PotatoPeaSea/Rocky/README.md

# Rocky — pentapod walker

Five-legged walking robot inspired by Rocky (Project Hail Mary).

- `fusion/` — Fusion 360 build scripts and BOM
- `pcb/` — integrated control PCB (KiCad): schematic, layout, STEP, fab outputs
- `sim/` — MuJoCo model and RL training environment
- `docs/` — design notes
