PotatoPeaSea/Rocky/pcb/rocky_ctrl/DESIGN.md

# Rocky control board v1 (`rocky_ctrl`)

This is the integrated controller for the Rocky pentapod (v6). It replaces the v5 module stack: ESP32-DevKitC, BusLinker V3, WAGO hub, LM2596, Pololu D36V50F5, the inline fuse and the battery divider. It is a single ring-shaped board that sits on the logic deck around the Raspberry Pi 5.

| | |
|---|---|
| Outline | Ø156 mm ring (r 78) with a Pi 5 cut-out (x −53..40, y −31..30), a Pi USB-C plug notch (x −47..−31, y −50..−31) and a battery-lead notch over deck hole B (x −8..8, y < −60) |
| Stack-up | 4 layers, 1.6 mm, 1 oz outer / 1 oz inner (JLC "1 oz inner" option). L1 signals + pours, L2 GND plane, L3 VSERVO plane, L4 signals + GND pour |
| MCU | ESP32-WROOM-32E-N8 (classic ESP32: BT Classic for Bluepad32, v5 firmware ports directly) |
| Servo I/O | 2 half-duplex UART buses (bus A = UART1: legs 1-3; bus B = UART2: legs 4-5), 5 × Molex SPOX 5267-03A leg connectors |
| Power | XT60 in → 20 A ATM blade fuse → P-FET reverse-polarity protection → (a) ESP32-switched, soft-started servo rail with 1 mΩ / INA180 current sense and 2 × 1000 µF, (b) 5 V / 5 A buck for the Pi 5 (TPS54560B), (c) 3.3 V / 2 A buck (AP63203, diode-OR battery / USB) |
| Software | KiCad 9.0 (files are KiCad 9 format; KiCad 8 cannot open them) |

Everything in the project (schematic, board, custom symbols, 3D models) is generated by the scripts in `tools/`, and the generators are the source of truth. Edit `tools/design.py` (parts and nets) or `tools/placement.py` (positions), then rebuild (see the end of this file). You can also edit the board by hand in KiCad from here on: nothing depends on the scripts once the files exist.

---

## 1. Block diagram

```
 3S LiPo ──XT60 loop key──► J1 XT60PW-M ──► F1 20 A ATM ──► D1 SMBJ15A TVS
                                                   │
                                     Q1 P-FET (reverse polarity, 3 mΩ, bidirectional so servo regen returns to the pack)
                                                   │ VBAT_P (9-12.6 V)
         ┌─────────────────────────────┬───────────┴──────────────┬──────────────────────────────┐
         ▼                             ▼                          ▼                              ▼
 Q2 P-FET high-side switch     U2 TPS54560B buck          D3 ┐ diode-OR                 R11/R12 → IO34 (VBAT)
 (Miller soft-start,           500 kHz, 5.09 V / 5 A      D4 ┘◄─ USB VBUS
  default OFF, IO23)                   │                    │ V_LOGIC
         │ VSERVO_SW                   ▼ +5V                ▼
 R6 1 mΩ shunt ─ U1 INA180A3 → IO35    J2 VH-3 → USB-C       U3 AP63203 → +3V3 (ESP32, CH340C, logic)
         │ VSERVO (In2 plane)          pigtail → Pi 5
   2 × 1000 µF + 22 µF / leg           JP1 → VIO (bus level 3.3 V default / 5 V)
         │
 J5..J9 leg connectors (GND, VSERVO, SIG)
         ▲ SIG_Ln (33 Ω + ESD)
 bus A ── U8 SN74LV1T126 (TX, OE=RTS) / U9 SN74LV1T125 (RX, OE#=RTS) ── UART1 (IO17/IO16/IO4)   legs 1,2,3
 bus B ── U10 / U11                                                  ── UART2 (IO25/IO26/IO27)  legs 4,5

 USB-C J3 ─ USBLC6 ─ CH340C ─┬─ auto-reset (2 × MMBT3904) → EN / IO0
                             └─ TXD ─► U6 74LVC1G3157 mux ─► ESP RXD0     (USB present → USB, else Pi)
 Pi 5 GPIO pins 5-14 ◄─ 2×5 ribbon ─ J4: GPIO14/15 UART ↔ UART0, GPIO17 → EN, GPIO27 → IO0, GPIO4 ← IO32
 IMU: Adafruit BNO085 breakout on the v5 IMU bosses, STEMMA QT J10 (I2C IO21/22) + J11 INT/RST (IO19/IO18)
```

---

## 2. Research findings: HX-30HM servo and Hiwonder bus

These were open items in v5. Confidence: **H** = published spec, **M** = consistent across Hiwonder sources but not stated for the HX-30HM specifically, **L** = inferred; measure before relying on it.

| Item | Finding | Conf. | Source |
|---|---|---|---|
| Supply voltage | 9-12.6 V (rated torque 30 kg·cm at 11.1 V), so a 3S pack connects directly | H | [OpenELAB HX-30HM page](https://openelab.io/products/hx-30hm-bus-servo) |
| Stall / no-load current | 3 A stall, 100 mA no-load | H | same |
| Connector | 5264-3P (Molex Mini-SPOX 2.50 mm family), 20 cm cable. **The board uses Molex 5267-03A vertical headers, which mate 5264 housings.** | H | same |
| Pin order | GND, VIN, SIG (as on the LX-224HV, the same Hiwonder bus-servo family). The board uses **pin 1 = GND, 2 = VSERVO, 3 = SIG**. Servo-to-servo cables are 1:1, so the header must match the servo's own port: **check the polarity with a meter on one servo before powering a leg**. | M | [LX-224HV manual (RobotShop)](https://cdn.robotshop.com/rbm/a5e9ab51-86bc-497b-adac-003de3088fb7/e/e63d140f-02bf-40ae-b653-378edf7a3fa0/10d5cb4c_lx-224hv-serial-bus-servo.pdf) |
| Bus | Single-wire half-duplex asynchronous UART, 8N1. Hiwonder frame `0x55 0x55 ID LEN CMD params… CHK`, with checksum = ~(ID+LEN+CMD+params). Up to 253 IDs. | H (family) | [LewanSoul/Hiwonder bus servo protocol](https://images-na.ssl-images-amazon.com/images/I/71WyZDfQwkL.pdf), [Bus Servo Controller docs](https://docs.hiwonder.com/projects/Bus-Servo-Controller/en/latest/docs/2.Bus_Servo_Controller_Secondary_Development.html) |
| Baud | **1,000,000 bps default** for the HX-30HM (older LX servos use 115200). The BusLinker V3 supports 8 baud settings up to 1 Mbps, and Hiwonder's own ESP32 example runs `SerialServo(Serial1, 1000000, …)` on GPIO16/17. | H | [OpenELAB HX-30HM page](https://openelab.io/products/hx-30hm-bus-servo), [BusLinker V3 manual](https://docs.hiwonder.com/projects/BusLinker/en/latest/docs/1_BusLinker_V3.0_Servo_Debugging_Board_User_Manual.html), [BusLinker ESP32 development](https://docs.hiwonder.com/projects/BusLinker/en/latest/docs/2_ESP32_Development.html) |
| Logic level | Not published. Hiwonder wires an ESP32 (3.3 V) straight to the BusLinker TTL port, and their single-servo debug guide shorts a USB-TTL adapter's TXD and RXD onto SIG. The servo therefore accepts 3.3 V signalling, and its input is very likely 5 V tolerant. **The board defaults to a 3.3 V bus, with a solder jumper (JP1) for 5 V.** | L/M | [Hiwonder forum: single bus servo with USB-TTL](https://forum.hiwonder.com/t/debugging-procedure-for-single-serial-bus-servos-with-a-usb-to-ttl-module/190) |
| BusLinker half-duplex circuit | Not documented by Hiwonder. Community reverse engineering and the classic LewanSoul reference use a tri-state buffer pair (74HC126 drives TX onto the line when enabled, 74HC125 returns the line to RX) on a single direction line, which echoes TX. This board uses the same topology with the TI SN74LV1T126/125 level-shifting single gates (TTL-threshold inputs, 5.5 V tolerant), so it works at either VIO. | M | [HiWonder BusLinker servo-bus notes](https://github.com/EtcetFelix/HiWonder-BusLinker-servo-bus), [74HC125/126 datasheet](https://static.chipdip.ru/lib/199/DOC030199307.pdf) |
| BusLinker V3 supply | 5-14 V, and it passes the external supply through to the servo ports | H | BusLinker V3 manual (above) |

**Recommended bring-up test (5 min):** connect a single servo to leg 1, keep VIO at 3.3 V and run `SERVO_ID_READ` at 1 Mbps. If replies are flaky over the 20 cm + leg cable, bridge JP1 to 5 V.

### Why two UART buses
At 1 Mbps a Hiwonder move command is 10 bytes (100 µs) and a position read is 6 bytes out plus 8 back, plus about 50-100 µs turnaround (≈ 250-300 µs). A full cycle on one bus (15 writes + 15 reads) takes about 6 ms, so roughly 150 Hz. Splitting legs 1-3 (IDs 1-9) on UART1 and legs 4-5 (IDs 10-15) on UART2 roughly halves that, giving a 250-300 Hz control loop. It also isolates a shorted or unplugged leg cable to one bus. The ESP32 has only three UARTs and UART0 is the console/Pi link, so two buses is the maximum. Use ESP-IDF `UART_MODE_RS485_HALF_DUPLEX` with RTS on IO4 and IO27: the driver raises RTS during TX, which enables the '126 driver and tri-states the '125 receiver. That suppresses the echo, and the 10 k pull-up on the RX pin keeps it idle.

---

## 3. Power and current budget

| Load | Typical | Peak | Worst case / design limit |
|---|---|---|---|
| 15 × HX-30HM | 0.1 A each idle (1.5 A); about 5-10 A total walking (estimate) | 15-20 A for brief bursts (many joints accelerating) | 45 A if all stall. This is not sustainable: the 20 A fuse and firmware current limiting (INA180) bound it. |
| Raspberry Pi 5 + cooler (5 V) | 1.5-3 A | 5 A | 5 V × 5 A / 0.88 / 9.6 V ≈ **3.0 A from the pack** |
| ESP32 + CH340 + logic (3.3 V) | 0.1-0.25 A | 0.5 A (BT TX) | about 0.2 A from the pack |
| **Total through F1** | 7-13 A | ≈ 20 A | **20 A fuse** (ATM mini blade; 200 % is held for 0.15-5 s, so stall bursts pass and sustained overload opens) |

- **Fuse:** 20 A is the v5 value and matches 14 AWG pack wiring and the XT60 (30 A continuous). A 25 A blade fits the same holder if 20 A proves nuisance-prone. The fuse protects the wiring; firmware should limit servo current: trip `SERVO_EN` low at a sustained ISERVO > 15 A.
- **Copper (IPC-2221, external, 1 oz, ΔT ≈ 20 °C):** about 3.7 A per mm of width.
  - **XT60 → fuse → Q1:** 4 mm tracks duplicated on F.Cu and B.Cu inside pours roughly 8 mm wide on both layers, so ≥ 25 A continuous. Path length is under 25 mm.
  - **Q1 → Q2 (VBAT_P):** F.Cu pour (3 mm) plus 2.4 mm F/B tracks plus a 5 mm B.Cu pour joined by 4 vias. About 20 A, and only 10 mm long.
  - **Q2 → shunt (VSERVO_SW):** about 4 mm F.Cu pour over 5 mm. About 15 A continuous, 20 A transient. This is the weakest section; see the risks.
  - **Shunt → servo plane:** 9 × 0.8/0.4 mm vias (≈ 1.5-2 A each) into the L3 VSERVO plane. The plane is a 17-40 mm wide 1 oz ring, about 2 mΩ to the farthest leg along the two parallel paths, so under 30 mV drop at 10 A.
  - **Leg connectors:** THT pins tie directly into the VSERVO plane, with GND to the L2 plane and both outer pours.
- **Per leg:** up to 9 A stall (3 servos), but each SPOX/5264 contact is rated about 3 A. That is the same limit as the servo's own chain connector, so the board is not the bottleneck. Normal walking is 1-3 A per leg.
- **Bulk capacitance (servo rail):** 2 × 1000 µF / 35 V low-ESR (Panasonic FR 12.5×20; about 20 mΩ and 2.2 A ripple each) plus 22 µF ceramic at every leg connector and 10 µF at the switch.
  - **Sizing:** the battery lead plus loop key is about 250 mm of 14 AWG pair, roughly 0.3-0.5 µH and 20-30 mΩ. For a 10 A load step and ≤ 0.5 V droop the rail needs Z ≤ 50 mΩ, and C ≥ L/Z² ≈ 0.5 µH / (0.05 Ω)² ≈ 200 µF to damp the cable LC. 2000 µF gives a 10× margin and absorbs regenerated energy.
  - **Regenerated energy:** when the rail is switched off, back-driven servos push current through Q2's body diode into VBAT_P and on into the battery, because Q1 is a plain P-FET (not an ideal diode) and conducts both ways. With the battery unplugged, 2000 µF from 12.6 V to 16 V absorbs 0.1 J, and D1 clamps above that.
- **Soft start:** Q2's gate ramps through 33 kΩ into 220 nF of Miller capacitance, about 1.2 V/ms. Charging 2 mF therefore draws ≈ 2.5 A of inrush for about 10 ms instead of a spark. Turn-off takes about 20-30 ms (100 k gate pull-up), which is fine for an e-stop.
- **5 V buck (TPS54560B):** 4.5-60 V in, 5 A, external Schottky. Settings: 500 kHz (RT 191 k), Vout = 0.8 × (1 + 53.6/10) = 5.09 V, L = 4.7 µH SRP1245A (Isat 21 A), Cout 4 × 22 µF, type-II compensation 16 k / 3.9 nF / 39 pF (crossover ≈ 40 kHz), EN UVLO ≈ 7.9 V on and 7.6 V off.
  - About 88 % efficient at 5 A, with ≈ 1.2 W in D2.
  - **Verify the compensation in TI WEBENCH or with a load step.**
- **Pi 5 power path:** the board drives the Pi's own USB-C input (through its protection and PMIC) with a short USB-C plug pigtail from J2 (JST VH-3: 5 V / GND / CC). J2 pin 3 presents Rp = 10 k (3 A Type-C advertisement) if the pigtail has a CC wire. There is no USB-PD, so the Pi sees a non-5 A supply.
  - Put `usb_max_current_enable=1` in `/boot/firmware/config.txt`, or `PSU_MAX_CURRENT=5000` in the EEPROM (`rpi-eeprom-config`). Otherwise the Pi limits its USB ports to 600 mA and warns at boot.
  - Feeding the GPIO 5 V pins was rejected: it bypasses the Pi's input protection, and a 2.54 mm ribbon cannot carry 5 A.
  - The 2×5 ribbon carries no 5 V.
  - The ESP32 can cut the Pi supply (IO33 → Q4 pulls EN low; the default is Pi on).
- **3.3 V (AP63203, 2 A):** fed from VBAT_P or USB VBUS through two SS34 diodes. The ESP32 can therefore be flashed or debugged from USB alone (servo rail and Pi off), and the logic stays up if the Pi buck is disabled.

---

## 4. ESP32 pin map

| ESP32 | Net | Function |
|---|---|---|
| EN | EN | Reset: 10 k/1 µF RC, EN button, CH340 auto-reset, and Pi GPIO17 via 2N7002 |
| IO0 | BOOT | Strap. BOOT button, CH340 auto-reset, and Pi GPIO27 via 2N7002 |
| IO1 / TXD0 | ESP_TX0 | UART0 TX to CH340C RXD and (through 1 k) Pi GPIO15/RXD |
| IO3 / RXD0 | ESP_RX0 | UART0 RX from the 74LVC1G3157 mux: CH340C when USB VBUS is present, otherwise Pi GPIO14/TXD |
| IO2 | LED_STAT | Strap (must be low or floating at boot; an LED to GND is fine). Blue status LED |
| IO4 | BUSA_DIR | UART1 RTS (RS485 half-duplex mode): high = transmit on bus A |
| IO16 | BUSA_RX | UART1 RX (bus A: legs 1-3, servo IDs 1-9) |
| IO17 | BUSA_TX | UART1 TX |
| IO25 | BUSB_TX | UART2 TX (bus B: legs 4-5, servo IDs 10-15) |
| IO26 | BUSB_RX | UART2 RX |
| IO27 | BUSB_DIR | UART2 RTS: high = transmit on bus B |
| IO23 | SERVO_EN | Servo rail enable, active high, 100 k pull-down (off at reset and in boot mode) |
| IO33 | PI_PWR_OFF | High = 5 V Pi buck disabled (100 k pull-down: Pi on by default) |
| IO32 | PI_ATTN | ESP32 → Pi GPIO4 attention/IRQ line (1 k series) |
| IO21 | SDA | I2C SDA (STEMMA QT IMU, spare header), 4.7 k pull-up |
| IO22 | SCL | I2C SCL, 4.7 k pull-up |
| IO19 | IMU_INT | BNO085 INT (10 k pull-up) |
| IO18 | IMU_RST | BNO085 RST |
| IO34 | VBAT_SENSE | ADC1_CH6: battery through 100 k/22 k (12.6 V → 2.27 V) |
| IO35 | ISERVO | ADC1_CH7: servo current, INA180A3 × 1 mΩ = 100 mV/A (0-24 A) |
| IO36 / SENSOR_VP | V5_SENSE | ADC1_CH0: 5 V rail through 22 k/10 k (5.1 V → 1.59 V) |
| IO39 / SENSOR_VN | VSRV_SENSE | ADC1_CH3: switched servo rail through 100 k/22 k (confirms SERVO_EN) |
| IO13 | LED_USER | Yellow user LED |
| IO5 | GPIO5 | Spare header (strap: keep high or floating at boot) |
| IO14 | GPIO14 | Spare header |
| IO15 | GPIO15 | Spare header (strap: boot-log enable) |
| IO12 | – | Not connected (strap MTDI must be low at boot for 3.3 V flash) |

All analog inputs are on ADC1, so they keep working while Bluetooth (Bluepad32) is active. ADC2 is unavailable then.

---

## 5. Connectors

| Ref | Part | Pinout | Notes |
|---|---|---|---|
| J1 | AMASS XT60PW-M (right angle, PCB male) | 1 = GND (−), 2 = VBAT_IN (+) | The mouth faces west (−x). Mate it with the female XT60 on the loop-key lead coming up through deck hole B. |
| F1 | Keystone 3568 mini-blade holder | – | 20 A ATM mini blade fuse |
| J2 | JST B3P-VH-B (3.96 mm) | 1 = +5V, 2 = GND, 3 = PI_CC (Rp 10 k to 5 V) | To a USB-C *plug* pigtail into the Pi 5 power port, 20 AWG, about 8 cm. Leave CC open if the pigtail has no CC wire. |
| J3 | HRO TYPE-C-31-M-12 | USB 2.0 with 5.1 k Rd on CC1/CC2 | ESP32 programming and console. Reach it with the dome off. |
| J4 | 2×5 2.54 mm box header (IDC) | 1 NC (Pi SCL), 2 GND, 3 PI_GPIO4, 4 Pi TXD (GPIO14), 5 GND, 6 Pi RXD (GPIO15), 7 GPIO17 → ESP EN, 8 NC, 9 GPIO27 → ESP IO0, 10 GND | Straight 10-way ribbon. **The Pi-end IDC socket goes on Pi header pins 5-14**, so board pin n = Pi pin n+4 and pin 1 of the socket sits on Pi pin 5. |
| J5-J9 | Molex 5267-03A (SPOX 2.50 mm, mates the 5264 servo plug) | 1 = GND, 2 = VSERVO, 3 = SIG | J5 = leg 1, J6 = leg 2, J7 = leg 3 (bus A); J8 = leg 4, J9 = leg 5 (bus B). Leg numbers are silkscreened. |
| J10 | JST SM04B-SRSS-TB (STEMMA QT) | 1 GND, 2 3V3, 3 SDA, 4 SCL | To the Adafruit BNO085 breakout |
| J11 | 1×2 2.54 mm header | 1 IMU_INT, 2 IMU_RST | Jumper wires to the breakout's INT and RST pins |
| J12 | 1×8 2.54 mm header | 1 3V3, 2 GND, 3 SDA, 4 SCL, 5 IO5, 6 IO14, 7 IO15, 8 +5V | Spare I/O |
| JP1 | 3-pad solder jumper | 1-2 bridged by default = VIO 3.3 V; cut it and bridge 2-3 for a 5 V bus | Bus logic level (TX drivers and bus pull-ups) |
| TP1-TP13 | 1.5 mm test pads | VBAT_F, VBAT_P, VSERVO, 5V, 3V3, GND×2, BUSA, BUSB, V_LOGIC, ESP_TX0, ESP_RX0, ISERVO | |

LEDs: green 3V3 (LED1), green 5V (LED2), red SERVO POWER (LED3, lit whenever VSERVO is live), blue status IO2 (LED4), yellow user IO13 (LED5).

---

## 6. Mechanical placement (robot model frame)

The frame is the v6 model frame: the origin is the body centre on the hip-servo plane, +z is up, leg 1 is on +y, and angles are CCW from +x.

- **Board origin:** the board centre is at robot (0, 0). The KiCad file uses (150, 150) mm for that point; the board X axis is robot +x and KiCad +Y is robot −y.
- **STEP origin:** `rocky_ctrl.step` (and `C:\Users\smart\Documents\Pentapod\hardware\rocky_control_pcb.step`) is exported with `--user-origin 150x150mm`. **STEP x, y = robot x, y**, and the **board underside (laminate bottom) is at STEP z = 0**; the top is at z ≈ 1.6.
- **Placement in Fusion:**

  ```
  PCB_ORIGIN = (0, 0, 60.5)   # mm: board underside on the existing v5 boss tops (deck top 55.5 + 5)
  PCB_ROT    = 0              # deg about z
  ```

  The board is coplanar with the Pi 5 (Pi underside also at z 60.5). The top copper is at z 62.1.
- **Mounting holes** (all on existing v6 deck bosses, so no deck changes are needed):

| Holes | Robot (x, y) | Size | Boss |
|---|---|---|---|
| H3, H4 | (−18, −35.5), (18, −35.5) | M2.5 (Ø2.7) | BL bosses (Ø6, top z 60.5) |
| H5-H8 | (−30.8, 38.2), (−30.8, 63.8), (34.8, 38.2), (34.8, 63.8) | M2 (Ø2.2) | PB bosses (Ø5.2) |
| H9-H12 | (−58.46, 32.56), (−58.46, 50.34), (−38.14, 32.56), (−38.14, 50.34) | M2.5 (Ø2.7) | IMU bosses. Long M2.5 screws go through the Adafruit BNO085 breakout, a 6 mm spacer and the PCB into the boss, so the IMU sits exactly where it was in v5. |

  The BL bosses at (±18, −63.5) are not used as screw points (the XT60 and the 5 V output caps sit over them), but the board rests on them and no THT pin is placed over them. The Pololu bosses are unused and lie inside the Pi cut-out or the free area.
- **Standoff height:** 0. The board sits directly on the 5 mm deck bosses (5 mm air gap to the deck). There are no bottom-side parts; THT leads protrude ≤ 2 mm.
- **Tallest parts (above the board top, z 62.1):**
  - C6 and C7 1000 µF at 20.3 mm (top ≈ z 82.4; C6 at r 70, C7 at r 68; dome inner surface ≥ 93 there)
  - J2 VH at 11.5 mm
  - F1 with fuse at about 17 mm
  - C1 at 11.8 mm
  - XT60 at 8.3 mm
  - the IMU breakout on 6 mm spacers at about 9 mm

  Everything is within the envelope report's ≤ 25 mm rim and ≤ 35 mm (r < 60) limits.
- **Leg connectors** (centre of the 3 pins, rotated tangentially, so the cable leaves outward over the deck edge):

| Leg | angle | (x, y) |
|---|---|---|
| 1 | 90° | (0.00, 72.50) |
| 2 | 162° | (−68.95, 22.40) |
| 3 | 234° | (−42.61, −58.65) |
| 4 | 306° | (42.61, −58.65) |
| 5 | 24° (moved +6° to clear the ESP32 antenna keep-out) | (66.23, 29.49) |

- **Battery input:** the loop-key lead (14 AWG) comes up through deck hole B (0, −71) and the board notch, bends about 90°, and the XT60 plug (body about x −2..10, y −62) mates J1, whose mouth is at x ≈ 10 facing −x.
- **Pi power:** the USB-C pigtail plug sits in the notch x −47..−31, y −50..−31. Use a **straight** plug, or a right-angle plug whose cable exits downward/−y. The v5 right-angle pigtail (cable toward −x) does not fit. The pigtail cable then goes to J2 at (−25, −59.5).
- **Pi link ribbon:** J4 at (−15, 38) to Pi header pins 5-14 (x −37..−27, y 23-26, pin tops z 70.4), about 40 mm of ribbon.
- **ESP32 antenna:** points +x at the east edge (x 70-78, y −2..22). There is a no-copper keep-out on all layers, and the dome is plastic.

---

## 7. Fabrication (JLCPCB)

- `fab/rocky_ctrl_gerbers.zip`: Gerbers + Excellon drill, 4 layers. Order with 1.6 mm, 1 oz outer, **1 oz inner** (or 0.5 oz inner: the VSERVO plane then has double the resistance, about 4 mΩ worst case, still fine), any colour, "specify layer sequence" = F.Cu, In1.GND, In2.PWR, B.Cu.
- `fab/rocky_ctrl_bom_jlc.csv` (Comment, Designator, Footprint, LCSC) and `fab/rocky_ctrl_cpl_jlc.csv` (Designator, Mid X, Mid Y, Layer, Rotation). All parts are top side.
- LCSC numbers are filled in only where they could be confirmed offline; the LCSC website was not reachable from the build machine. The remaining parts have a manufacturer part number in the `MPN` column. Assign LCSC codes for them in JLC's BOM tool, or hand-solder them.
- THT parts are better hand-soldered, or ordered with JLC THT assembly: J1, F1, J2, J4, J5-J9, J11, J12, C1, C6, C7.
- **CPL rotations:** check the preview in JLC's viewer. KiCad-to-JLC rotation offsets typically need fixing for SOT-23, SOIC and the ESP32.
- `fab/rocky_ctrl_schematic.pdf`, `fab/rocky_ctrl_top.png` / `_bottom.png` renders, `fab/*.svg` layer plots, `fab/erc.rpt`, `fab/drc.rpt`.

---

## 8. Firmware notes

- UART1: `uart_set_pin(UART_NUM_1, 17, 16, 4, -1)`, then `uart_set_mode(UART_NUM_1, UART_MODE_RS485_HALF_DUPLEX)`, at 1,000,000 baud. UART2 is the same with pins 25/26/27.
- Turn the servo rail on with `SERVO_EN` (IO23) high **after** checking VBAT_SENSE. Then wait about 30 ms for the soft start and confirm VSRV_SENSE ≈ VBAT.
- Current guard: ISERVO (IO35) gives 100 mV/A. Trip at > 15 A for 200 ms or > 22 A for 20 ms, then drop SERVO_EN.
- Battery: 3S cut-off at 9.6 V (3.2 V/cell). Warn at 10.5 V. The Pi buck's UVLO (≈ 7.9 V) is only a last resort.
- Pi-side flashing: from the Pi, `esptool.py --port /dev/ttyAMA0 --before no_reset --after no_reset` after driving GPIO27 low and pulsing GPIO17 high (the 2N7002s invert, so a Pi GPIO high pulls the ESP pin low). Unplug the board's USB-C first, because USB wins the RX mux.
- The Pi's `config.txt` needs `enable_uart=1`, `dtparam=uart0=on` (GPIO14/15) and `usb_max_current_enable=1`.

---

## 9. Open risks and assumptions

1. **Servo pin order, logic level and baud are not measured.** Pin order comes from the Hiwonder LX family docs, and logic level from Hiwonder's 3.3 V wiring examples. Verify with one servo before plugging in a leg (see §2). If the HX-30HM port turns out to be SIG, VIN, GND, the board needs adapter leads, because the header footprint is symmetric and the pins would have to be swapped in `design.py`.
2. **Per-leg current through 2.5 mm SPOX contacts** (about 3 A each) is below a full-leg stall (9 A). This is inherent to the servo's chain connector. Firmware current limiting is the mitigation.
3. **VSERVO_SW section (Q2 → shunt)** is about 4 mm of single-layer copper. It is fine for 20 A transients and about 15 A continuous. If long stalls are expected, solder-tin the exposed area, or move to 2 oz outer copper (JLC option) without changing the layout.
4. **TPS54560B compensation** was hand-calculated for 4 × 22 µF (with derating). Verify with a 1-4 A load step on the bench, or in WEBENCH, before connecting the Pi.
5. **Simplified 3D models:** the XT60PW, VH, SPOX, HRO USB-C, SRP1245A, the tact switch and the 12.5/8 mm capacitors use simplified envelope models generated by `tools/make_3d.py`, because the Debian KiCad 3D package lacks them. Outer dimensions match the datasheets to about 0.5 mm.
6. **LCSC part numbers** are incomplete (see §7). Some parts (BSC030P03NS3, TPS54560B, SN74LV1T126, Keystone 3568, B540C, SRP1245A) may be JLC "extended" or need global sourcing. Equivalents that drop in with the same footprint:
   - any −30 V ≤ 4 mΩ P-FET in PG-TDSON-8 / PowerPAK SO-8 (e.g. Vishay SiRA99DP, AOS AONS21321)
   - any 4.7 µH ≥ 8 A 12×12 inductor
   - SS54 / B560C for D2
7. **Pi USB-C pigtail:** this is a bought cable. Confirm it fits the notch envelope (x −47..−31, y −50..−31, z 59..68).
8. **The ESP32 antenna** is close to the M3 tie-rod/magnet at post P5 (51.7, 71.2), about 50 mm away. BT range inside the plastic dome should be fine. If it is not, the ESP32-WROOM-32UE (U.FL) footprint variant is pin-compatible.
9. **Schematic:** the schematic is generated and label-based (functional blocks on one A1 sheet, nets joined by labels rather than drawn wires). It is electrically complete and ERC-clean, but less pretty than a hand-drawn one.

---

## 10. Verification status (2026-10-19)

- **ERC** (`fab/erc.rpt`, all severities): 0 errors, 0 warnings.
- **DRC** (`fab/drc.rpt`, with schematic parity): 0 errors, 0 unconnected pads, 0 footprint/parity issues. 29 silkscreen warnings remain (reference text clipped by the board edge or overlapping other silk), which are cosmetic. 27 crowded references are hidden on silk but still on F.Fab.
- **Signals:** routed by Freerouting 1.9 on F.Cu/B.Cu only. In1 (GND) and In2 (VSERVO) were declared power planes to the router, so they stay unbroken. A 0.45 mm track keep-out band runs along every edge.
- **Hand fixes after autorouting:** R20 +5V via + B.Cu link to J2, one rejoined +5V B.Cu segment, and 4 GND island vias (`tools/island_vias.py`). These were applied directly to the board, so a full regeneration from the scripts needs a fresh autoroute plus a DRC pass.

## 11. Regenerating

KiCad 9 Python (pcbnew) and a JDK for Freerouting are needed. From `pcb/rocky_ctrl/`:

```
python3 tools/gen_sch.py                                   # schematic + custom symbols
kicad-cli sch export netlist --format kicadsexpr -o /tmp/rocky.net rocky_ctrl.kicad_sch
python3 tools/gen_pcb.py /tmp/rocky.net                    # placed board, outline, holes, keep-outs
python3 tools/power_route.py                               # hand power copper + GND/VSERVO fan-out
tools/route.sh                                             # Freerouting 1.9 (signals only)
python3 tools/finish_pcb.py /tmp/rocky.ses                 # import routes, pours, stitching, fill
python3 tools/island_vias.py                               # stitch any GND pour island without a via
tools/export.sh                                            # ERC/DRC, STEP, Gerbers, BOM, CPL, PDF, renders
```

`tools/make_3d.py` (CadQuery) regenerates `3d/*.step`.
