PotatoPeaSea/Rocky/pcb/rocky_ctrl/RESUME.md

# PCB work: complete (2026-10-19 23:00)

Routing finished, ERC 0 / DRC 0 errors, exports in fab/ and rocky_ctrl.step. See DESIGN.md section 10.
