PotatoPeaSea/Rocky/docs/img/v5_before_iso.png

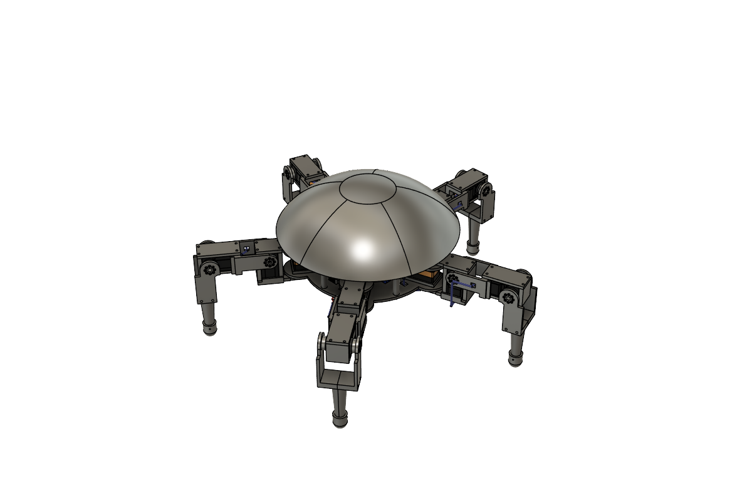
docs/img/v5_before_iso.png
