PotatoPeaSea/Rocky/docs/img/v5_before_top_nodome.png

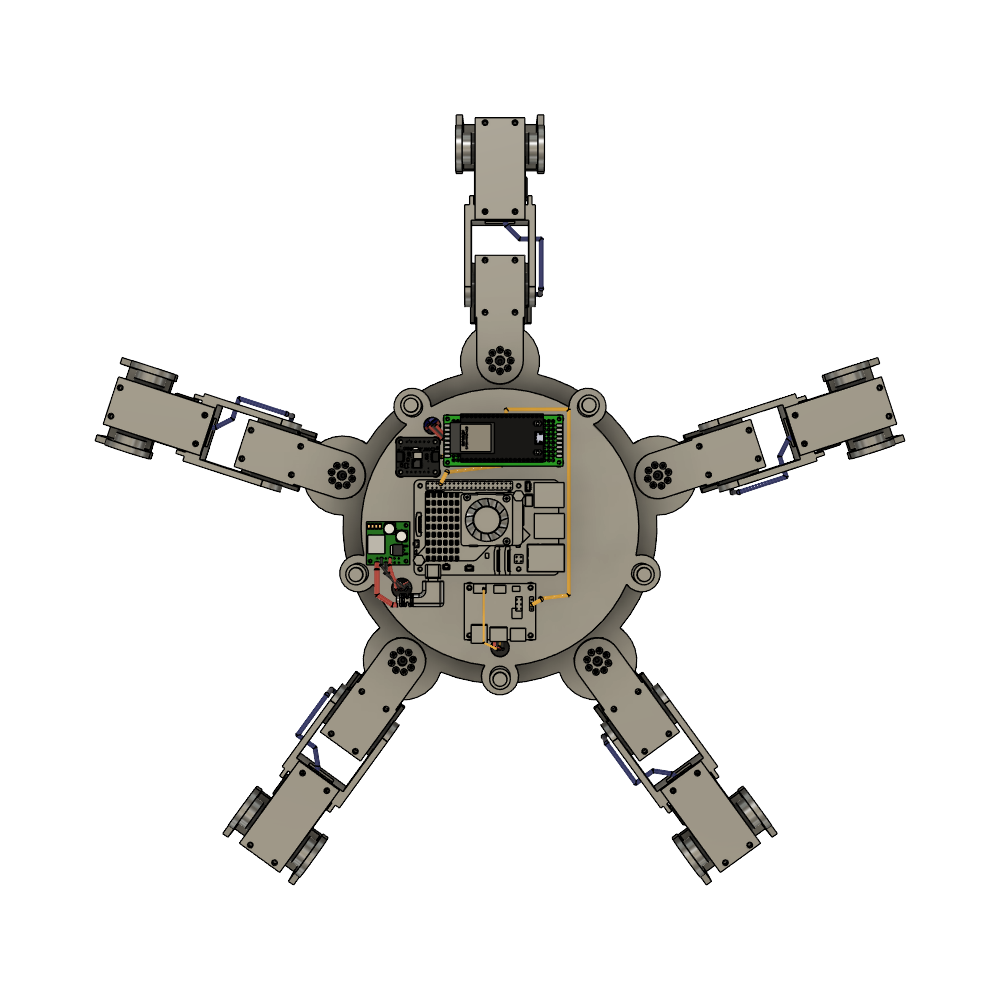
docs/img/v5_before_top_nodome.png
