PotatoPeaSea/Rocky/docs/img/v6_after_iso.png

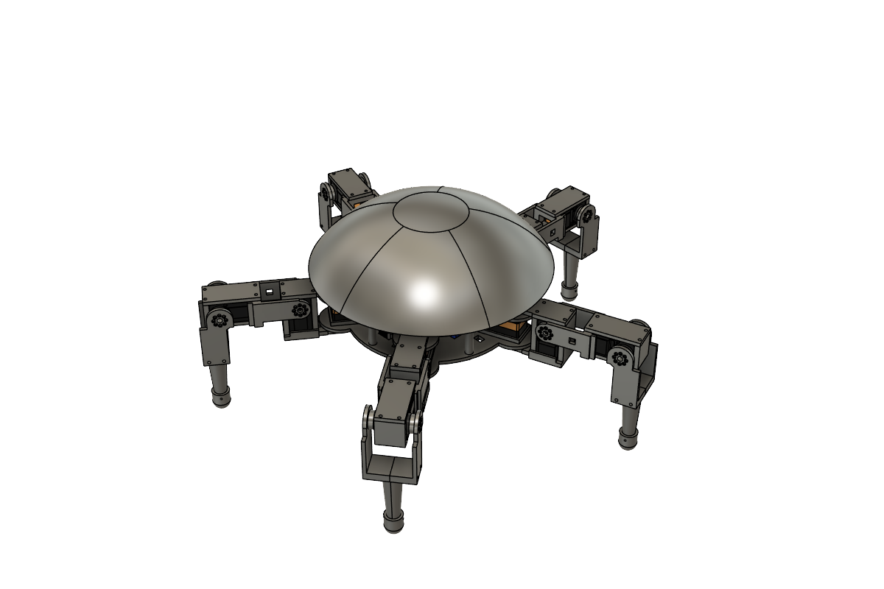
docs/img/v6_after_iso.png
