PotatoPeaSea/Rocky/docs/img/v7_camera_iso.png

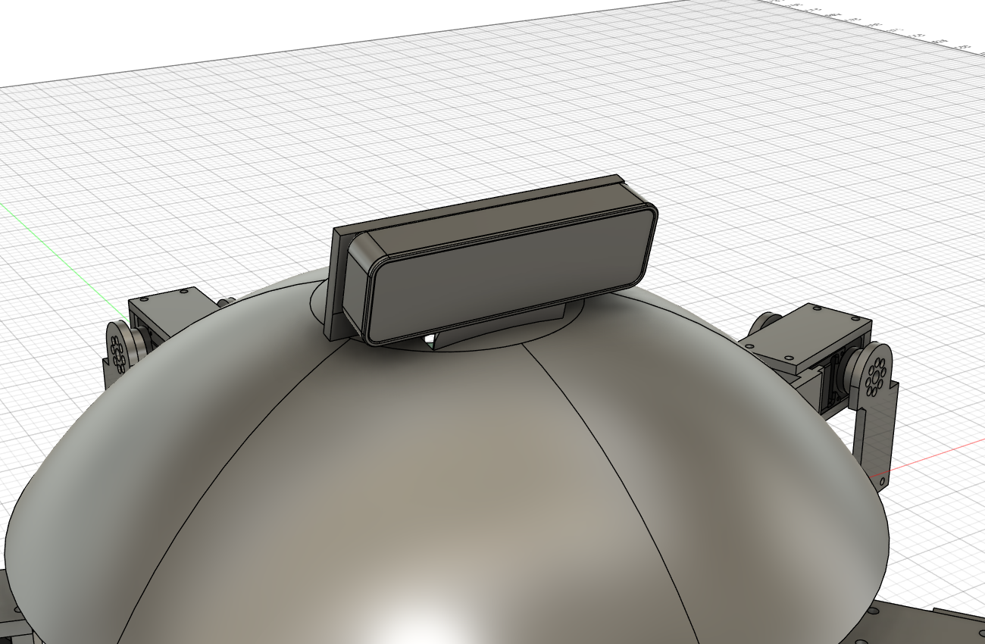
docs/img/v7_camera_iso.png
