PotatoPeaSea/Rocky/pcb/rocky_ctrl/fab/rocky_ctrl_bottom.png

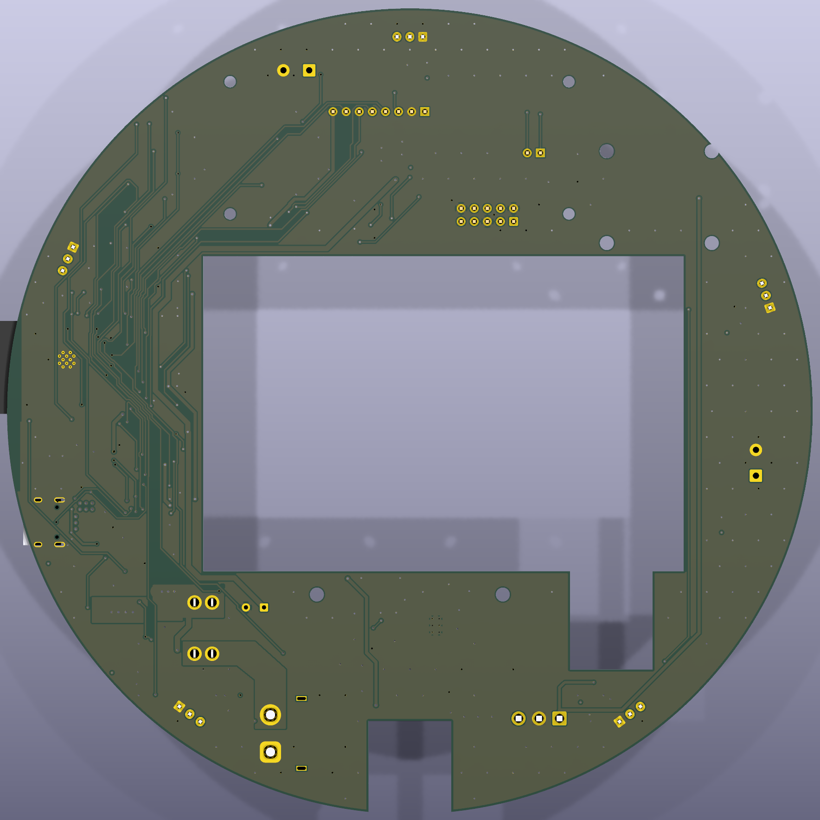
pcb/rocky_ctrl/fab/rocky_ctrl_bottom.png
