PotatoPeaSea/Rocky/pcb/rocky_ctrl/fab/rocky_ctrl_iso.png

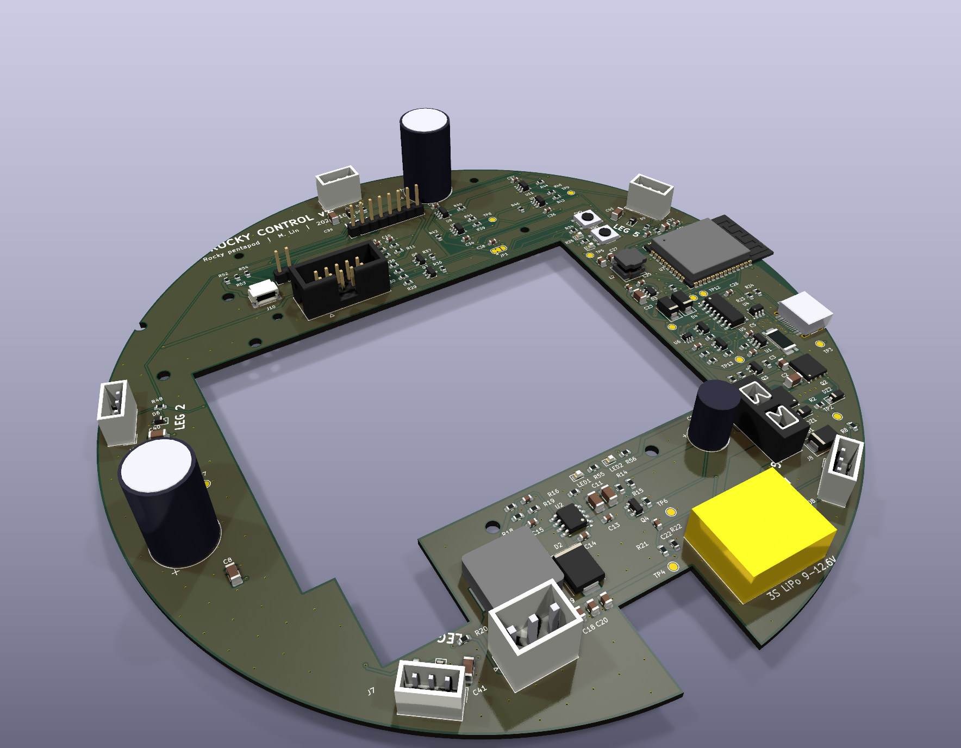
pcb/rocky_ctrl/fab/rocky_ctrl_iso.png
