PotatoPeaSea/Rocky/pcb/rocky_ctrl/fab/rocky_ctrl_top.png

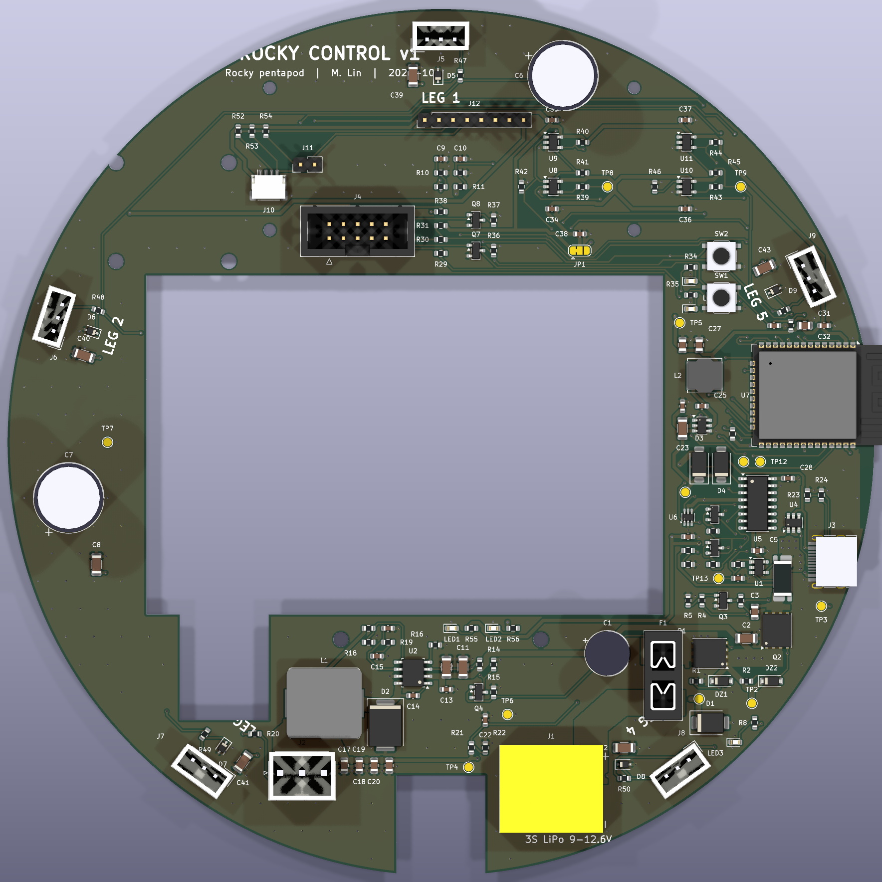
pcb/rocky_ctrl/fab/rocky_ctrl_top.png
