PotatoPeaSea/Rocky/sim/rocky_mujoco/media/collision_geoms.png

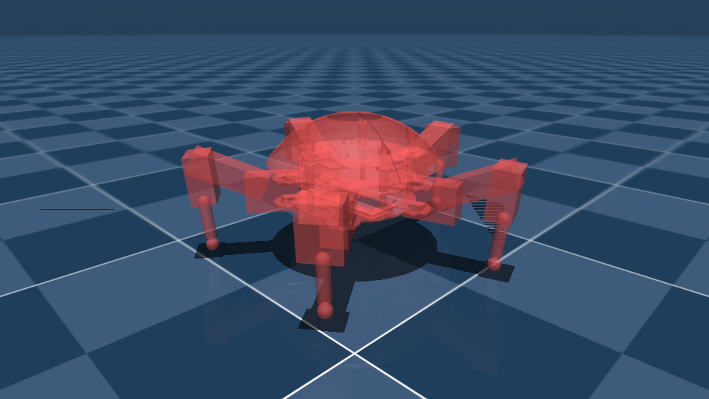
sim/rocky_mujoco/media/collision_geoms.png
