PotatoPeaSea/Rocky/sim/rocky_mujoco/media/elevation_map.png

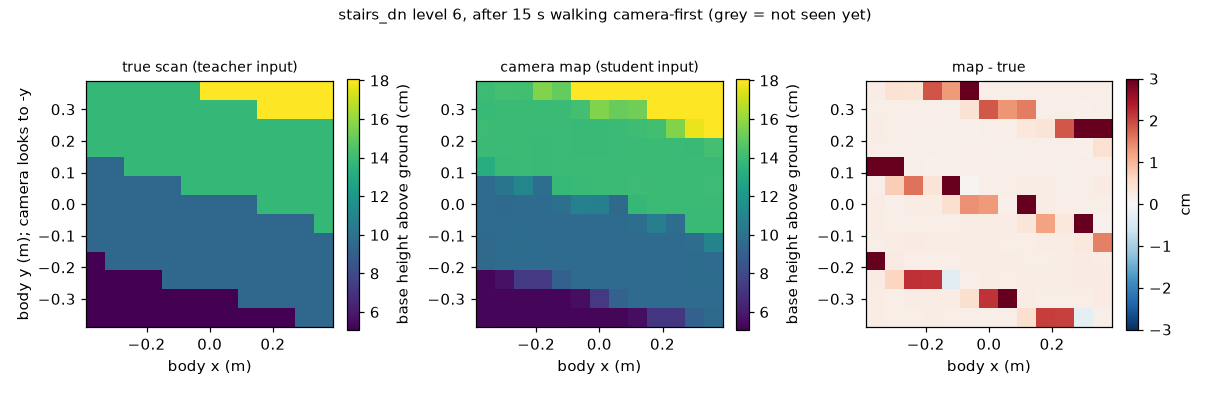
sim/rocky_mujoco/media/elevation_map.png
