PotatoPeaSea/Rocky/sim/rocky_mujoco/media/estimator_rough.png

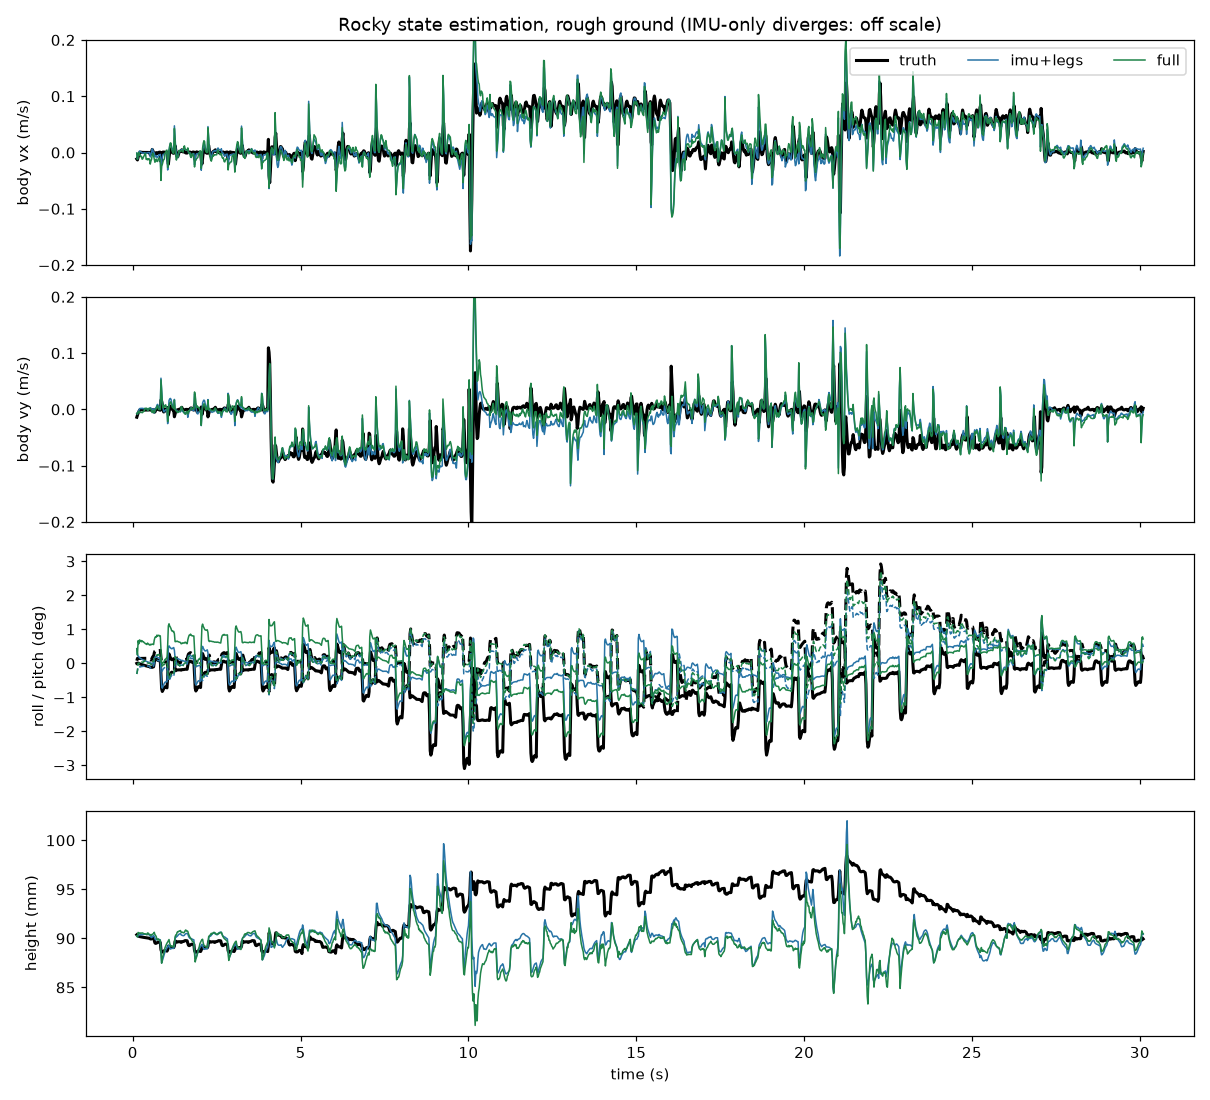
sim/rocky_mujoco/media/estimator_rough.png
