PotatoPeaSea/Rocky/sim/rocky_mujoco/media/no_dome_top.png

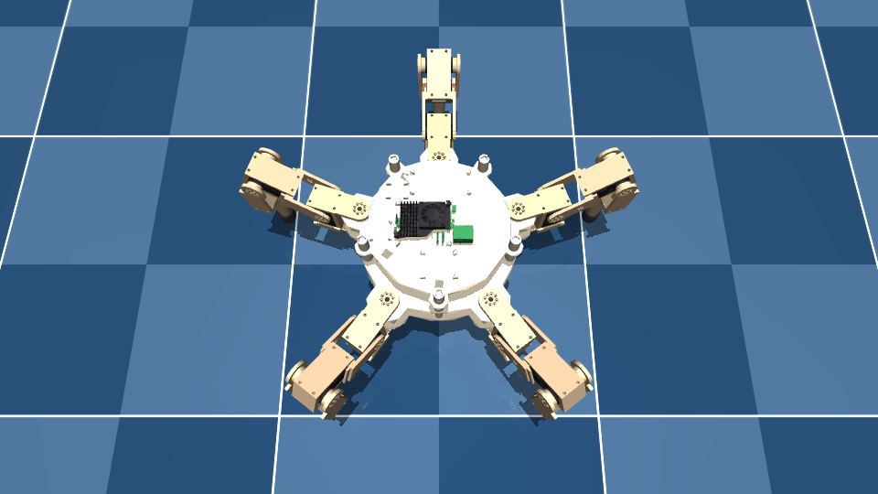
sim/rocky_mujoco/media/no_dome_top.png
