PotatoPeaSea/Rocky/sim/rocky_mujoco/media/stand_side.png

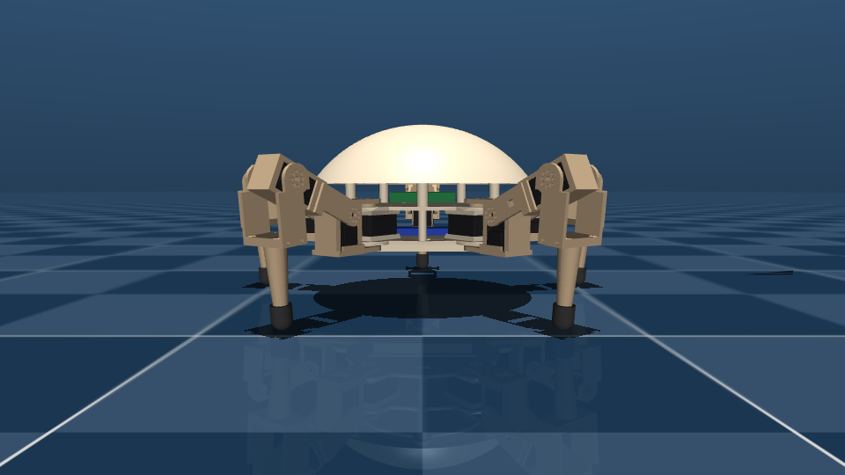
sim/rocky_mujoco/media/stand_side.png
