PotatoPeaSea/Rocky/sim/rocky_mujoco/media/terrain_overview.png

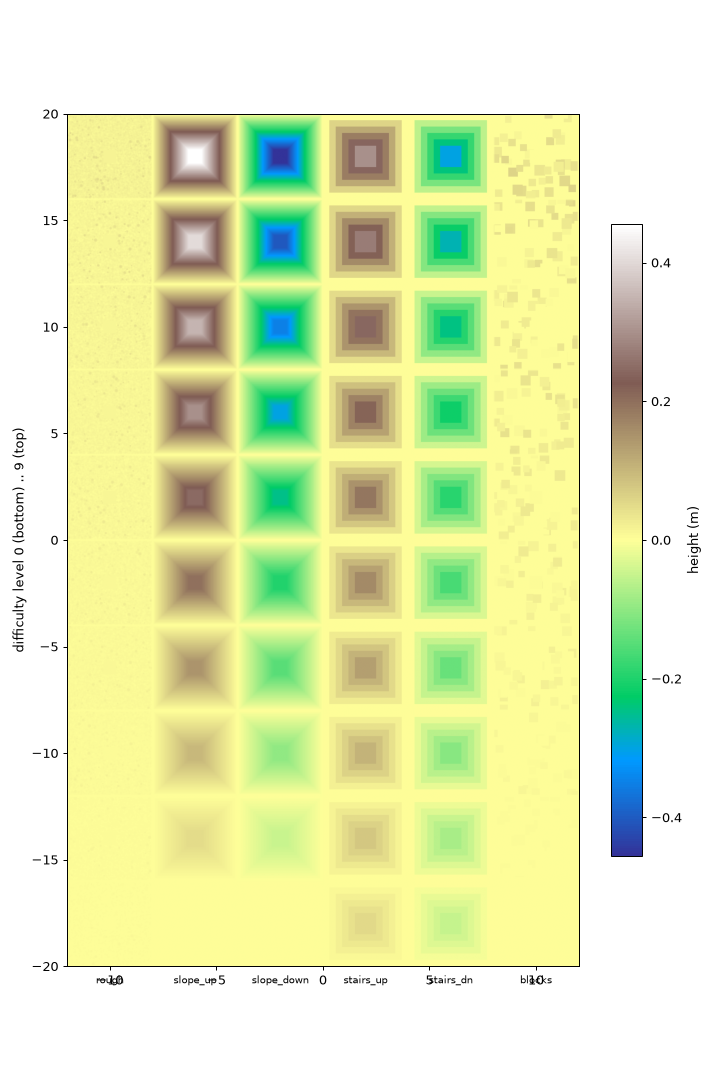
sim/rocky_mujoco/media/terrain_overview.png
