PotatoPeaSea/Rocky/sim/rocky_mujoco/media/training/gait1_contacts.png

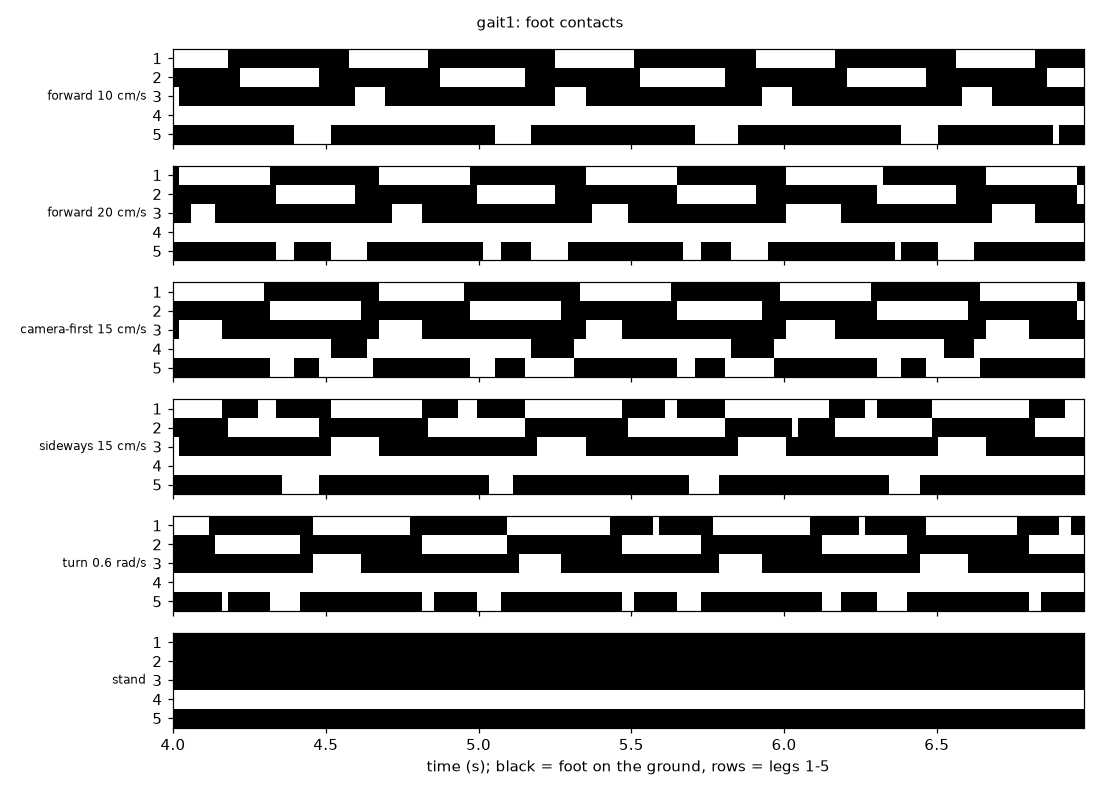
sim/rocky_mujoco/media/training/gait1_contacts.png
