PotatoPeaSea/Rocky/sim/rocky_mujoco/media/training/gait4_contacts.png

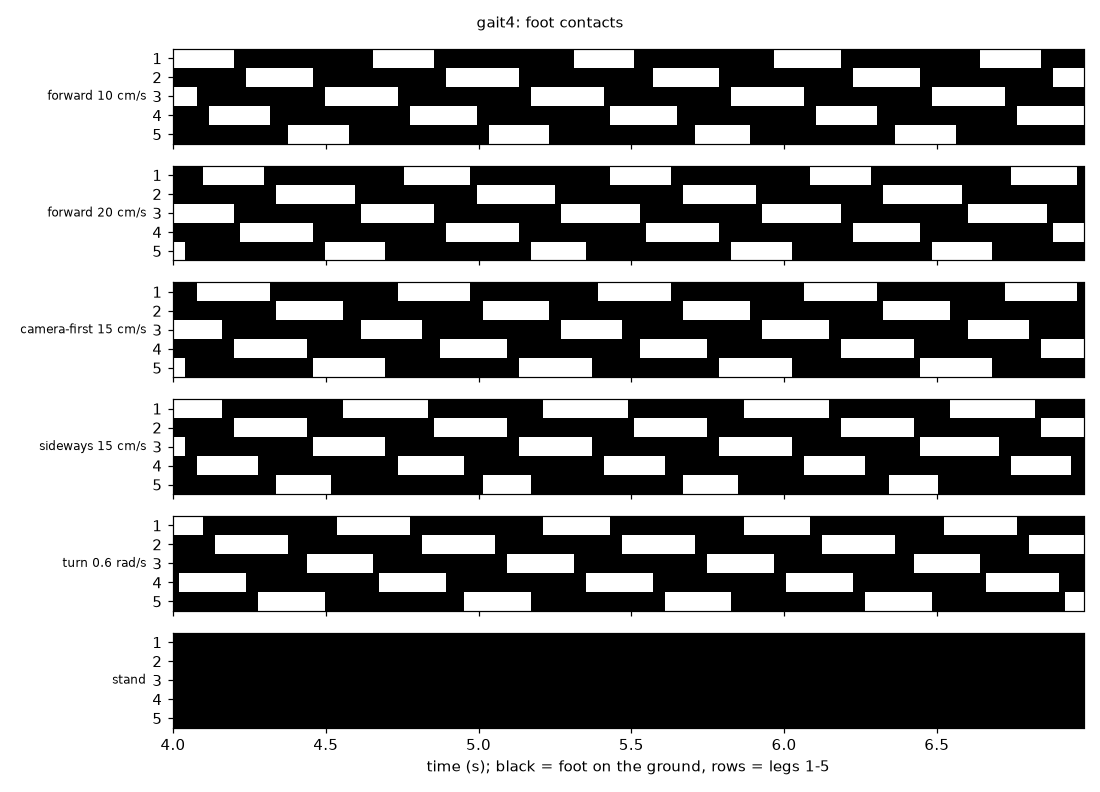
sim/rocky_mujoco/media/training/gait4_contacts.png
