PotatoPeaSea/Rocky/sim/rocky_mujoco/media/training/teacher2_stairs43_contacts.png

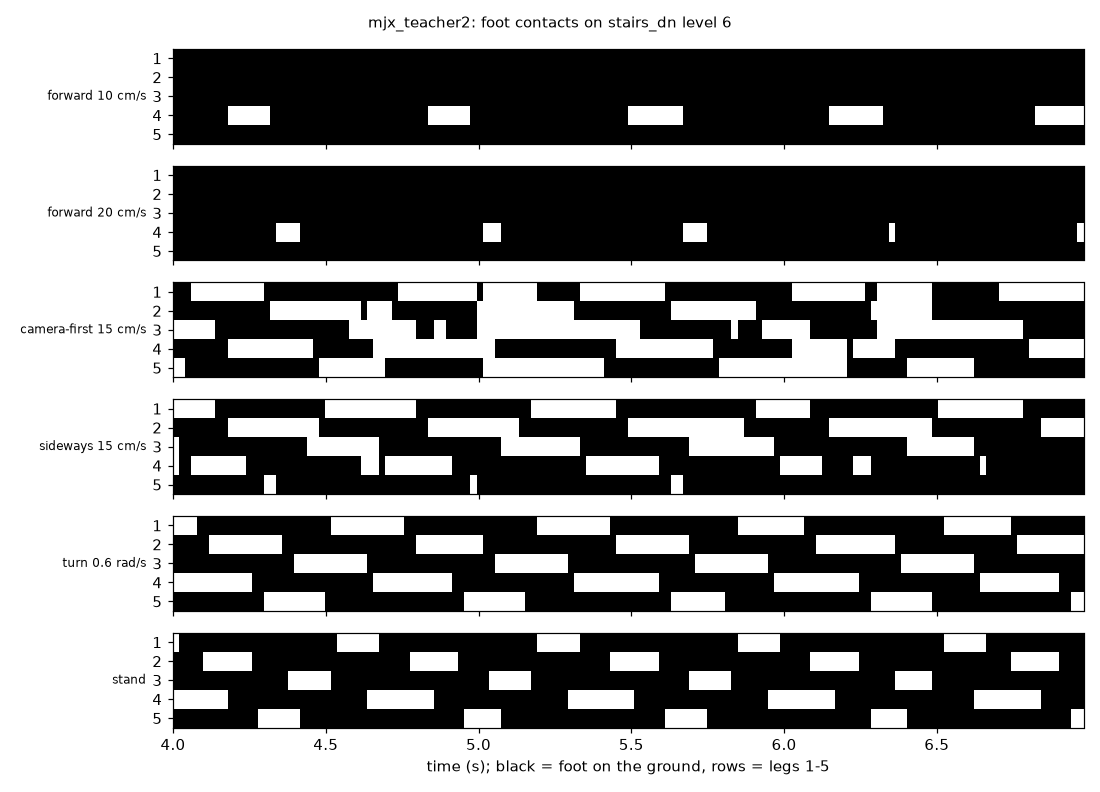
sim/rocky_mujoco/media/training/teacher2_stairs43_contacts.png
