PotatoPeaSea/Rocky/fusion/Pentapod_BOM_v5.xlsx

Sheet: BOM
Pentapod Walker - Bill of Materials (v5)
Blue = input you can edit (qty, price). Prices in USD; "est." prices are typical retail and should be checked. Printed parts: see the Printed Parts sheet.
# | Category | Item | Specification / part number | Qty | Unit | Unit price (USD) | Ext. price (USD) | Optional? | Price basis | Where to buy | CAD model in assembly | Notes / where used
 | Actuation
1 | Actuation | Serial bus servo | Hiwonder HX-30HM (30 kg.cm @ 11.1 V, 9-12.6 V, magnetic encoder, dual shaft) | 15 | pc | $19.99 | $299.85 | No | Listed price | hiwonder.com/products/hx-30hm | Your "Hiwonder HX-35HM v3.step", placed 15x | IDs 1-15. The 15 stock 20 cm cables cover everything: 10 daisy-chain hip->femur->knee (modelled 138 mm each) and 5 are cut for the hub branches (longest conductor 144 mm)
 | Controls & electronics
2 | Electronics | Microcontroller | Espressif ESP32-DevKitC-32E (38-pin) | 1 | pc | $11.00 | $11.00 | No | est. | DigiKey / Mouser | GrabCAD "ESP32-DevKitC V4" (Andrei Golyakov) | On female headers on the carrier perfboard, logic deck
3 | Electronics | Servo bus interface | Hiwonder BusLinker V3.0 (USB-C + TTL, 5-14 V) | 1 | pc | $9.69 | $9.69 | No | Listed price | openelab.com (Hiwonder) | Modelled from Hiwonder dimension drawing (no vendor CAD exists) | Replaces the 74HCT126/74LVC1G125 buffer. Hub SIG -> its 5264 port; powered from the hub through its terminal block
4 | Electronics | IMU | Adafruit BNO085 9-DOF fusion breakout, STEMMA QT (#4754) | 1 | pc | $29.50 | $29.50 | No | Listed price | adafruit.com/product/4754 | GrabCAD "Adafruit BNO085 9-DOF IMU STEMMA QT" | Logic deck; I2C to the ESP32; on-chip sensor fusion gives orientation directly
5 | Electronics | IMU cable | STEMMA QT / Qwiic JST-SH 4-pin to female sockets, 150 mm (Adafruit #4397) | 1 | pc | $0.95 | $0.95 | No | est. | adafruit.com | Modelled cable (45 mm route) | BNO085 -> ESP32 3V3/GND/SDA/SCL
6 | Electronics | Gamepad | Bluetooth gamepad supported by Bluepad32 (e.g. 8BitDo / Xbox / DualShock) | 1 | pc | $25.00 | $25.00 | No | est. | Any | - | Skip if you already own one
7 | Electronics | Buck converter (ESP32) | LM2596 3 A module (HW-411), set to 5.0 V | 1 | pc | $3.00 | $3.00 | No | est. | Amazon / AliExpress | GrabCAD "DC-DC LM2596 3A Step Down Converter Module" (Aleksey Zablotskiy) | Top plate; input tapped off the Pololu input pins, 5 V up to the ESP32
8 | Electronics | Bulk capacitor | 1000 uF 25 V low-ESR electrolytic, 10 x 20 mm | 1 | pc | $1.00 | $1.00 | No | est. | DigiKey / Mouser | GrabCAD "10 mm diameter Electrolytic capacitors radial" (D10 H20) | Centre of the WAGO holder, leads soldered to the V+ and GND bridge wires (the rails have no free port)
9 | Electronics | Battery-sense divider | 100 k + 22 k resistors | 2 | pc | $0.10 | $0.20 | No | est. | Any | - | On the ESP32 carrier, to GPIO34 (ADC1)
10 | Electronics | Perfboard | 3 x 7 cm double-sided FR-4 with M2 corner holes | 1 | pc | $1.00 | $1.00 | No | est. | Amazon / AliExpress | GrabCAD "Double Sided FR-4 Perfboards w M2 Corners" (pcb_3x7) | ESP32 carrier
11 | Electronics | Female headers | 1 x 19, 2.54 mm | 2 | pc | $0.50 | $1.00 | No | est. | Any | GrabCAD "Straight Round Female Pin Header 2.54 mm" (x38) | ESP32 socket on the carrier
12 | Electronics | Single-board computer | Raspberry Pi 5, 4 GB | 1 | pc | $85.00 | $85.00 | No | est. | Raspberry Pi approved resellers | Official Pi 5 STEP (simplified: parts < 3 mm removed, USB stacks as envelopes) | Logic deck centre; UART to the ESP32. Pi prices rose twice in 2026, check current price
13 | Electronics | Pi cooler | Raspberry Pi Active Cooler | 1 | pc | $5.00 | $5.00 | No | est. | Raspberry Pi resellers | GrabCAD "Raspberry Pi 5 + Stock Active cooler" (cooler extracted, matches the Pi 5 pin holes)
14 | Electronics | microSD card | 32 GB A2 class | 1 | pc | $10.00 | $10.00 | No | est. | Any | - | Raspberry Pi OS
15 | Electronics | Pi 5 V regulator | Pololu D36V50F5, 5 V 5.5 A step-down | 1 | pc | $39.95 | $39.95 | No | Listed price | pololu.com/product/4091 | Pololu official STEP (d36v50fx-step-down-voltage-regulator.step) | Logic deck, mounted caps-up; battery -> 5 V for the Pi only
16 | Electronics | USB-C power pigtail | Right-angle USB-C male to 4-pin bare wire | 1 | pc | $4.00 | $4.00 | No | est. | Amazon / AliExpress | GrabCAD "Right Angle USB C to 4 Pin Bare Wire" (plug end) | Pololu VOUT -> Pi USB-C; set usb_max_current_enable=1 in config.txt
17 | Electronics | Dupont jumpers | F-F 20 cm | 6 | pc | $0.10 | $0.60 | No | est. | Any | Modelled routes (65 mm Pi UART, 195 mm BusLinker TTL) | ESP32 <-> Pi GPIO14/15/GND and ESP32 UART2 <-> BusLinker TTL
 | Power
18 | Power | Battery | Gens Ace G-Tech 3S 2200 mAh 25C LiPo, XT60 | 1 | pc | $26.79 | $26.79 | No | Listed price | buddyrc.com | GrabCAD "3s Turnigy Li-Po battery" (Khalil Kosbi), same footprint | ~15-20 min walking; never use an HV pack (servos max 12.6 V)
19 | Power | Power hub | WAGO 221-415 lever connector, 5-way, 24-12 AWG | 6 | pc | $1.20 | $7.20 | No | est. | Amazon / DigiKey | GrabCAD "Wago 221-415" (x6) | 2 per rail (V+, GND, SIG) on opposite sides of the hub, joined by a bridge wire; star topology, 1 cut stock cable per leg
20 | Power | XT60 connector pairs | Amass XT60 male + female | 2 | pair | $1.50 | $3.00 | No | est. | Amazon / RC shops | GrabCAD "Amass XT-60H-M" + "XT60 Female connector" + "XT60 Male connector" (Baco) | Battery lead + loop key (socket in the bottom plate, shorting plug)
21 | Power | Fuse + holder | Inline mini-blade (ATM) holder, 12-14 AWG, + 20 A fuse | 1 | set | $3.00 | $3.00 | No | est. | Amazon / auto parts / McMaster 8110K6 | GrabCAD "Inline Fuse Holder w/ Indicator" | Between the plates, above the battery
22 | Power | Power wire | Silicone 14 AWG, red + black | 1 | m | $2.50 | $2.50 | No | est. | Amazon / RC shops | Modelled 14 AWG runs (~0.8 m incl. rail bridges) | XT60 -> fuse -> loop key -> hub, negative -> hub, V+ and GND bridges
23 | Power | Pi feed wire | Silicone 18 AWG, red + black | 1 | m | $1.50 | $1.50 | No | est. | Amazon / RC shops | Modelled 18 AWG pair (120-170 mm) | Hub -> Pololu regulator
24 | Power | Signal / 5 V wire | Silicone 22 AWG | 2 | m | $1.00 | $2.00 | No | est. | Amazon | - | LM2596 feed + 5 V, BusLinker power, SIG bridge, battery sense
25 | Power | Heat-shrink assortment | 2-6 mm | 1 | set | $4.00 | $4.00 | No | est. | Any | - | Cut stock-cable ends, cap leads, bridge splices
26 | Power | LiPo balance charger | 3S balance charger | 1 | pc | $35.00 | $35.00 | Yes | est. | RC shops | - | Skip if you already own one
27 | Power | LiPo-safe bag | Fire-resistant charging bag | 1 | pc | $8.00 | $8.00 | Yes | est. | RC shops | -
 | Fasteners & hardware
28 | Fasteners | Screw M2 x 6 | M2 socket/pan head, steel | 40 | pc | $0.05 | $2.00 | No | est. | McMaster / Amazon kit | - | Femur arms -> femur-servo horns (4 per horn)
29 | Fasteners | Screw M2 x 8 | M2 pan head | 30 | pc | $0.05 | $1.50 | No | est. | McMaster / Amazon kit | - | Chassis plates -> hip-servo case (6 per hip); check tapped-hole depth
30 | Fasteners | Screw M2 x 10 | M2 socket head | 40 | pc | $0.05 | $2.00 | No | est. | McMaster / Amazon kit | - | Tibia bosses -> knee-servo horns
31 | Fasteners | Screw M2 x 12 | M2 socket head | 40 | pc | $0.06 | $2.40 | No | est. | McMaster / Amazon kit | - | Coxa + top arm -> hip-servo horns
32 | Fasteners | Screw M2 x 8 (plastic) | Thread-forming for plastics | 7 | pc | $0.08 | $0.56 | No | est. | McMaster | - | ESP32 perfboard (4) + Pololu (3) -> deck bosses
33 | Fasteners | Screw M2.5 x 6 (plastic) | Thread-forming for plastics | 12 | pc | $0.08 | $0.96 | No | est. | McMaster | - | Pi 5, BusLinker, BNO085 -> deck bosses (4 each)
34 | Fasteners | Screw M3 x 12 (plastic) | Thread-forming for plastics (e.g. EJOT PT / Delta PT) | 25 | pc | $0.08 | $2.00 | No | est. | McMaster | - | Coxa top arm -> coxa (20), WAGO holder -> top plate (3), LM2596 -> top-plate bosses (2)
35 | Fasteners | Screw M3 x 10 (plastic) | Thread-forming for plastics | 20 | pc | $0.08 | $1.60 | No | est. | McMaster | - | Femur lid -> femur (4 per leg)
36 | Fasteners | Screw M3 x 60 | M3 socket head | 10 | pc | $0.15 | $1.50 | No | est. | McMaster / Amazon | - | Tibia halves (2 per leg)
37 | Fasteners | Nyloc nut M3 |  | 10 | pc | $0.03 | $0.30 | No | est. | Any | - | Tibia bolts
38 | Fasteners | Threaded rod M3 x 100 | Steel, cut from 1 m rod | 5 | pc | $0.40 | $2.00 | No | est. | Hardware store | Simple bodies (M3 tie rod 1-5) | Clamps bottom plate + standoff + top plate + lower post + logic deck + upper post
39 | Fasteners | Hex nut M3 |  | 10 | pc | $0.03 | $0.30 | No | est. | Any | - | Tie rods (underside + post nut trap)
40 | Fasteners | Washer M3 |  | 5 | pc | $0.02 | $0.10 | No | est. | Any | - | Tie rods, underside
41 | Fasteners | Screw M3 x 8 button head |  | 4 | pc | $0.08 | $0.32 | No | est. | Any | - | Battery tray -> bottom plate
42 | Fasteners | Heat-set insert M3 | M3 x 5.7, for 4.0 mm hole (e.g. Ruthex RX-M3x5.7) | 4 | pc | $0.15 | $0.60 | No | est. | Amazon / Ruthex | GrabCAD "M3 Heat Set Screw Inserts" (Alex Xela) | Battery-tray holes in the bottom plate
43 | Fasteners | Dowel pin 2 x 20 | Steel dowel (or M2 x 20 + nut) | 5 | pc | $0.10 | $0.50 | No | est. | McMaster / Amazon | - | Foot cross-pin
44 | Fasteners | Magnet 8 x 3 | N52 neodymium disc, 8 mm x 3 mm | 10 | pc | $0.20 | $2.00 | No | est. | Amazon / K&J Magnetics | Simple bodies (Magnet 8x3) | 5 in posts + 5 in dome; check polarity
45 | Fasteners | Battery strap | Hook-and-loop strap 20 x 200 mm | 1 | pc | $1.00 | $1.00 | No | est. | RC shops | - | Through the tray strap slots
46 | Fasteners | Zip ties | 2.5 mm, 100 mm | 40 | pc | $0.02 | $0.80 | No | est. | Any | - | Hub conductor ring + leg leads
47 | Fasteners | EVA foam pad | 2 mm, adhesive | 1 | sheet | $2.00 | $2.00 | Yes | est. | Craft store | - | Battery shim
 | Filament
48 | Filament | PETG | 1.75 mm PETG | 0.85 | kg | $20.00 | $17.00 | No | est. | Bambu / Polymaker / Sunlu | All printed parts except feet | Qty from the Printed Parts sheet; buy 1 spool
49 | Filament | TPU 95A | 1.75 mm TPU 95A | 0.017 | kg | $25.00 | $0.42 | No | est. | Bambu / Polymaker | Foot (TPU) | Qty from the Printed Parts sheet; small amount
 |  | Total - required |  |  |  |  | $616.60
 |  | Total - optional items |  |  |  |  | $45.00
 |  | Total - everything |  |  |  |  | $661.60
 |  | Servos as share of required |  |  |  |  | 48.6%
 |  | Prices exclude shipping and tax. Hiwonder offers free shipping over US$499.

Sheet: Printed Parts
Printed parts (from v5 body volumes)
Volumes are solid-body volumes measured from the v5 build geometry. Edit the blue assumptions in rows 4-7 to match your slicer.
PETG density (g/cm3) | 1.27 | Typical PETG datasheet value
TPU 95A density (g/cm3) | 1.21 | Typical TPU 95A datasheet value
Effective fill factor | 0.55 | Fraction of solid volume actually printed (walls + ~25% infill); thin parts print near-solid
Spool size (kg) | 1 | Standard 1 kg spool
Part | Group | Qty | Material | Volume each (cm3) | Total volume (cm3) | Est. mass (g) | Bounding box (mm) | Print orientation / notes
Coxa | Leg | 5 | PETG | 28.8 | 144.0 | 100.584 | 77 x 38 x 51 | Bottom arm on the bed; no supports
Coxa Top Arm | Leg | 5 | PETG | 11.5 | 57.5 | 40.16375 | 77 x 30 x 11 | Flat plate on the bed, horn boss up
Femur | Leg | 5 | PETG | 29.9 | 149.5 | 104.42575 | 113 x 43 x 30 | Upside down (cradle top on the bed); small support under the arm discs; 7 x 7 cable slot in the -y arm
Femur Lid | Leg | 5 | PETG | 7.6 | 38.0 | 26.543 | 61 x 30 x 4 | Flat
Tibia half A (+y) | Leg | 5 | PETG | 21.1 | 105.5 | 73.69175 | 36 x 27 x 138 | Lying on the y=0 cut face
Tibia half B (-y) | Leg | 5 | PETG | 21.1 | 105.5 | 73.69175 | 36 x 27 x 138 | Lying on the y=0 cut face
Foot | Leg | 5 | TPU | 5.0 | 25.0 | 16.6375 | 20 x 20 x 24 | Tip up; TPU 95A
Bottom Plate | Chassis | 1 | PETG | 116.6 | 116.6 | 81.4451 | 238 x 229 x 9 | Flat, pocket rings up; battery hatch + loop-key cutout + 4 insert holes
Top Plate | Chassis | 1 | PETG | 136.5 | 136.5 | 95.34525 | 238 x 229 x 12 | Flat, pocket rings up; branch slot over each hip connector, power slot, LM2596 bosses
Plate Standoff | Chassis | 5 | PETG | 1.8 | 9.0 | 6.2865 | 9 x 9 x 32 | Vertical
WAGO Hub Holder | Chassis | 1 | PETG | 28.0 | 28.0 | 19.558 | 94 x 94 x 8 | Flat; hexagonal stop holds 6 x 221-415, centre pocket for the 1000 uF can
Battery Tray | Chassis | 1 | PETG | 32.1 | 32.1 | 22.42185 | 128 x 60 x 15 | Open side up; strap slots print as bridges
Dome Post lower | Chassis | 5 | PETG | 3.4 | 17.0 | 11.8745 | 12 x 12 x 32 | Vertical
Dome Post upper | Chassis | 5 | PETG | 2.1 | 10.5 | 7.33425 | 12 x 12 x 23 | Vertical; drop M3 nut into trap at pause, magnet pocket up
Logic Deck | Chassis | 1 | PETG | 80.3 | 80.3 | 56.08955 | 189 x 181 x 8.5 | Flat, bosses up; fits 256 bed. Pi 5, ESP32 carrier, BusLinker, Pololu, BNO085
Dome Apex Cap | Dome | 1 | PETG | 12.3 | 12.3 | 8.59155 | 80 x 80 x 8 | Rim down
Dome Sector | Dome | 5 | PETG | 32.3 | 161.5 | 112.80775 | 155 x 100 x 65 (max) | Lying on a radial cut face, brim
PETG total |  |  |  |  | 1203.8 | 840.8543
TPU total |  |  |  |  | 25.0 | 16.6375
Part count |  | 61

Sheet: Notes
Pentapod Walker (Rocky) - BOM notes, v5
Sources
HX-30HM price and specs: Hiwonder product page, https://www.hiwonder.com/products/hx-30hm (accessed Oct 2026).
BusLinker V3.0: price https://openelab.com/products/buslinker-v3-servo-board; dimensions and connector layout from Hiwonder's manual, https://docs.hiwonder.com/projects/BusLinker/en/latest/ (42 x 33 x 15 mm, holes 36 x 28 mm).
Adafruit BNO085: https://www.adafruit.com/product/4754. Pololu D36V50F5: https://www.pololu.com/product/4091 (STEP from the Resources tab).
Battery price and size (107 x 33.5 x 22 mm, 173.5 g): BuddyRC Gens Ace 2200 3S 25C listing.
Raspberry Pi 5: official STEP (pip-assets.raspberrypi.com), simplified for import speed. Pi price: TechSpot, Feb 2026; a further increase was reported in April 2026, so check.
GrabCAD Community models (downloaded Oct 2026): ESP32-DevKitC V4; 3s Turnigy Li-Po battery; DC-DC LM2596 module; Amass XT-60H-M; XT60 Female / Male connector (Baco); M3 Heat Set Screw Inserts; Wago 221-415; Adafruit BNO085 9-DOF IMU STEMMA QT; Inline Fuse Holder w/ Indicator; Right Angle USB C to 4 Pin Bare Wire; Raspberry Pi 5 + Stock Active cooler; Double Sided FR-4 Perfboards w M2 Corners; 10 mm diameter Electrolytic capacitors radial; Straight Round Female Pin Header 2.54 mm.
Cable lengths: measured along the modelled v5 harness centre-lines. Every leg conductor fits a cut 20 cm stock cable (longest 144 mm incl. the 35 mm cable run into the chassis).
Assumptions
Prices marked "est." are typical single-unit retail; fasteners are usually cheaper in assortment kits.
The HX-35HM model is used as the HX-30HM reference: both are listed by Hiwonder at 45.2 x 24.7 x 35 mm.
Filament mass = solid volume x density x effective fill factor (Printed Parts sheet, editable).
WAGO port budget: V+ and GND use all 10 ports each (battery, 5 legs, BusLinker, Pololu feed, bridge x2); the BusLinker servo-cable GND is left off because its terminal-block GND is the same net.
Verify before buying / printing
Horn screw thread (model holes are 1.5 mm, consistent with tapped M2) and depth of the M2 holes in the case.
Which servo face carries the 5264 connectors; the branch slots assume the far end of the hip-servo case.
BusLinker TTL logic level (add a pre-built level shifter if it is 5 V) and HX-30HM bus voltage / baud.
Pololu D36V50F5 pin order (VIN/GND/VOUT columns) before soldering; the model labels are assumptions.
