PotatoPeaSea/Rocky/pcb/rocky_ctrl/fab/rocky_ctrl_bom_full.csv

Reference | Value | Footprint | LCSC | MPN | QUANTITY
C1 | 220u 35V | Capacitor_THT:CP_Radial_D8.0mm_P3.50mm |  | Panasonic EEU-FR1V221 (220 uF 35 V, 8x11.5) | 1
C2,C8,C11,C12,C23 | 10u 50V | Capacitor_SMD:C_1206_3216Metric |  | GRM31CR61H106KA12 (10 uF 50 V X5R 1206) | 5
C3 | 220n 50V | Capacitor_SMD:C_0805_2012Metric |  | 220 nF 50 V X7R 0805 (Miller soft-start) | 1
C4 | 10n | Capacitor_SMD:C_0603_1608Metric | C57112 | 10n | 1
C5,C9,C10,C13,C14,C22,C24,C25,C28,C29,C32,C34,C35,C36,C37 | 100n | Capacitor_SMD:C_0603_1608Metric | C14663 | 100n | 15
C6,C7 | 1000u 35V | Capacitor_THT:CP_Radial_D12.5mm_P5.00mm |  | Panasonic EEU-FR1V102 (1000 uF 35 V, 12.5x20, 2.2 A ripple) | 2
C15 | 3.9n | Capacitor_SMD:C_0603_1608Metric |  | 3.9n | 1
C16 | 39p | Capacitor_SMD:C_0603_1608Metric |  | 39p | 1
C17,C18,C19,C20,C26,C27,C31 | 22u | Capacitor_SMD:C_0805_2012Metric | C45783 | 22 uF 25 V X5R 0805 | 7
C30,C38 | 1u | Capacitor_SMD:C_0603_1608Metric | C15849 | 1u | 2
C39,C40,C41,C42,C43 | 22u | Capacitor_SMD:C_1206_3216Metric |  | 22 uF 25 V X5R 1206 | 5
D1 | SMBJ15A | Diode_SMD:D_SMB |  | SMBJ15A (15 V stand-off unidirectional TVS) | 1
D2 | B540C | Diode_SMD:D_SMC |  | B540C-13-F (40 V 5 A Schottky, SMC) | 1
D3,D4 | SS34 | Diode_SMD:D_SMA | C8678 | SS34 | 2
D5,D6,D7,D8,D9 | PESD5V0S1BB | Diode_SMD:D_SOD-323 |  | PESD5V0S1BB (bidirectional ESD, SOD-323) | 5
DZ1,DZ2 | BZT52C10 | Diode_SMD:D_SOD-123 |  | BZT52C10 (10 V Vgs clamp) | 2
F1 | 20A ATM | Fuse:Fuseholder_Blade_Mini_Keystone_3568 |  | Keystone 3568 + 20 A mini blade fuse | 1
J1 | XT60PW-M | Connector_AMASS:AMASS_XT60PW-M_1x02_P7.20mm_Horizontal |  | AMASS XT60PW-M | 1
J2 | Pi 5V | Connector_JST:JST_VH_B3P-VH-B_1x03_P3.96mm_Vertical |  | JST B3P-VH-B (to USB-C pigtail into the Pi 5) | 1
J3 | USB-C | Connector_USB:USB_C_Receptacle_HRO_TYPE-C-31-M-12 | C165948 | HRO TYPE-C-31-M-12 | 1
J4 | Pi GPIO 5-14 | Connector_IDC:IDC-Header_2x05_P2.54mm_Vertical |  | 2x5 2.54 mm box header (ribbon to Pi pins 5-14) | 1
J5 | LEG1 | Connector_Molex:Molex_SPOX_5267-03A_1x03_P2.50mm_Vertical |  | Molex 5267-03A (or 2.50 mm "5264" 3P vertical header) | 1
J6 | LEG2 | Connector_Molex:Molex_SPOX_5267-03A_1x03_P2.50mm_Vertical |  | Molex 5267-03A (or 2.50 mm "5264" 3P vertical header) | 1
J7 | LEG3 | Connector_Molex:Molex_SPOX_5267-03A_1x03_P2.50mm_Vertical |  | Molex 5267-03A (or 2.50 mm "5264" 3P vertical header) | 1
J8 | LEG4 | Connector_Molex:Molex_SPOX_5267-03A_1x03_P2.50mm_Vertical |  | Molex 5267-03A (or 2.50 mm "5264" 3P vertical header) | 1
J9 | LEG5 | Connector_Molex:Molex_SPOX_5267-03A_1x03_P2.50mm_Vertical |  | Molex 5267-03A (or 2.50 mm "5264" 3P vertical header) | 1
J10 | STEMMA QT | Connector_JST:JST_SH_SM04B-SRSS-TB_1x04-1MP_P1.00mm_Horizontal | C160390 | JST SM04B-SRSS-TB (STEMMA QT to Adafruit BNO085) | 1
J11 | IMU INT/RST | Connector_PinHeader_2.54mm:PinHeader_1x02_P2.54mm_Vertical |  | 1x2 2.54 mm header | 1
J12 | SPARE | Connector_PinHeader_2.54mm:PinHeader_1x08_P2.54mm_Vertical |  | 1x8 2.54 mm header | 1
L1 | 4.7u | Inductor_SMD:L_Bourns_SRP1245A |  | Bourns SRP1245A-4R7M (4.7 uH, Isat 21 A) | 1
L2 | 4.7u | Inductor_SMD:L_Bourns_SRN6045TA |  | Bourns SRN6045TA-4R7M (4.7 uH 3.4 A) | 1
LED1 | GREEN 3V3 | LED_SMD:LED_0603_1608Metric | C72043 | GREEN 3V3 | 1
LED2 | GREEN 5V | LED_SMD:LED_0603_1608Metric | C72043 | GREEN 5V | 1
LED3 | RED SERVO | LED_SMD:LED_0603_1608Metric | C2286 | RED SERVO | 1
LED4 | BLUE | LED_SMD:LED_0603_1608Metric | C72041 | BLUE | 1
LED5 | YELLOW | LED_SMD:LED_0603_1608Metric | C72038 | YELLOW | 1
Q1,Q2 | BSC030P03NS3 | Package_TO_SOT_SMD:TDSON-8-1 |  | Infineon BSC030P03NS3G (-30 V, 3.0 mOhm) | 2
Q3,Q5,Q6 | MMBT3904 | Package_TO_SOT_SMD:SOT-23 | C20526 | MMBT3904 | 3
Q4,Q7,Q8 | 2N7002 | Package_TO_SOT_SMD:SOT-23 | C8545 | 2N7002 | 3
R1,R4,R18,R20,R22,R25,R26,R27,R32,R33,R40,R41,R42,R44,R45,R46,R54 | 10k | Resistor_SMD:R_0603_1608Metric | C25804 | 10k 1% 0603 | 17
R2,R5,R9,R11,R13,R15,R31,R36,R37 | 100k | Resistor_SMD:R_0603_1608Metric | C25803 | 100k 1% 0603 | 9
R3 | 33k | Resistor_SMD:R_0603_1608Metric | C4216 | 33k 1% 0603 | 1
R6 | 1m | Resistor_SMD:R_Shunt_Vishay_WSK2512_6332Metric_T1.19mm |  | Vishay WSK25121L000FEA (1 mOhm 1 % 2512 4-terminal) | 1
R7,R29,R30,R34,R35,R38,R55 | 1k | Resistor_SMD:R_0603_1608Metric | C21190 | 1k 1% 0603 | 7
R8,R52,R53 | 4.7k | Resistor_SMD:R_0603_1608Metric | C23162 | 4.7k 1% 0603 | 3
R10,R12,R21,R28 | 22k | Resistor_SMD:R_0603_1608Metric | C31850 | 22k 1% 0603 | 4
R14 | 18k | Resistor_SMD:R_0603_1608Metric |  | 18k 1% 0603 | 1
R16 | 191k | Resistor_SMD:R_0603_1608Metric |  | 191k 1% 0603 | 1
R17 | 53.6k | Resistor_SMD:R_0603_1608Metric |  | 53.6k 1% 0603 | 1
R19 | 16k | Resistor_SMD:R_0603_1608Metric |  | 16k 1% 0603 | 1
R23,R24 | 5.1k | Resistor_SMD:R_0603_1608Metric | C23186 | 5.1k 1% 0603 | 2
R39,R43 | 22 | Resistor_SMD:R_0603_1608Metric | C23345 | 22 1% 0603 | 2
R47,R48,R49,R50,R51 | 33 | Resistor_SMD:R_0603_1608Metric | C23140 | 33 1% 0603 | 5
R56 | 2.2k | Resistor_SMD:R_0603_1608Metric | C4190 | 2.2k 1% 0603 | 1
SW1 | EN | Button_Switch_SMD:SW_Push_1P1T_XKB_TS-1187A | C318884 | XKB TS-1187A-B-A-B | 1
SW2 | BOOT | Button_Switch_SMD:SW_Push_1P1T_XKB_TS-1187A | C318884 | XKB TS-1187A-B-A-B | 1
U1 | INA180A3 | Package_TO_SOT_SMD:SOT-23-5 |  | INA180A3IDBVR (100 V/V) | 1
U2 | TPS54560B | Package_SO:Texas_R-PDSO-G8_EP2.95x4.9mm_Mask2.4x3.1mm_ThermalVias |  | TPS54560BDDAR | 1
U3 | AP63203WU | Package_TO_SOT_SMD:TSOT-23-6 |  | AP63203WU-7 | 1
U4 | USBLC6-2SC6 | Package_TO_SOT_SMD:SOT-23-6 | C7519 | USBLC6-2SC6 | 1
U5 | CH340C | Package_SO:SOIC-16_3.9x9.9mm_P1.27mm | C84681 | CH340C | 1
U6 | 74LVC1G3157 | Package_TO_SOT_SMD:SOT-363_SC-70-6 |  | SN74LVC1G3157DCKR (S=L: B1=Pi, S=H: B2=USB) | 1
U7 | ESP32-WROOM-32E-N8 | RF_Module:ESP32-WROOM-32E | C701342 | ESP32-WROOM-32E-N8 (8 MB) | 1
U8,U10 | SN74LV1T126 | Package_TO_SOT_SMD:SOT-23-5 |  | SN74LV1T126DBVR (TX driver, OE high) | 2
U9,U11 | SN74LV1T125 | Package_TO_SOT_SMD:SOT-23-5 |  | SN74LV1T125DBVR (RX buffer, OE low) | 2
