PotatoPeaSea/Rocky/pcb/rocky_ctrl/3d/L_Bourns_SRP1245A.step

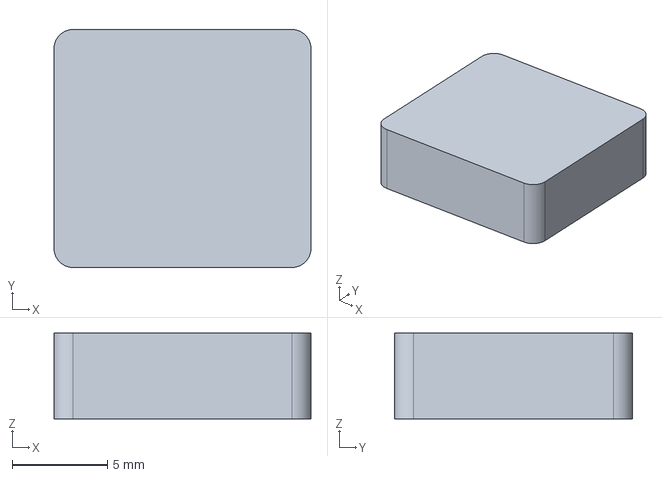
[picture p20: CAD file, 2026-10-19]
pcb/rocky_ctrl/3d/L_Bourns_SRP1245A.step
13.5 x 12.5 x 4.50 mm
