PotatoPeaSea/Rocky/pcb/rocky_ctrl/rocky_ctrl.step

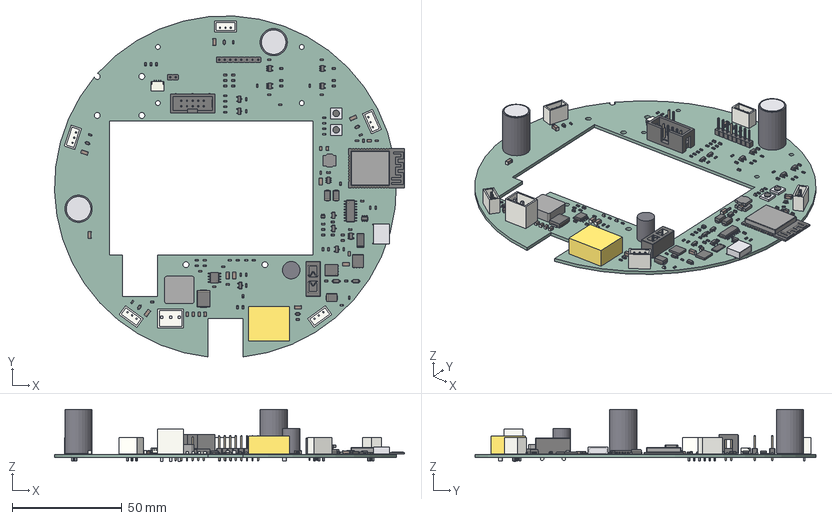
[picture p21: CAD file, 2026-10-20]
pcb/rocky_ctrl/rocky_ctrl.step
159.6 x 155.5 x 23.9 mm
C_0603_1608Metric x 20
C_1206_3216Metric x 10
R_0603_1608Metric x 55
C_0805_2012Metric x 8
CP_Radial_D12.5mm_H20_0 x 2
CP_Radial_D12.5mm_H20_1 x 2
LED_0603_1608Metric x 5
Molex_SPOX_5267-03A_0 x 5
Molex_SPOX_5267-03A_1 x 5
Molex_SPOX_5267-03A_2 x 5
Molex_SPOX_5267-03A_3 x 5
D_SMA x 2
IDC-Header_2x05_P2.54mm_Vertical
SOIC-8-1EP_3.9x4.9mm_P1.27mm_EP2.41x3.81mm
SW_XKB_TS-1187A_0 x 2
SW_XKB_TS-1187A_1 x 2
D_SOD-123 x 2
SOT-23 x 6
L_Bourns_SRN6045TA
USB_C_HRO_TYPE-C-31-M-12_0
TSOT-23-6
D_SOD-323 x 5
SOT-23-5 x 5
TDSON-8-1 x 2
PinHeader_1x08_P2.54mm_Vertical
AMASS_XT60PW-M_0
AMASS_XT60PW-M_1
AMASS_XT60PW-M_2
SOT-23-6
SOT-363_SC-70-6
JST_SH_SM04B-SRSS-TB_1x04-1MP_P1.00mm_Horizontal
Fuseholder_Blade_Mini_Keystone_3568
D_SMB
SOIC-16_3.9x9.9mm_P1.27mm
PinHeader_1x02_P2.54mm_Vertical
D_SMC
ESP32-WROOM-32E
R_2512_6332Metric
CP_Radial_D8.0mm_H11.5_0
JST_VH_B3P-VH-B_0
JST_VH_B3P-VH-B_1
JST_VH_B3P-VH-B_2
JST_VH_B3P-VH-B_3
L_Bourns_SRP1245A_0
rocky_ctrl_PCB
