PotatoPeaSea/Rocky/sim/rocky_mujoco/meshes/camera_mount_cap.stl

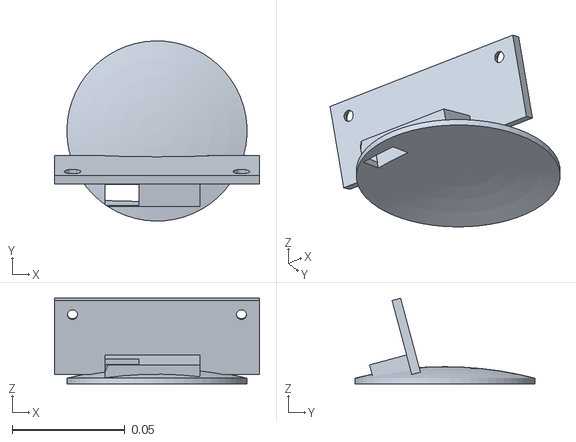
[picture p22: CAD file, 2026-10-20]
sim/rocky_mujoco/meshes/camera_mount_cap.stl
0.091 x 0.08 x 0.038
