PotatoPeaSea/Rocky/pcb/rocky_ctrl/3d/AMASS_XT60PW-M.step

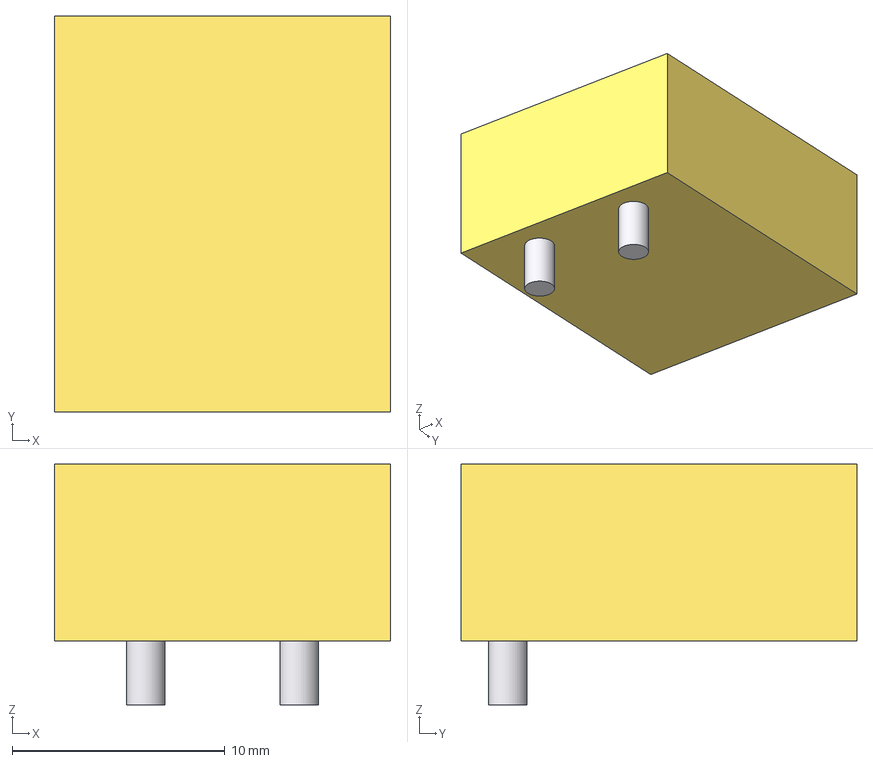
[picture p23: CAD file, 2026-10-19]
pcb/rocky_ctrl/3d/AMASS_XT60PW-M.step
15.8 x 18.6 x 11.3 mm
AMASS_XT60PW-M_0
AMASS_XT60PW-M_1
AMASS_XT60PW-M_2
