PotatoPeaSea/Rocky/sim/rocky_mujoco/meshes/camera_oakd_lite.stl

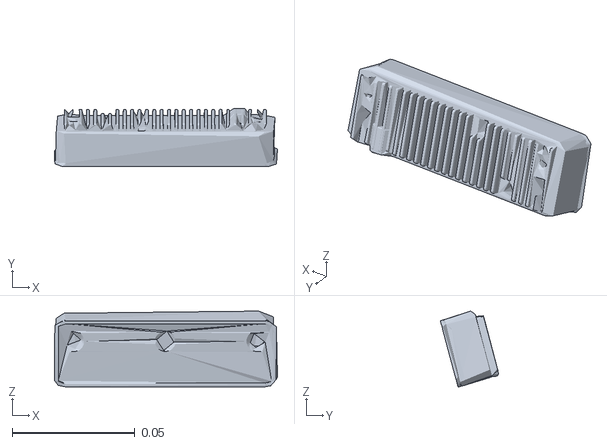
[picture p24: CAD file, 2026-10-20]
sim/rocky_mujoco/meshes/camera_oakd_lite.stl
0.0907 x 0.0237 x 0.0308
