PotatoPeaSea/Rocky/pcb/rocky_ctrl/3d/JST_VH_B3P-VH-B.step

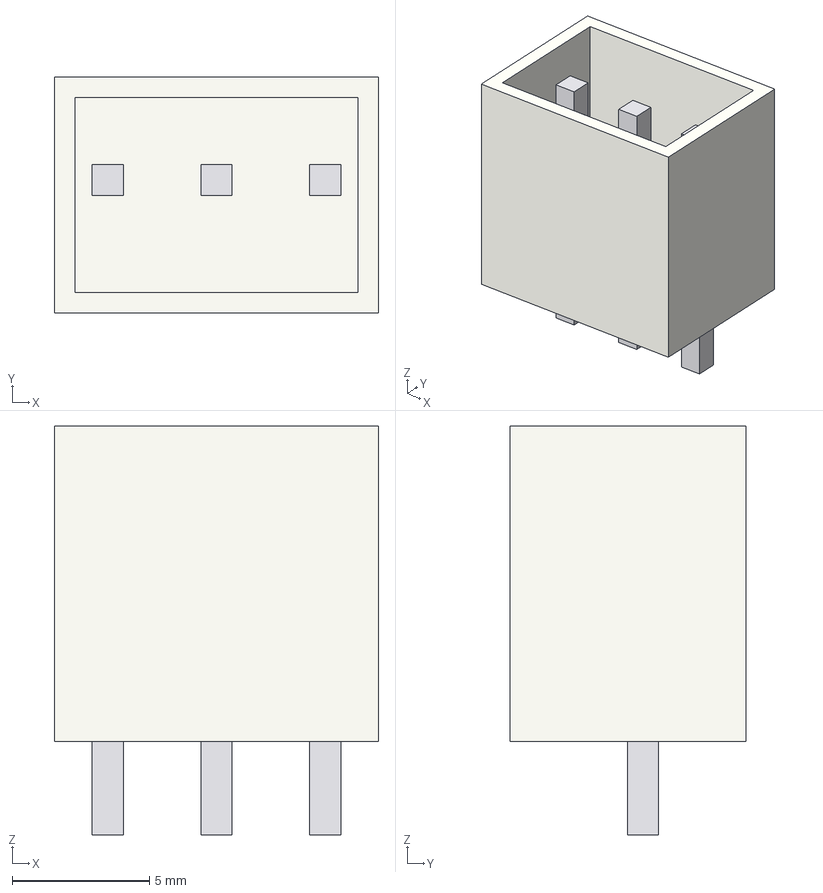
[picture p25: CAD file, 2026-10-19]
pcb/rocky_ctrl/3d/JST_VH_B3P-VH-B.step
11.8 x 8.60 x 14.9 mm
JST_VH_B3P-VH-B_0
JST_VH_B3P-VH-B_1
JST_VH_B3P-VH-B_2
JST_VH_B3P-VH-B_3
