PotatoPeaSea/Rocky/sim/rocky_mujoco/meshes/leg_coxa.stl

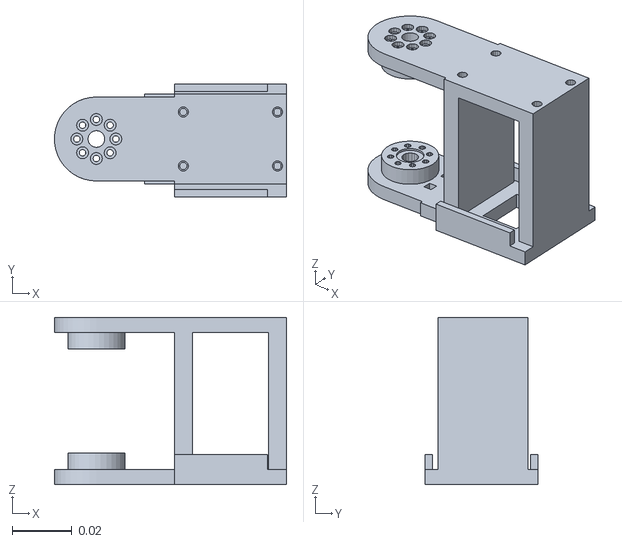
[picture p26: CAD file, 2026-10-19]
sim/rocky_mujoco/meshes/leg_coxa.stl
0.0774 x 0.0377 x 0.0558
