PotatoPeaSea/Rocky/pcb/rocky_ctrl/3d/CP_Radial_D12.5mm_H20.step

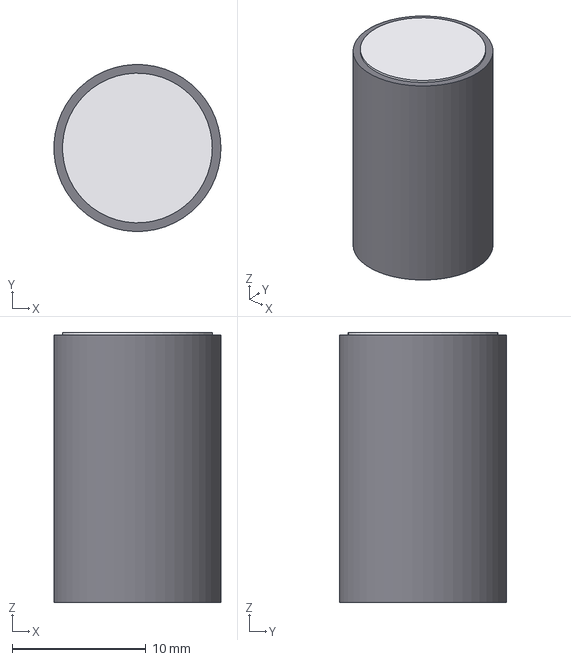
[picture p27: CAD file, 2026-10-19]
pcb/rocky_ctrl/3d/CP_Radial_D12.5mm_H20.step
12.5 x 12.5 x 20.2 mm
CP_Radial_D12.5mm_H20_0
CP_Radial_D12.5mm_H20_1
