PotatoPeaSea/Rocky/sim/rocky_mujoco/meshes/battery.stl

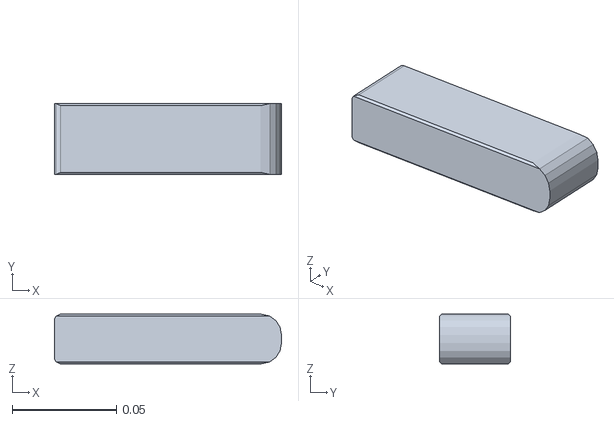
[picture p28: CAD file, 2026-10-19]
sim/rocky_mujoco/meshes/battery.stl
0.109 x 0.034 x 0.024
