PotatoPeaSea/Rocky/pcb/rocky_ctrl/3d/CP_Radial_D8.0mm_H11.5.step

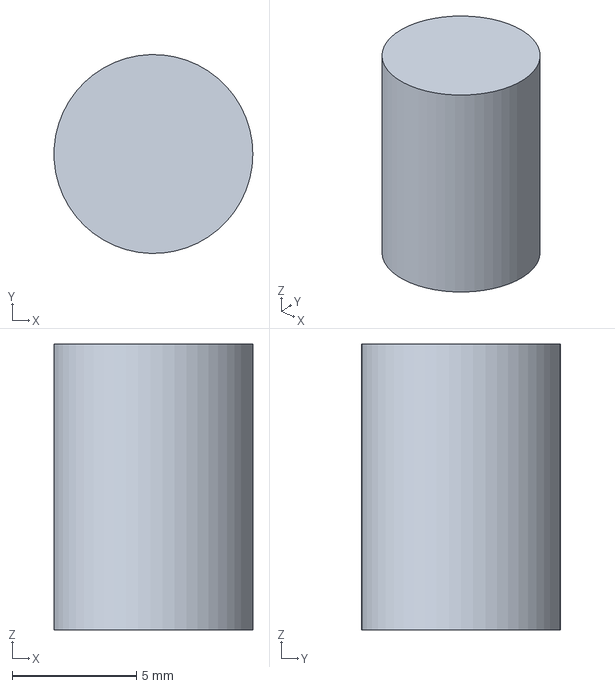
[picture p29: CAD file, 2026-10-19]
pcb/rocky_ctrl/3d/CP_Radial_D8.0mm_H11.5.step
7.99 x 8.00 x 11.5 mm
