PotatoPeaSea/Rocky/sim/rocky_mujoco/meshes/pi5.stl

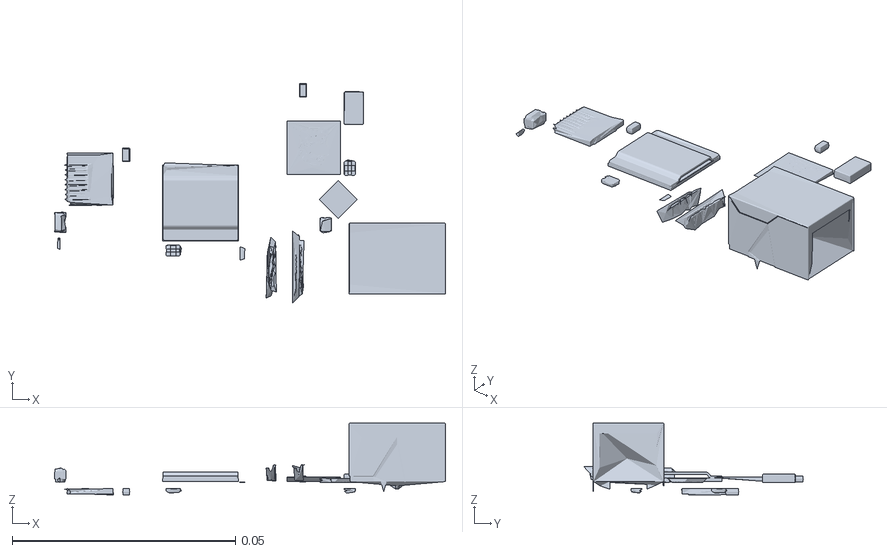
[picture p30: CAD file, 2026-10-19]
sim/rocky_mujoco/meshes/pi5.stl
0.0876 x 0.0492 x 0.0161
