PotatoPeaSea/Rocky/pcb/rocky_ctrl/3d/Molex_SPOX_5267-03A.step

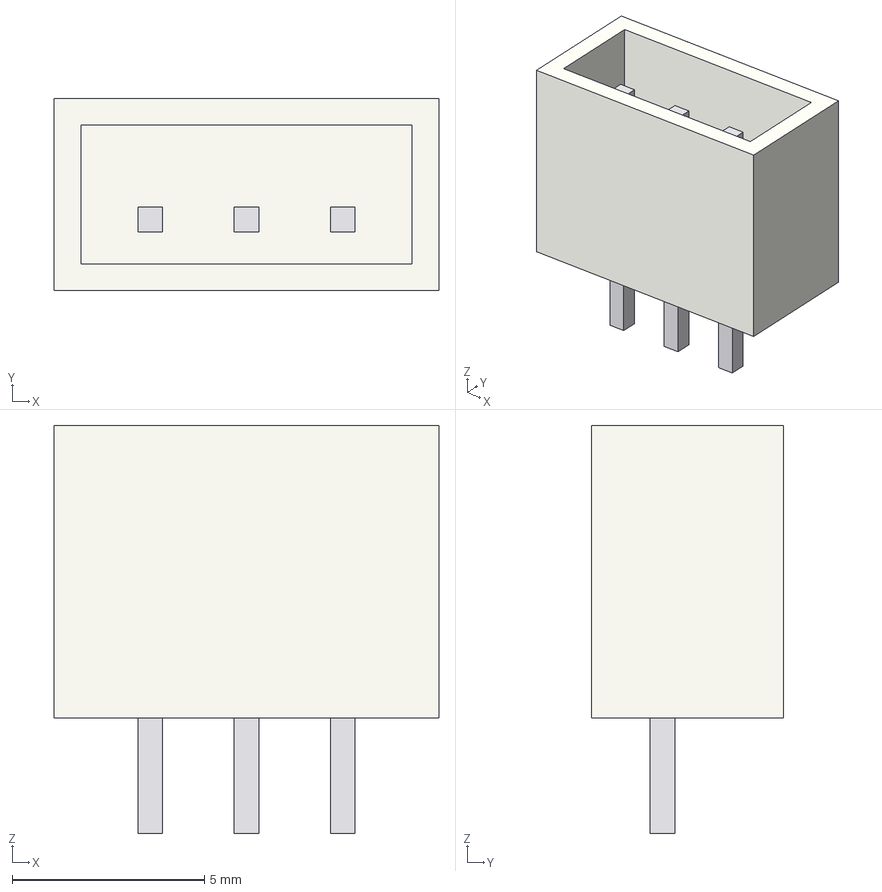
[picture p31: CAD file, 2026-10-19]
pcb/rocky_ctrl/3d/Molex_SPOX_5267-03A.step
10.0 x 5.00 x 10.6 mm
Molex_SPOX_5267-03A_0
Molex_SPOX_5267-03A_1
Molex_SPOX_5267-03A_2
Molex_SPOX_5267-03A_3
