PotatoPeaSea/Rocky/sim/rocky_mujoco/meshes/leg_tibia.stl

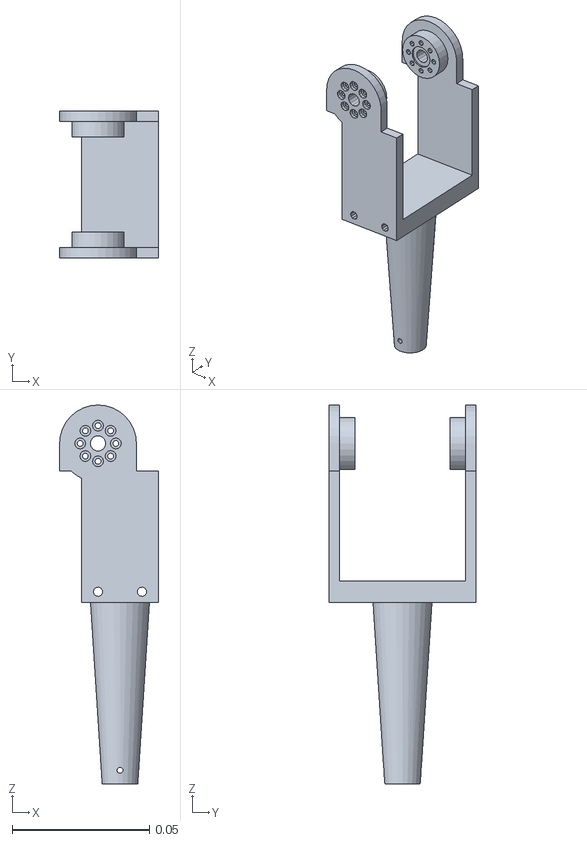
[picture p32: CAD file, 2026-10-19]
sim/rocky_mujoco/meshes/leg_tibia.stl
0.036 x 0.0537 x 0.138
