PotatoPeaSea/Rocky/pcb/rocky_ctrl/3d/USB_C_HRO_TYPE-C-31-M-12.step

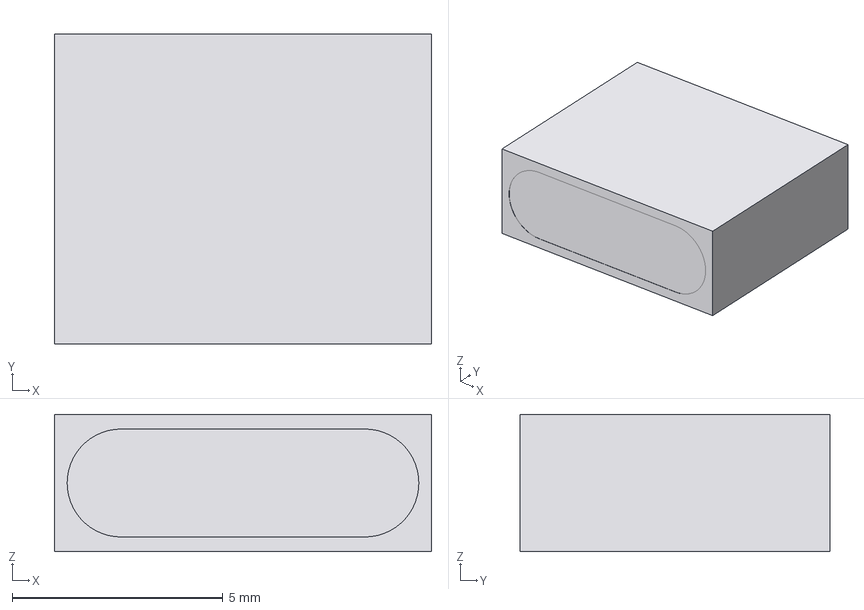
[picture p33: CAD file, 2026-10-19]
pcb/rocky_ctrl/3d/USB_C_HRO_TYPE-C-31-M-12.step
8.94 x 7.35 x 3.26 mm
