PotatoPeaSea/Rocky/sim/rocky_mujoco/meshes/servo_knee.stl

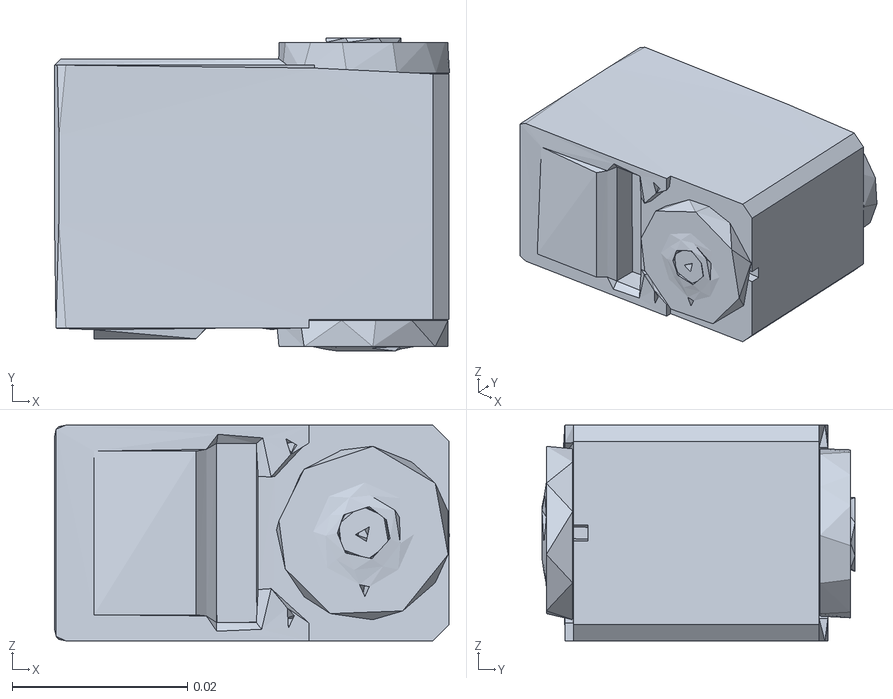
[picture p34: CAD file, 2026-10-19]
sim/rocky_mujoco/meshes/servo_knee.stl
0.045 x 0.0357 x 0.0246
