PotatoPeaSea/Rocky/pcb/rocky_ctrl/3d/SW_XKB_TS-1187A.step

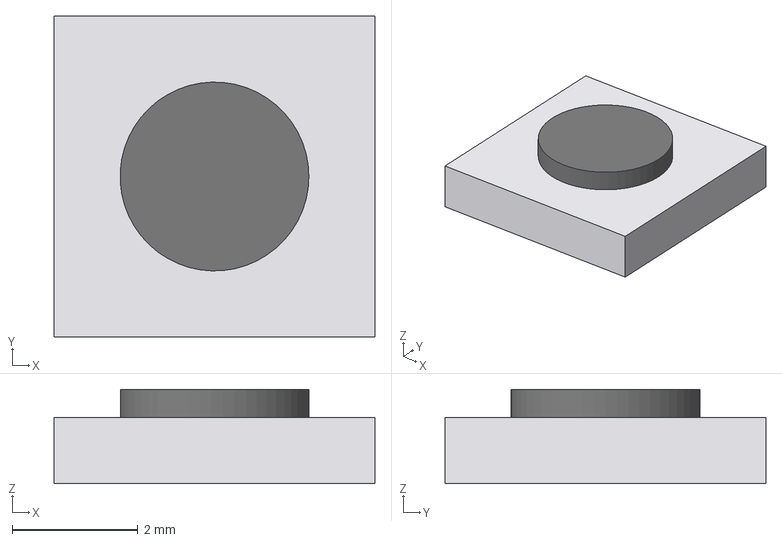
[picture p35: CAD file, 2026-10-19]
pcb/rocky_ctrl/3d/SW_XKB_TS-1187A.step
5.10 x 5.10 x 1.50 mm
SW_XKB_TS-1187A_0
SW_XKB_TS-1187A_1
