PotatoPeaSea/Rocky/sim/rocky_mujoco/meshes/pi5_cooler.stl

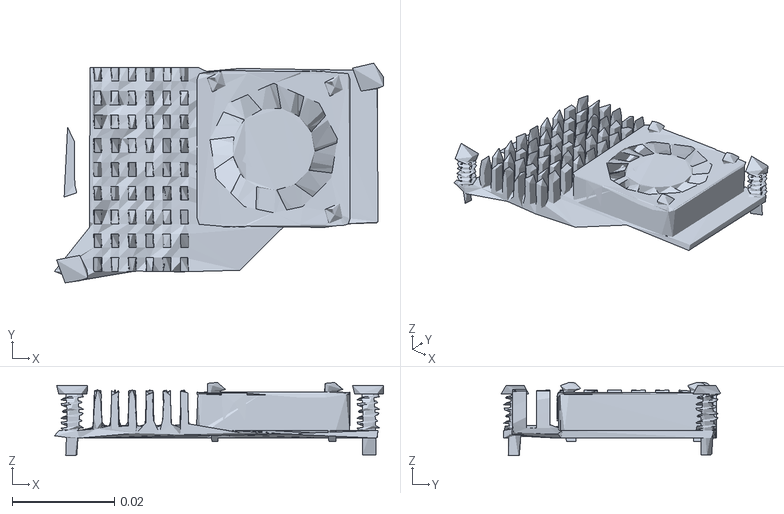
[picture p36: CAD file, 2026-10-19]
sim/rocky_mujoco/meshes/pi5_cooler.stl
0.0645 x 0.0431 x 0.0143
