PotatoPeaSea/Rocky/sim/rocky_mujoco/meshes/base_chassis.stl

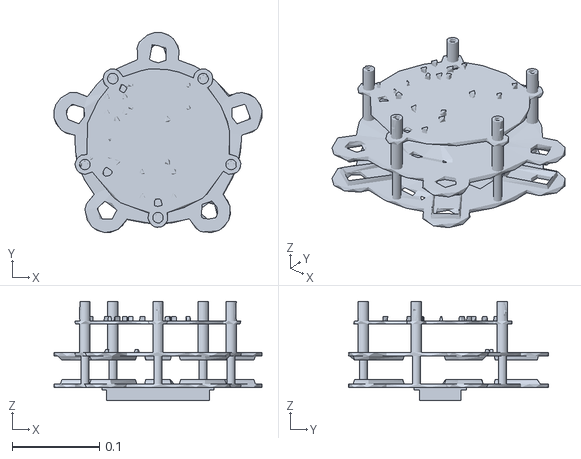
[picture p37: CAD file, 2026-10-19]
sim/rocky_mujoco/meshes/base_chassis.stl
0.238 x 0.229 x 0.114
