PotatoPeaSea/Rocky/sim/rocky_mujoco/meshes/base_dome.stl

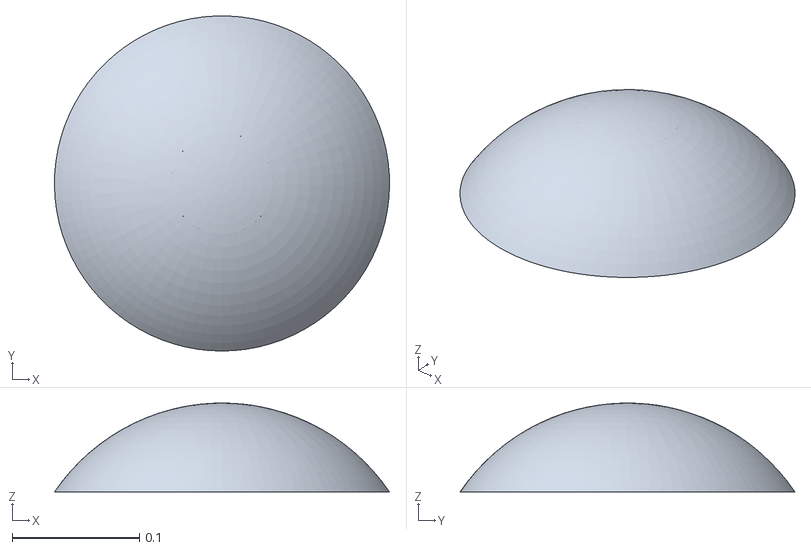
[picture p38: CAD file, 2026-10-19]
sim/rocky_mujoco/meshes/base_dome.stl
0.264 x 0.264 x 0.07
