PotatoPeaSea/Rocky/sim/rocky_mujoco/meshes/base_hip_servos.stl

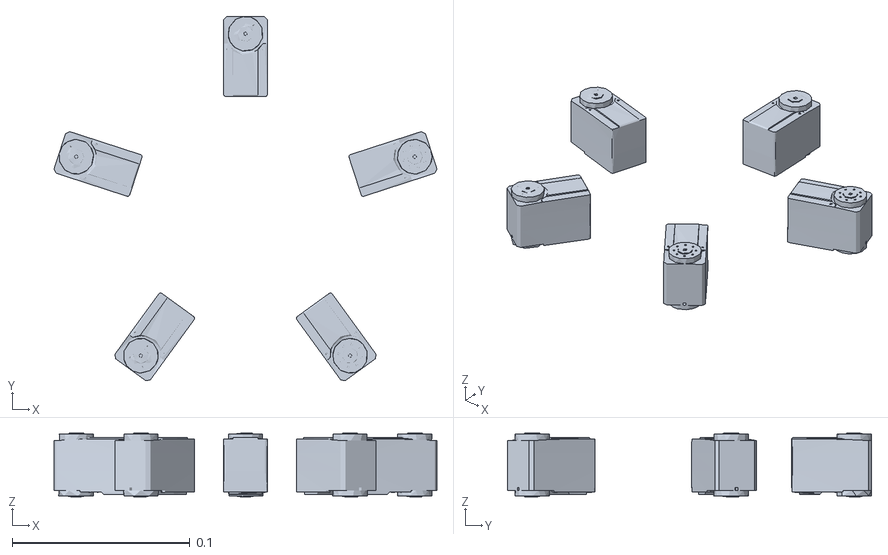
[picture p39: CAD file, 2026-10-19]
sim/rocky_mujoco/meshes/base_hip_servos.stl
0.215 x 0.205 x 0.0357
