PotatoPeaSea/Rocky/sim/rocky_mujoco/meshes/leg_foot.stl

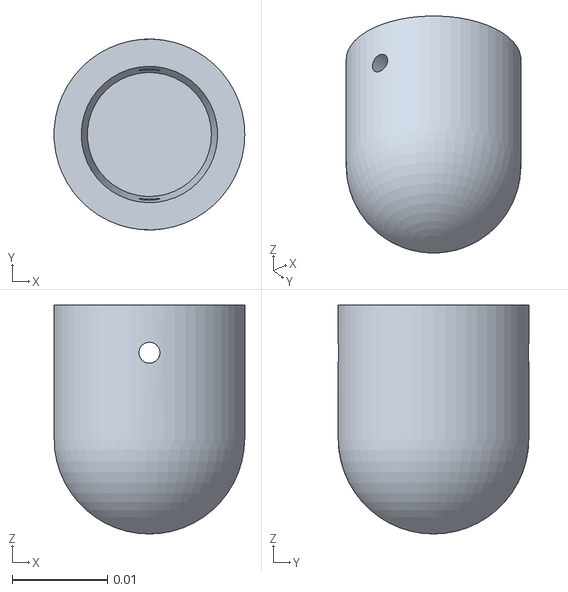
[picture p40: CAD file, 2026-10-19]
sim/rocky_mujoco/meshes/leg_foot.stl
0.02 x 0.02 x 0.024
