PotatoPeaSea/Rocky/sim/rocky_mujoco/meshes/leg_femur.stl

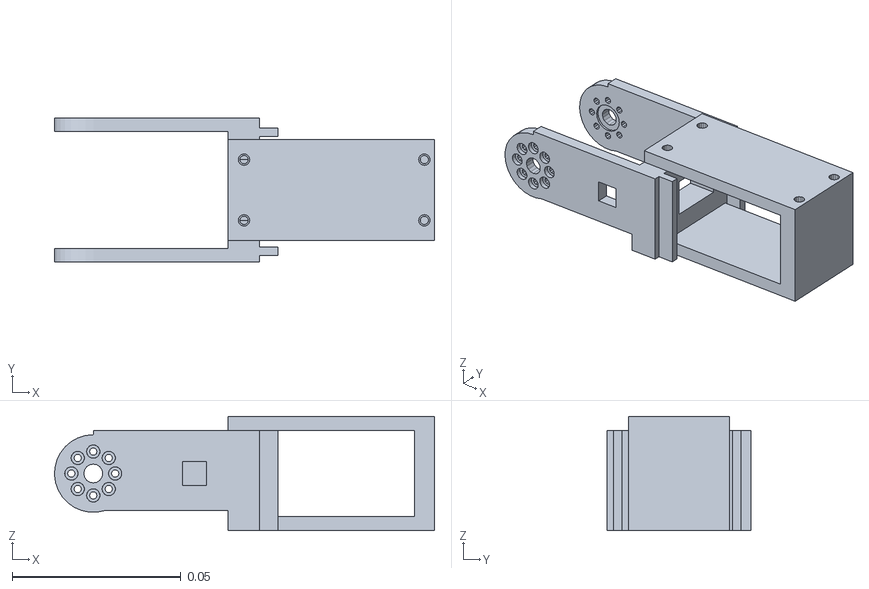
[picture p41: CAD file, 2026-10-19]
sim/rocky_mujoco/meshes/leg_femur.stl
0.113 x 0.0427 x 0.0338
