PotatoPeaSea/Rocky/(list of files, cad)

Other CAD files:
sim/rocky_mujoco/meshes/servo_femur.stl
