PotatoPeaSea/Rocky/sim/rocky_mujoco/rocky.xml

<mujoco model="rocky_pentapod">
  <!-- GENERATED by build_model.py - edit that script, not this file. Units: m, kg, s, rad. -->
  <compiler angle="radian" meshdir="meshes" autolimits="true"/>
  <option timestep="0.002" integrator="implicitfast" cone="pyramidal" impratio="1">
    <flag eulerdamp="disable"/>
  </option>
  <size memory="20M"/>
  <default>
    <default class="rocky">
      <joint type="hinge" armature="0.004" damping="0.5338" frictionloss="0.03" limited="true"/>
      <!-- HX-30HM: voltage-mode P servo. force = kp*(target - q) clipped to the stall torque;
           the back-EMF term (-kv * qdot) is the joint damping above, so the torque-speed line
           tau_max(w) = tau_stall (1 - w / w_noload) comes out of the physics. -->
      <general dyntype="none" gaintype="fixed" biastype="affine" gainprm="30.0" biasprm="0 -30.0 0" forcerange="-2.9420 2.9420" ctrllimited="true"/>
      <geom contype="0" conaffinity="0" group="2" density="0" type="mesh"/>
      <site group="4"/>
      <default class="visual_body"><geom rgba="0.86 0.80 0.70 1"/></default>
      <default class="visual_leg"><geom rgba="0.72 0.62 0.50 1"/></default>
      <default class="visual_servo"><geom rgba="0.12 0.12 0.13 1"/></default>
      <default class="visual_foot"><geom rgba="0.20 0.20 0.20 1"/></default>
      <default class="visual_elec"><geom rgba="0.15 0.45 0.25 1"/></default>
      <default class="visual_batt"><geom rgba="0.15 0.25 0.65 1"/></default>
      <default class="collision">
        <geom group="3" contype="1" conaffinity="1" condim="3" friction="0.6 0.005 0.0001" rgba="0.8 0.3 0.3 0.4" density="0" solref="0.005 1"/>
        <default class="foot">
          <geom type="sphere" size="0.010" friction="1.0 0.01 0.001" priority="1" solref="0.006 1" solimp="0.9 0.95 0.001"/>
        </default>
      </default>
    </default>
  </default>
  <asset>
    <mesh name="base_chassis" file="base_chassis.stl"/>
    <mesh name="base_dome" file="base_dome.stl"/>
    <mesh name="base_hip_servos" file="base_hip_servos.stl"/>
    <mesh name="battery" file="battery.stl"/>
    <mesh name="camera_mount_cap" file="camera_mount_cap.stl"/>
    <mesh name="camera_oakd_lite" file="camera_oakd_lite.stl"/>
    <mesh name="leg_coxa" file="leg_coxa.stl"/>
    <mesh name="leg_femur" file="leg_femur.stl"/>
    <mesh name="leg_foot" file="leg_foot.stl"/>
    <mesh name="leg_tibia" file="leg_tibia.stl"/>
    <mesh name="pi5" file="pi5.stl"/>
    <mesh name="pi5_cooler" file="pi5_cooler.stl"/>
    <mesh name="servo_femur" file="servo_femur.stl"/>
    <mesh name="servo_knee" file="servo_knee.stl"/>
  </asset>
  <worldbody>
    <body name="base" pos="0 0 0.0930" childclass="rocky">
      <freejoint name="root"/>
      <inertial pos="-0.000473324 4.75896e-05 0.0193728" mass="1.30498" fullinertia="0.0053368 0.0055498 0.0071586 7.4944e-07 1.6021e-05 2.0103e-06"/>
      <geom name="v_chassis" mesh="base_chassis" class="visual_body"/>
      <geom name="v_dome" mesh="base_dome" class="visual_body" group="1"/>
      <geom name="v_hip_servos" mesh="base_hip_servos" class="visual_servo"/>
      <geom name="v_battery" mesh="battery" class="visual_batt"/>
      <geom name="v_pi5" mesh="pi5" class="visual_elec"/>
      <geom name="v_pi5_cooler" mesh="pi5_cooler" class="visual_servo"/>
      <geom name="v_control_pcb" type="box" pos="0 0 0.0285" size="0.0375 0.0375 0.006" class="visual_elec"/>
      <!-- collision: convex hulls of the chassis (plates, tray, deck) and of the dome cap -->
      <geom name="c_chassis" mesh="base_chassis" type="mesh" class="collision"/>
      <geom name="c_dome" mesh="base_dome" type="mesh" class="collision"/>
      <site name="imu" pos="-0.0483 0.04145 0.0605" size="0.006" rgba="1 0.5 0 1" group="4"/>
      <site name="base_center" pos="0 0 0" size="0.005"/>
      <!-- v7: Luxonis OAK-D Lite on the camera-mount apex cap (fusion/pentapod_camera_v7.py) -->
      <geom name="v_camera_mount" mesh="camera_mount_cap" class="visual_body" group="1"/>
      <body name="camera" pos="0 -0.03887 0.13303">
        <inertial pos="0.000316019 0.0136075 -0.00478317" mass="0.07535" fullinertia="1.7645e-05 5.8453e-05 6.0948e-05 -2.5737e-08 5.4274e-08 4.3655e-06"/>
        <geom name="v_camera" mesh="camera_oakd_lite" class="visual_servo"/>
        <geom name="c_camera" type="box" pos="0 0.00974595 -0.00256496" xyaxes="1 0 0 0 0.96593 0.25882" size="0.0455 0.00875 0.014" class="collision"/>
        <!-- MuJoCo cameras look along -z (y up): z = (0, cos p, sin p), image right = body -x.
             2 mm in front of the cover glass so the housing never enters the view. -->
        <camera name="oakd" pos="0 -0.00193 -0.00052" xyaxes="-1 0 0 0 -0.25882 0.96593" fovy="58.0"/>
        <site name="camera" size="0.004" rgba="0 0.6 1 1"/>
      </body>
      <!-- ===== leg 1  (servo IDs 1, 2, 3) at 90 deg ===== -->
      <body name="leg1_coxa" pos="0 0.1 0" quat="0.70710678 0 0 0.70710678">
        <inertial pos="0.0394231 -2.99581e-05 -0.000257308" mass="0.09595" fullinertia="3.3807e-05 5.107e-05 3.2366e-05 9.4609e-09 1.1158e-07 -1.6025e-07"/>
        <joint name="leg1_hip" axis="0 0 1" range="-1.30900 1.30900"/>
        <geom name="leg1_v_coxa" mesh="leg_coxa" class="visual_leg"/>
        <geom name="leg1_v_femur_servo" mesh="servo_femur" class="visual_servo"/>
        <geom name="leg1_c_coxa" type="box" pos="0.0250 0 0" size="0.0390 0.0180 0.0275" class="collision"/>
        <body name="leg1_femur" pos="0.0447 0 0.01275">
          <inertial pos="0.0648913 5.50112e-05 -7.41357e-05" mass="0.09314" fullinertia="1.7862e-05 5.4055e-05 5.7539e-05 5.5249e-08 1.308e-07 -1.1524e-09"/>
          <joint name="leg1_femur" axis="0 -1 0" range="-0.78540 1.48353"/>
          <geom name="leg1_v_femur" mesh="leg_femur" class="visual_leg"/>
          <geom name="leg1_v_knee_servo" mesh="servo_knee" class="visual_servo"/>
          <geom name="leg1_c_femur" type="box" pos="0.0450 0 0" size="0.0560 0.0214 0.0169" class="collision"/>
          <body name="leg1_tibia" pos="0.085 0 0">
            <inertial pos="0.00687846 2.12948e-09 -0.0599025" mass="0.05128" fullinertia="8.531e-05 7.5637e-05 1.4558e-05 0 3.2027e-06 -2.8442e-12"/>
            <joint name="leg1_knee" axis="0 1 0" range="-1.04720 1.30900"/>
            <geom name="leg1_v_tibia" mesh="leg_tibia" class="visual_leg"/>
            <geom name="leg1_v_foot" mesh="leg_foot" class="visual_foot"/>
            <geom name="leg1_c_tibia" type="box" pos="0.004 0 -0.020" size="0.018 0.0268 0.036" class="collision"/>
            <geom name="leg1_c_shank" type="capsule" fromto="0.008 0 -0.058 0.008 0 -0.112" size="0.009" class="collision"/>
            <geom name="leg1_foot" pos="0.008 0 -0.128" class="foot"/>
            <site name="leg1_foot" pos="0.008 0 -0.128" size="0.0115" type="sphere" rgba="0 1 0 0.3"/>
          </body>
        </body>
      </body>
      <!-- ===== leg 2  (servo IDs 4, 5, 6) at 162 deg ===== -->
      <body name="leg2_coxa" pos="-0.0951057 0.0309017 0" quat="0.15643447 0 0 0.98768834">
        <inertial pos="0.0394231 -2.99581e-05 -0.000257308" mass="0.09595" fullinertia="3.3807e-05 5.107e-05 3.2366e-05 9.4609e-09 1.1158e-07 -1.6025e-07"/>
        <joint name="leg2_hip" axis="0 0 1" range="-1.30900 1.30900"/>
        <geom name="leg2_v_coxa" mesh="leg_coxa" class="visual_leg"/>
        <geom name="leg2_v_femur_servo" mesh="servo_femur" class="visual_servo"/>
        <geom name="leg2_c_coxa" type="box" pos="0.0250 0 0" size="0.0390 0.0180 0.0275" class="collision"/>
        <body name="leg2_femur" pos="0.0447 0 0.01275">
          <inertial pos="0.0648913 5.50112e-05 -7.41357e-05" mass="0.09314" fullinertia="1.7862e-05 5.4055e-05 5.7539e-05 5.5249e-08 1.308e-07 -1.1524e-09"/>
          <joint name="leg2_femur" axis="0 -1 0" range="-0.78540 1.48353"/>
          <geom name="leg2_v_femur" mesh="leg_femur" class="visual_leg"/>
          <geom name="leg2_v_knee_servo" mesh="servo_knee" class="visual_servo"/>
          <geom name="leg2_c_femur" type="box" pos="0.0450 0 0" size="0.0560 0.0214 0.0169" class="collision"/>
          <body name="leg2_tibia" pos="0.085 0 0">
            <inertial pos="0.00687846 2.12948e-09 -0.0599025" mass="0.05128" fullinertia="8.531e-05 7.5637e-05 1.4558e-05 0 3.2027e-06 -2.8442e-12"/>
            <joint name="leg2_knee" axis="0 1 0" range="-1.04720 1.30900"/>
            <geom name="leg2_v_tibia" mesh="leg_tibia" class="visual_leg"/>
            <geom name="leg2_v_foot" mesh="leg_foot" class="visual_foot"/>
            <geom name="leg2_c_tibia" type="box" pos="0.004 0 -0.020" size="0.018 0.0268 0.036" class="collision"/>
            <geom name="leg2_c_shank" type="capsule" fromto="0.008 0 -0.058 0.008 0 -0.112" size="0.009" class="collision"/>
            <geom name="leg2_foot" pos="0.008 0 -0.128" class="foot"/>
            <site name="leg2_foot" pos="0.008 0 -0.128" size="0.0115" type="sphere" rgba="0 1 0 0.3"/>
          </body>
        </body>
      </body>
      <!-- ===== leg 3  (servo IDs 7, 8, 9) at 234 deg ===== -->
      <body name="leg3_coxa" pos="-0.0587785 -0.0809017 0" quat="-0.45399050 0 0 0.89100652">
        <inertial pos="0.0394231 -2.99581e-05 -0.000257308" mass="0.09595" fullinertia="3.3807e-05 5.107e-05 3.2366e-05 9.4609e-09 1.1158e-07 -1.6025e-07"/>
        <joint name="leg3_hip" axis="0 0 1" range="-1.30900 1.30900"/>
        <geom name="leg3_v_coxa" mesh="leg_coxa" class="visual_leg"/>
        <geom name="leg3_v_femur_servo" mesh="servo_femur" class="visual_servo"/>
        <geom name="leg3_c_coxa" type="box" pos="0.0250 0 0" size="0.0390 0.0180 0.0275" class="collision"/>
        <body name="leg3_femur" pos="0.0447 0 0.01275">
          <inertial pos="0.0648913 5.50112e-05 -7.41357e-05" mass="0.09314" fullinertia="1.7862e-05 5.4055e-05 5.7539e-05 5.5249e-08 1.308e-07 -1.1524e-09"/>
          <joint name="leg3_femur" axis="0 -1 0" range="-0.78540 1.48353"/>
          <geom name="leg3_v_femur" mesh="leg_femur" class="visual_leg"/>
          <geom name="leg3_v_knee_servo" mesh="servo_knee" class="visual_servo"/>
          <geom name="leg3_c_femur" type="box" pos="0.0450 0 0" size="0.0560 0.0214 0.0169" class="collision"/>
          <body name="leg3_tibia" pos="0.085 0 0">
            <inertial pos="0.00687846 2.12948e-09 -0.0599025" mass="0.05128" fullinertia="8.531e-05 7.5637e-05 1.4558e-05 0 3.2027e-06 -2.8442e-12"/>
            <joint name="leg3_knee" axis="0 1 0" range="-1.04720 1.30900"/>
            <geom name="leg3_v_tibia" mesh="leg_tibia" class="visual_leg"/>
            <geom name="leg3_v_foot" mesh="leg_foot" class="visual_foot"/>
            <geom name="leg3_c_tibia" type="box" pos="0.004 0 -0.020" size="0.018 0.0268 0.036" class="collision"/>
            <geom name="leg3_c_shank" type="capsule" fromto="0.008 0 -0.058 0.008 0 -0.112" size="0.009" class="collision"/>
            <geom name="leg3_foot" pos="0.008 0 -0.128" class="foot"/>
            <site name="leg3_foot" pos="0.008 0 -0.128" size="0.0115" type="sphere" rgba="0 1 0 0.3"/>
          </body>
        </body>
      </body>
      <!-- ===== leg 4  (servo IDs 10, 11, 12) at 306 deg ===== -->
      <body name="leg4_coxa" pos="0.0587785 -0.0809017 0" quat="-0.89100652 0 0 0.45399050">
        <inertial pos="0.0394231 -2.99581e-05 -0.000257308" mass="0.09595" fullinertia="3.3807e-05 5.107e-05 3.2366e-05 9.4609e-09 1.1158e-07 -1.6025e-07"/>
        <joint name="leg4_hip" axis="0 0 1" range="-1.30900 1.30900"/>
        <geom name="leg4_v_coxa" mesh="leg_coxa" class="visual_leg"/>
        <geom name="leg4_v_femur_servo" mesh="servo_femur" class="visual_servo"/>
        <geom name="leg4_c_coxa" type="box" pos="0.0250 0 0" size="0.0390 0.0180 0.0275" class="collision"/>
        <body name="leg4_femur" pos="0.0447 0 0.01275">
          <inertial pos="0.0648913 5.50112e-05 -7.41357e-05" mass="0.09314" fullinertia="1.7862e-05 5.4055e-05 5.7539e-05 5.5249e-08 1.308e-07 -1.1524e-09"/>
          <joint name="leg4_femur" axis="0 -1 0" range="-0.78540 1.48353"/>
          <geom name="leg4_v_femur" mesh="leg_femur" class="visual_leg"/>
          <geom name="leg4_v_knee_servo" mesh="servo_knee" class="visual_servo"/>
          <geom name="leg4_c_femur" type="box" pos="0.0450 0 0" size="0.0560 0.0214 0.0169" class="collision"/>
          <body name="leg4_tibia" pos="0.085 0 0">
            <inertial pos="0.00687846 2.12948e-09 -0.0599025" mass="0.05128" fullinertia="8.531e-05 7.5637e-05 1.4558e-05 0 3.2027e-06 -2.8442e-12"/>
            <joint name="leg4_knee" axis="0 1 0" range="-1.04720 1.30900"/>
            <geom name="leg4_v_tibia" mesh="leg_tibia" class="visual_leg"/>
            <geom name="leg4_v_foot" mesh="leg_foot" class="visual_foot"/>
            <geom name="leg4_c_tibia" type="box" pos="0.004 0 -0.020" size="0.018 0.0268 0.036" class="collision"/>
            <geom name="leg4_c_shank" type="capsule" fromto="0.008 0 -0.058 0.008 0 -0.112" size="0.009" class="collision"/>
            <geom name="leg4_foot" pos="0.008 0 -0.128" class="foot"/>
            <site name="leg4_foot" pos="0.008 0 -0.128" size="0.0115" type="sphere" rgba="0 1 0 0.3"/>
          </body>
        </body>
      </body>
      <!-- ===== leg 5  (servo IDs 13, 14, 15) at 378 deg ===== -->
      <body name="leg5_coxa" pos="0.0951057 0.0309017 0" quat="-0.98768834 0 0 -0.15643447">
        <inertial pos="0.0394231 -2.99581e-05 -0.000257308" mass="0.09595" fullinertia="3.3807e-05 5.107e-05 3.2366e-05 9.4609e-09 1.1158e-07 -1.6025e-07"/>
        <joint name="leg5_hip" axis="0 0 1" range="-1.30900 1.30900"/>
        <geom name="leg5_v_coxa" mesh="leg_coxa" class="visual_leg"/>
        <geom name="leg5_v_femur_servo" mesh="servo_femur" class="visual_servo"/>
        <geom name="leg5_c_coxa" type="box" pos="0.0250 0 0" size="0.0390 0.0180 0.0275" class="collision"/>
        <body name="leg5_femur" pos="0.0447 0 0.01275">
          <inertial pos="0.0648913 5.50112e-05 -7.41357e-05" mass="0.09314" fullinertia="1.7862e-05 5.4055e-05 5.7539e-05 5.5249e-08 1.308e-07 -1.1524e-09"/>
          <joint name="leg5_femur" axis="0 -1 0" range="-0.78540 1.48353"/>
          <geom name="leg5_v_femur" mesh="leg_femur" class="visual_leg"/>
          <geom name="leg5_v_knee_servo" mesh="servo_knee" class="visual_servo"/>
          <geom name="leg5_c_femur" type="box" pos="0.0450 0 0" size="0.0560 0.0214 0.0169" class="collision"/>
          <body name="leg5_tibia" pos="0.085 0 0">
            <inertial pos="0.00687846 2.12948e-09 -0.0599025" mass="0.05128" fullinertia="8.531e-05 7.5637e-05 1.4558e-05 0 3.2027e-06 -2.8442e-12"/>
            <joint name="leg5_knee" axis="0 1 0" range="-1.04720 1.30900"/>
            <geom name="leg5_v_tibia" mesh="leg_tibia" class="visual_leg"/>
            <geom name="leg5_v_foot" mesh="leg_foot" class="visual_foot"/>
            <geom name="leg5_c_tibia" type="box" pos="0.004 0 -0.020" size="0.018 0.0268 0.036" class="collision"/>
            <geom name="leg5_c_shank" type="capsule" fromto="0.008 0 -0.058 0.008 0 -0.112" size="0.009" class="collision"/>
            <geom name="leg5_foot" pos="0.008 0 -0.128" class="foot"/>
            <site name="leg5_foot" pos="0.008 0 -0.128" size="0.0115" type="sphere" rgba="0 1 0 0.3"/>
          </body>
        </body>
      </body>
    </body>
  </worldbody>
  <contact>
    <!-- adjacent links inside one leg touch at the servo horns: no contact pairs needed -->
    <exclude body1="base" body2="leg1_femur"/>
    <exclude body1="base" body2="leg2_femur"/>
    <exclude body1="base" body2="leg3_femur"/>
    <exclude body1="base" body2="leg4_femur"/>
    <exclude body1="base" body2="leg5_femur"/>
  </contact>
  <actuator>
    <general name="s01_leg1_hip" joint="leg1_hip" class="rocky" ctrlrange="-1.30900 1.30900"/>
    <general name="s02_leg1_femur" joint="leg1_femur" class="rocky" ctrlrange="-0.78540 1.48353"/>
    <general name="s03_leg1_knee" joint="leg1_knee" class="rocky" ctrlrange="-1.04720 1.30900"/>
    <general name="s04_leg2_hip" joint="leg2_hip" class="rocky" ctrlrange="-1.30900 1.30900"/>
    <general name="s05_leg2_femur" joint="leg2_femur" class="rocky" ctrlrange="-0.78540 1.48353"/>
    <general name="s06_leg2_knee" joint="leg2_knee" class="rocky" ctrlrange="-1.04720 1.30900"/>
    <general name="s07_leg3_hip" joint="leg3_hip" class="rocky" ctrlrange="-1.30900 1.30900"/>
    <general name="s08_leg3_femur" joint="leg3_femur" class="rocky" ctrlrange="-0.78540 1.48353"/>
    <general name="s09_leg3_knee" joint="leg3_knee" class="rocky" ctrlrange="-1.04720 1.30900"/>
    <general name="s10_leg4_hip" joint="leg4_hip" class="rocky" ctrlrange="-1.30900 1.30900"/>
    <general name="s11_leg4_femur" joint="leg4_femur" class="rocky" ctrlrange="-0.78540 1.48353"/>
    <general name="s12_leg4_knee" joint="leg4_knee" class="rocky" ctrlrange="-1.04720 1.30900"/>
    <general name="s13_leg5_hip" joint="leg5_hip" class="rocky" ctrlrange="-1.30900 1.30900"/>
    <general name="s14_leg5_femur" joint="leg5_femur" class="rocky" ctrlrange="-0.78540 1.48353"/>
    <general name="s15_leg5_knee" joint="leg5_knee" class="rocky" ctrlrange="-1.04720 1.30900"/>
  </actuator>
  <sensor>
    <!-- BNO085-like IMU on the logic deck (v5 location) -->
    <framequat name="imu_quat" objtype="site" objname="imu"/>
    <gyro name="imu_gyro" site="imu"/>
    <accelerometer name="imu_acc" site="imu"/>
    <framelinvel name="base_linvel" objtype="site" objname="base_center"/>
    <framepos name="base_pos" objtype="site" objname="base_center"/>
    <jointpos name="q_leg1_hip" joint="leg1_hip"/>
    <jointpos name="q_leg1_femur" joint="leg1_femur"/>
    <jointpos name="q_leg1_knee" joint="leg1_knee"/>
    <jointpos name="q_leg2_hip" joint="leg2_hip"/>
    <jointpos name="q_leg2_femur" joint="leg2_femur"/>
    <jointpos name="q_leg2_knee" joint="leg2_knee"/>
    <jointpos name="q_leg3_hip" joint="leg3_hip"/>
    <jointpos name="q_leg3_femur" joint="leg3_femur"/>
    <jointpos name="q_leg3_knee" joint="leg3_knee"/>
    <jointpos name="q_leg4_hip" joint="leg4_hip"/>
    <jointpos name="q_leg4_femur" joint="leg4_femur"/>
    <jointpos name="q_leg4_knee" joint="leg4_knee"/>
    <jointpos name="q_leg5_hip" joint="leg5_hip"/>
    <jointpos name="q_leg5_femur" joint="leg5_femur"/>
    <jointpos name="q_leg5_knee" joint="leg5_knee"/>
    <jointvel name="dq_leg1_hip" joint="leg1_hip"/>
    <jointvel name="dq_leg1_femur" joint="leg1_femur"/>
    <jointvel name="dq_leg1_knee" joint="leg1_knee"/>
    <jointvel name="dq_leg2_hip" joint="leg2_hip"/>
    <jointvel name="dq_leg2_femur" joint="leg2_femur"/>
    <jointvel name="dq_leg2_knee" joint="leg2_knee"/>
    <jointvel name="dq_leg3_hip" joint="leg3_hip"/>
    <jointvel name="dq_leg3_femur" joint="leg3_femur"/>
    <jointvel name="dq_leg3_knee" joint="leg3_knee"/>
    <jointvel name="dq_leg4_hip" joint="leg4_hip"/>
    <jointvel name="dq_leg4_femur" joint="leg4_femur"/>
    <jointvel name="dq_leg4_knee" joint="leg4_knee"/>
    <jointvel name="dq_leg5_hip" joint="leg5_hip"/>
    <jointvel name="dq_leg5_femur" joint="leg5_femur"/>
    <jointvel name="dq_leg5_knee" joint="leg5_knee"/>
    <actuatorfrc name="tau_leg1_hip" actuator="s01_leg1_hip"/>
    <actuatorfrc name="tau_leg1_femur" actuator="s02_leg1_femur"/>
    <actuatorfrc name="tau_leg1_knee" actuator="s03_leg1_knee"/>
    <actuatorfrc name="tau_leg2_hip" actuator="s04_leg2_hip"/>
    <actuatorfrc name="tau_leg2_femur" actuator="s05_leg2_femur"/>
    <actuatorfrc name="tau_leg2_knee" actuator="s06_leg2_knee"/>
    <actuatorfrc name="tau_leg3_hip" actuator="s07_leg3_hip"/>
    <actuatorfrc name="tau_leg3_femur" actuator="s08_leg3_femur"/>
    <actuatorfrc name="tau_leg3_knee" actuator="s09_leg3_knee"/>
    <actuatorfrc name="tau_leg4_hip" actuator="s10_leg4_hip"/>
    <actuatorfrc name="tau_leg4_femur" actuator="s11_leg4_femur"/>
    <actuatorfrc name="tau_leg4_knee" actuator="s12_leg4_knee"/>
    <actuatorfrc name="tau_leg5_hip" actuator="s13_leg5_hip"/>
    <actuatorfrc name="tau_leg5_femur" actuator="s14_leg5_femur"/>
    <actuatorfrc name="tau_leg5_knee" actuator="s15_leg5_knee"/>
    <touch name="leg1_foot_touch" site="leg1_foot"/>
    <touch name="leg2_foot_touch" site="leg2_foot"/>
    <touch name="leg3_foot_touch" site="leg3_foot"/>
    <touch name="leg4_foot_touch" site="leg4_foot"/>
    <touch name="leg5_foot_touch" site="leg5_foot"/>
  </sensor>
  <keyframe>
    <key name="stand" qpos="0 0 0.091 1 0 0 0 0 0.4176534 0.4987375 0 0.4176534 0.4987375 0 0.4176534 0.4987375 0 0.4176534 0.4987375 0 0.4176534 0.4987375" ctrl="0 0.4176534 0.4987375 0 0.4176534 0.4987375 0 0.4176534 0.4987375 0 0.4176534 0.4987375 0 0.4176534 0.4987375"/>
    <key name="zero" qpos="0 0 0.12725 1 0 0 0 0 0 0 0 0 0 0 0 0 0 0 0 0 0 0" ctrl="0 0 0 0 0 0 0 0 0 0 0 0 0 0 0"/>
  </keyframe>
</mujoco>
