PotatoPeaSea/Rocky/pcb/rocky_ctrl/fab/rocky_ctrl_schematic.pdf

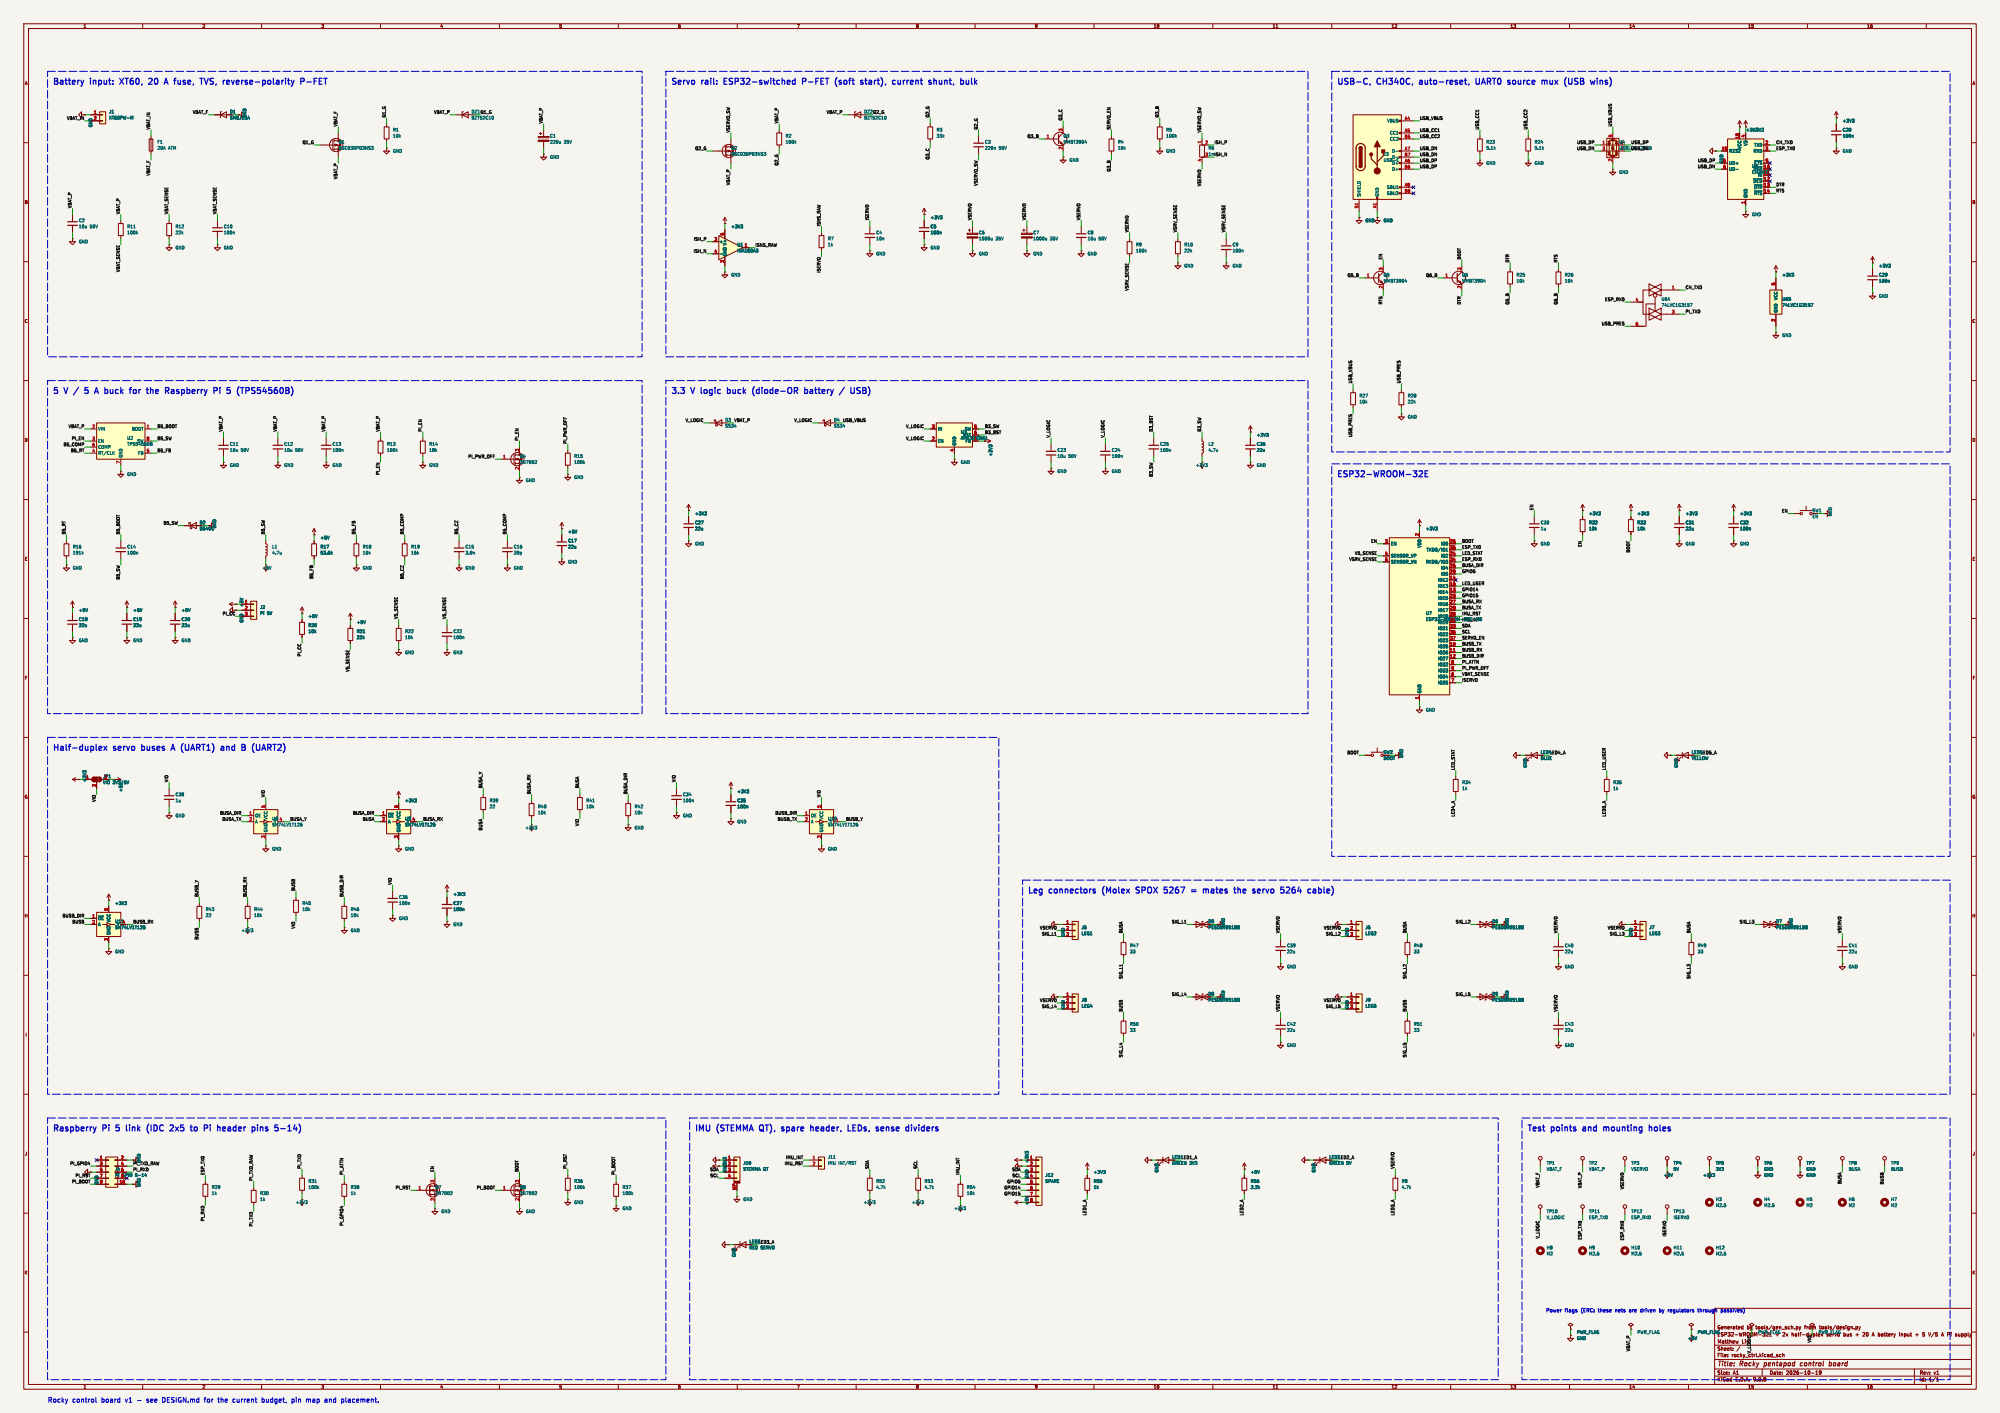
[picture p42: page 1]

3 2 Q6 MMBT3904 GND SHIELD S1 GND A1 VBUS

3 2 Q5 MMBT3904 GND GND GND GND

5 V / 5 A buck for the Raspberry Pi 5 (TPS54560B)

Leg connectors (Molex SPOX 5267 = mates the servo 5264 cable)

Id: 1/1 Title: Rocky pentapod control board

Rocky control board v1 - see DESIGN.md for the current budget, pin map and placement.
