PotatoPeaSea/Rocky/pcb/rocky_ctrl/rocky_ctrl.kicad_pcb

## KiCad design pcb/rocky_ctrl/rocky_ctrl.kicad_pcb (2026-10-20)

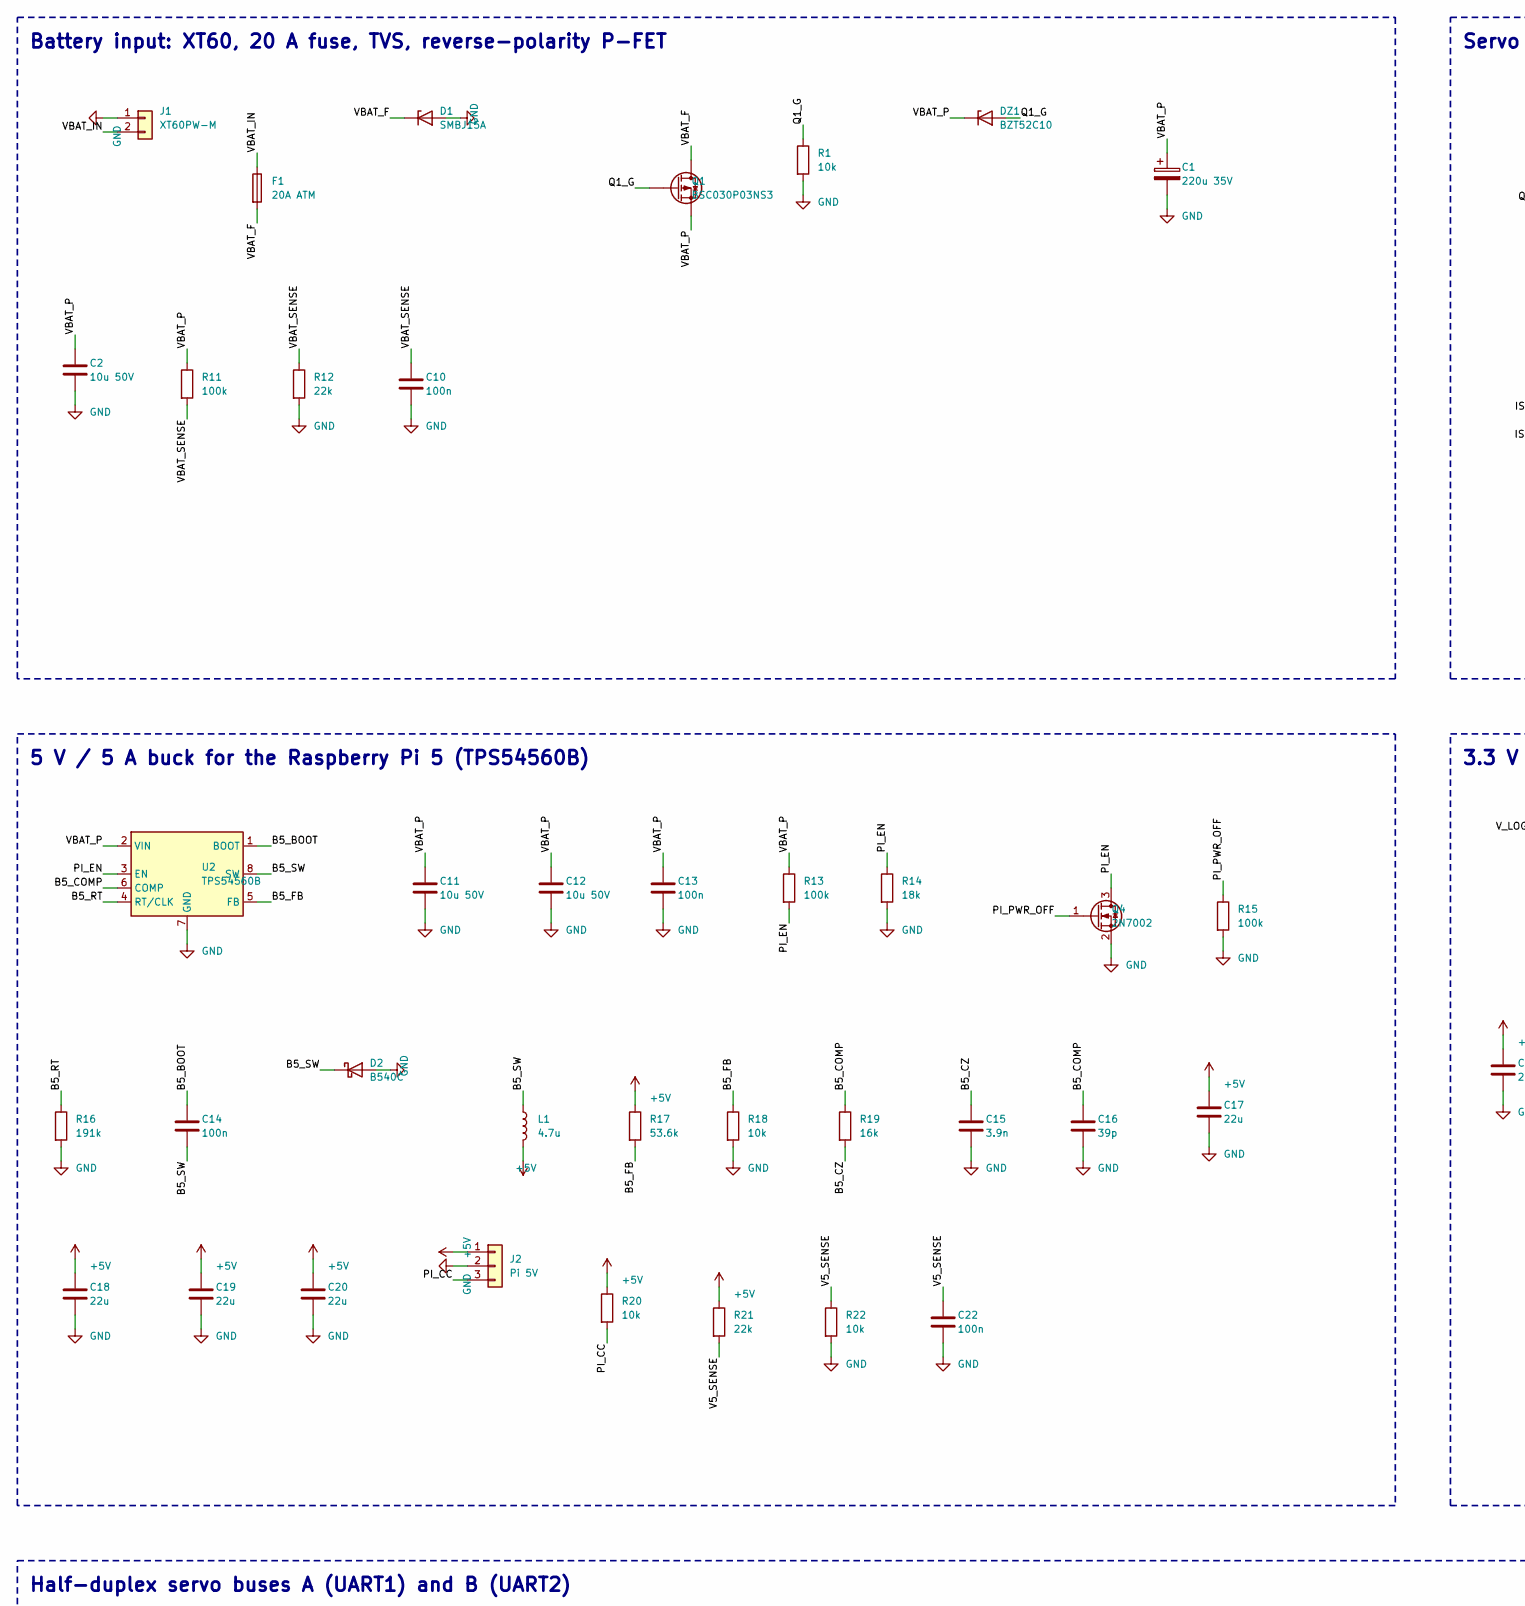
[picture p43: schematic rocky_ctrl.kicad_sch, Rocky pentapod control board, part in row 1, column 1]

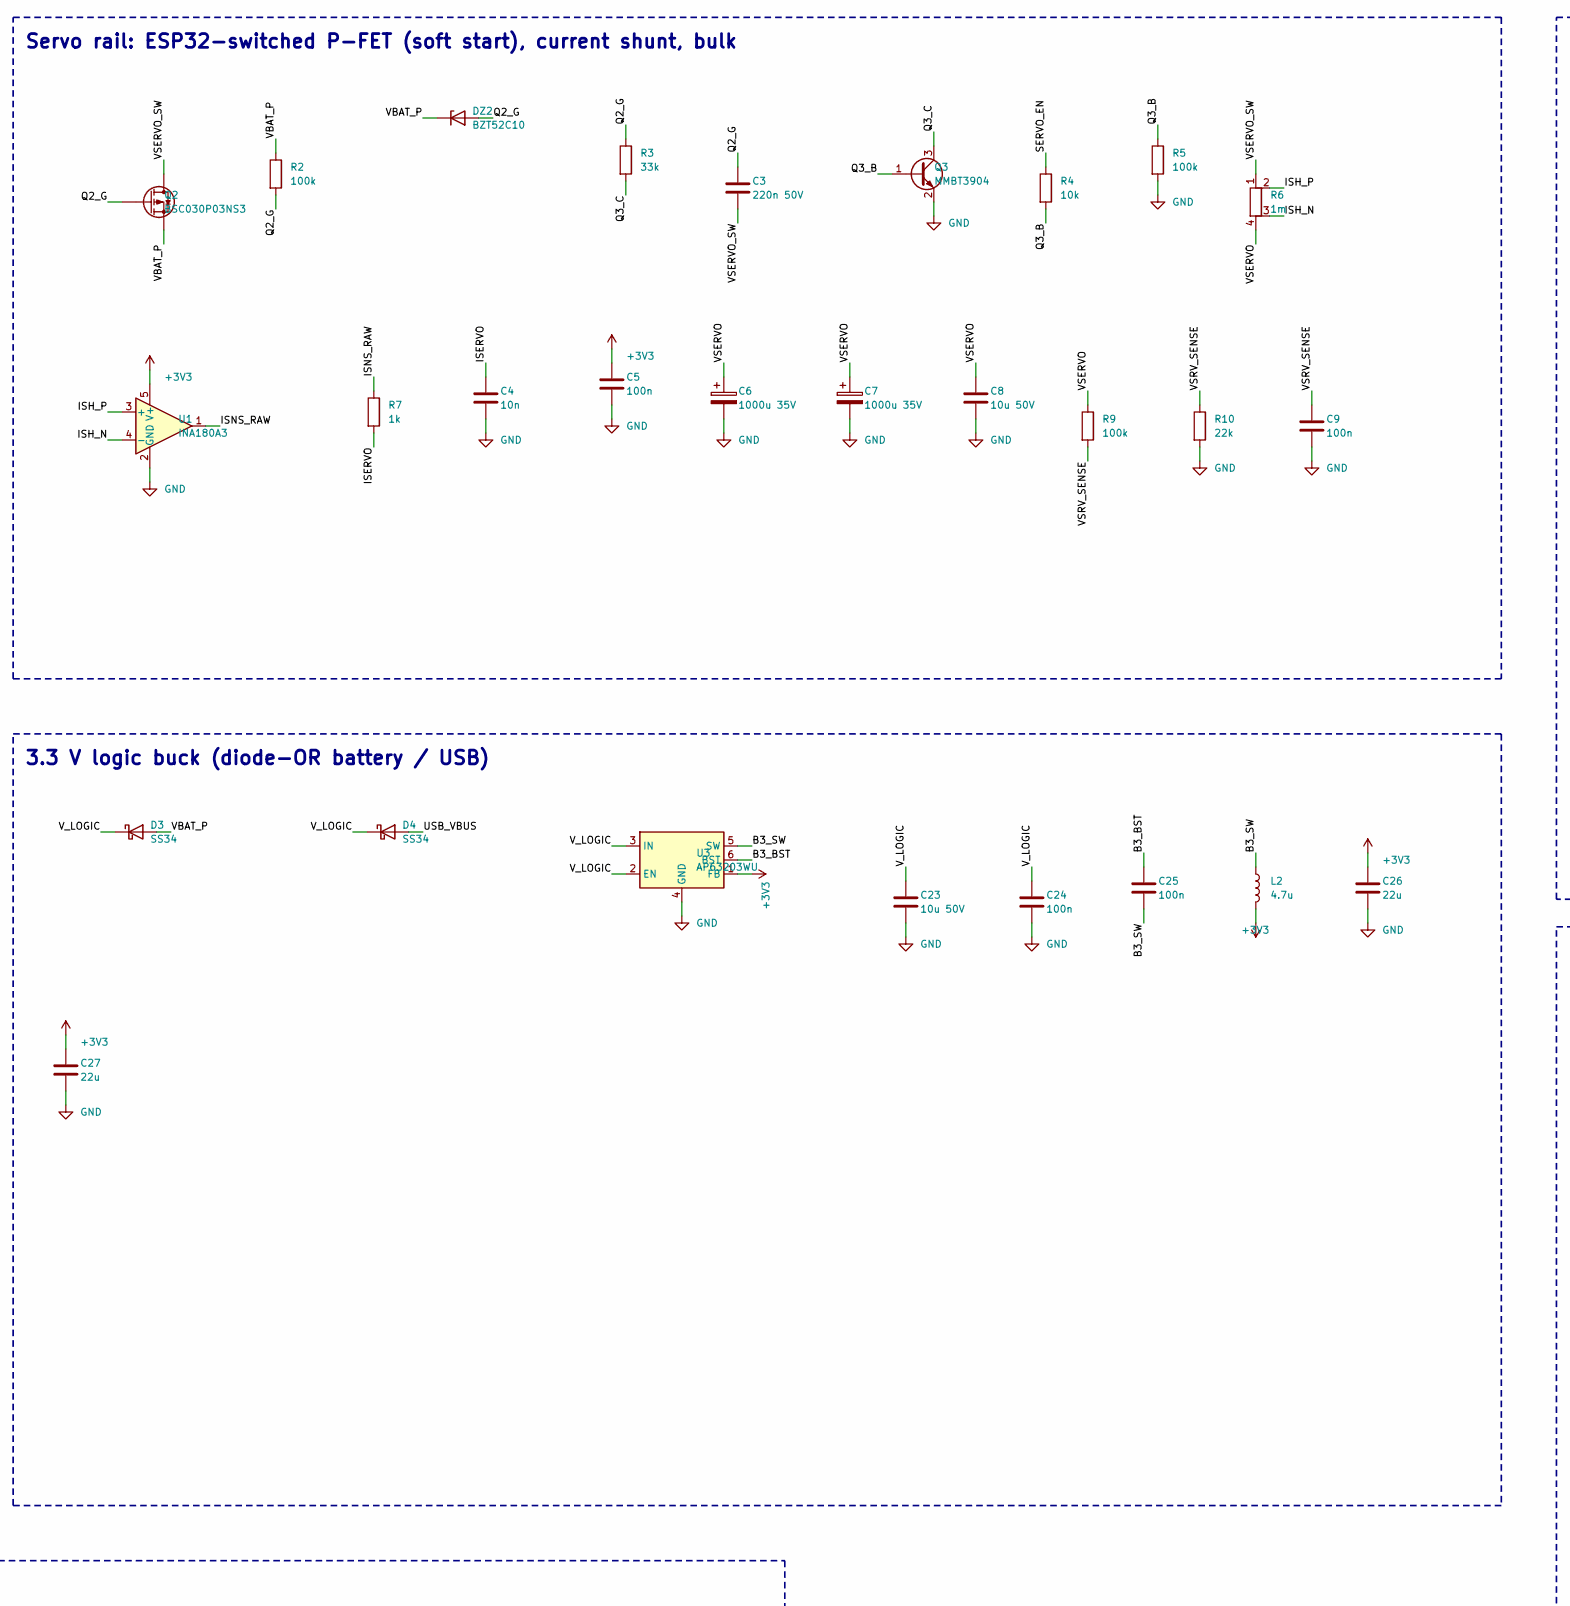
[picture p44: schematic rocky_ctrl.kicad_sch, Rocky pentapod control board, part in row 1, column 2]

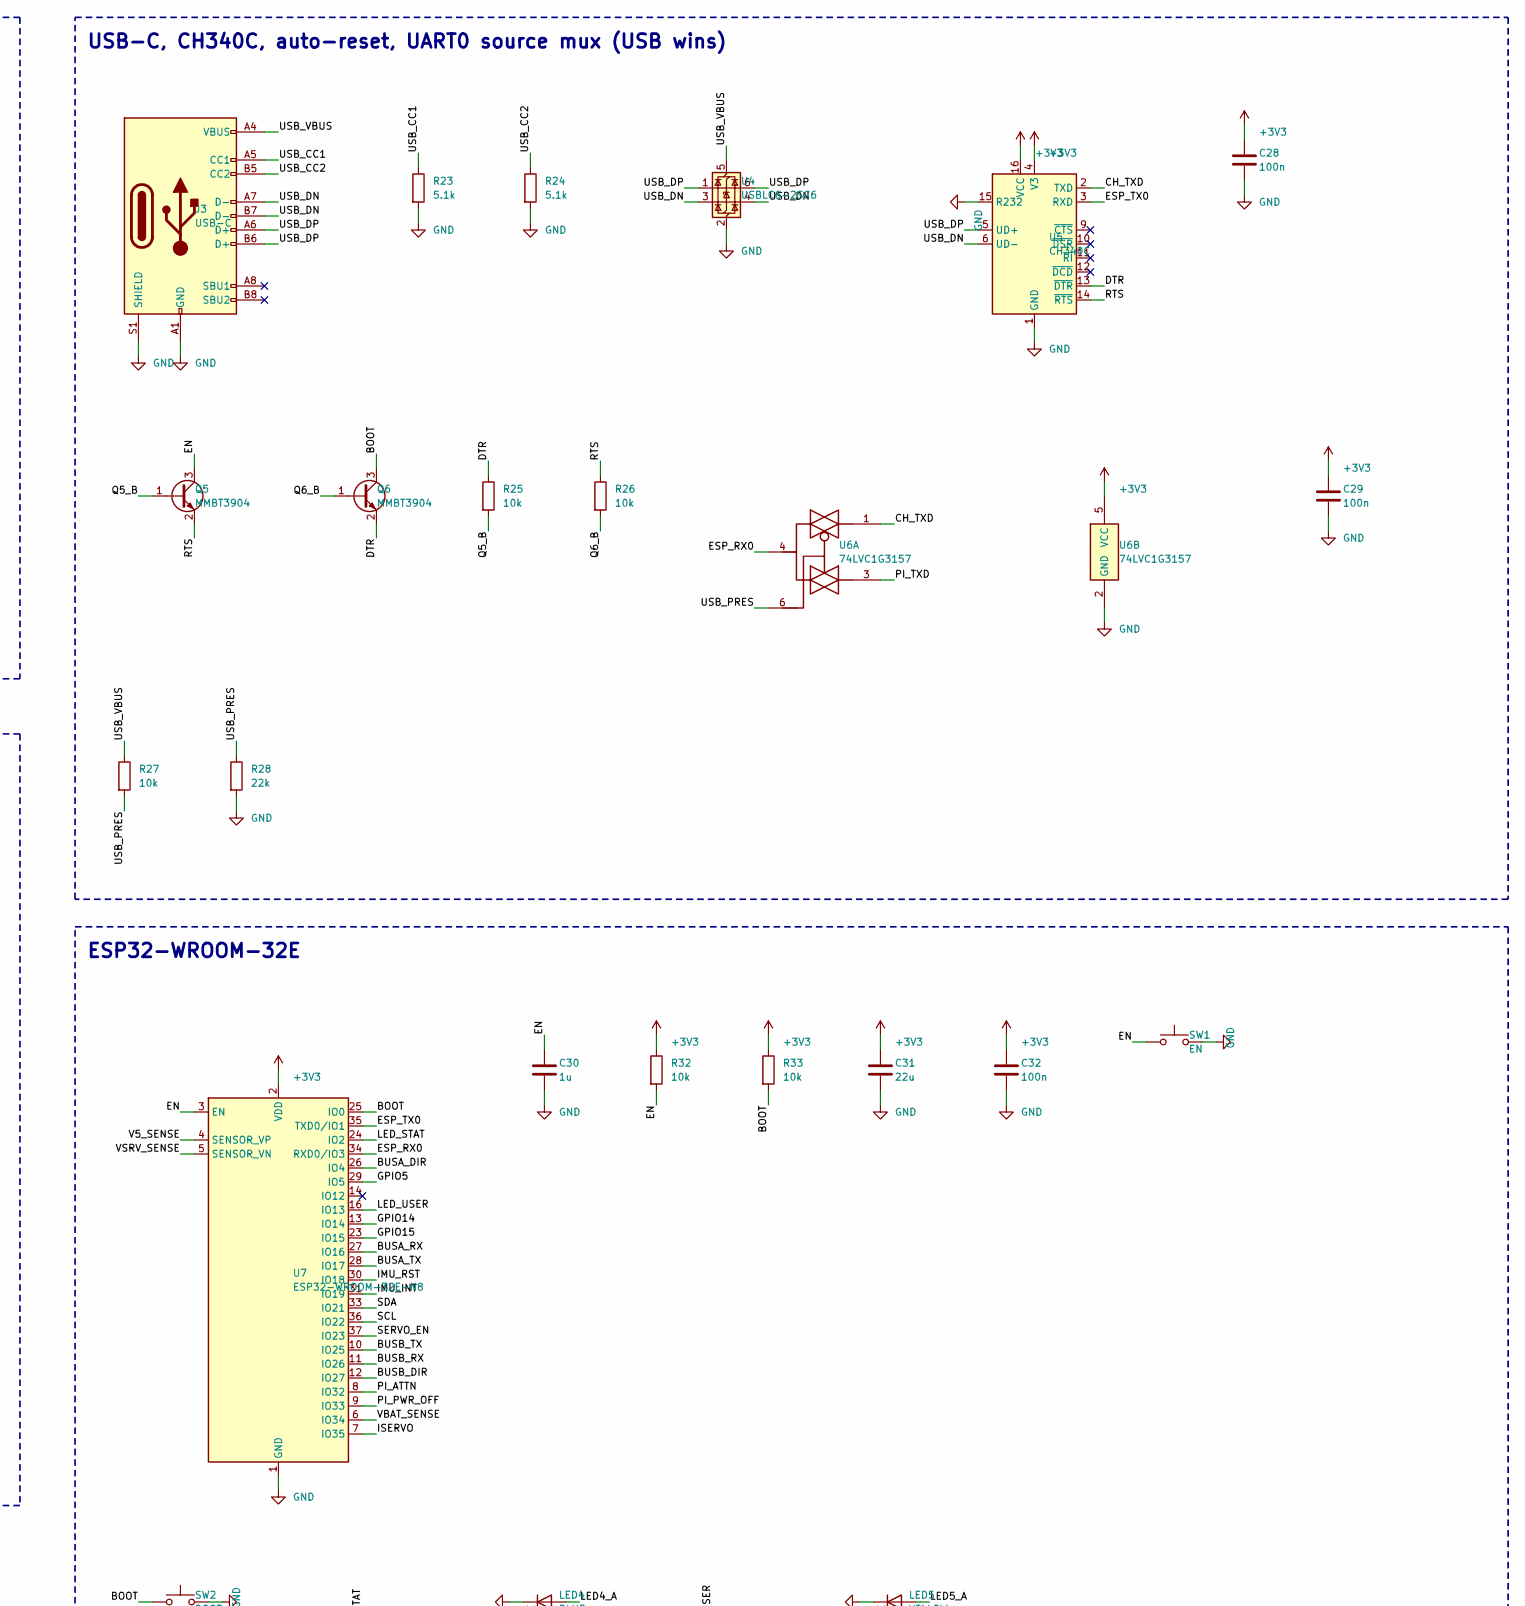
[picture p45: schematic rocky_ctrl.kicad_sch, Rocky pentapod control board, part in row 1, column 3]

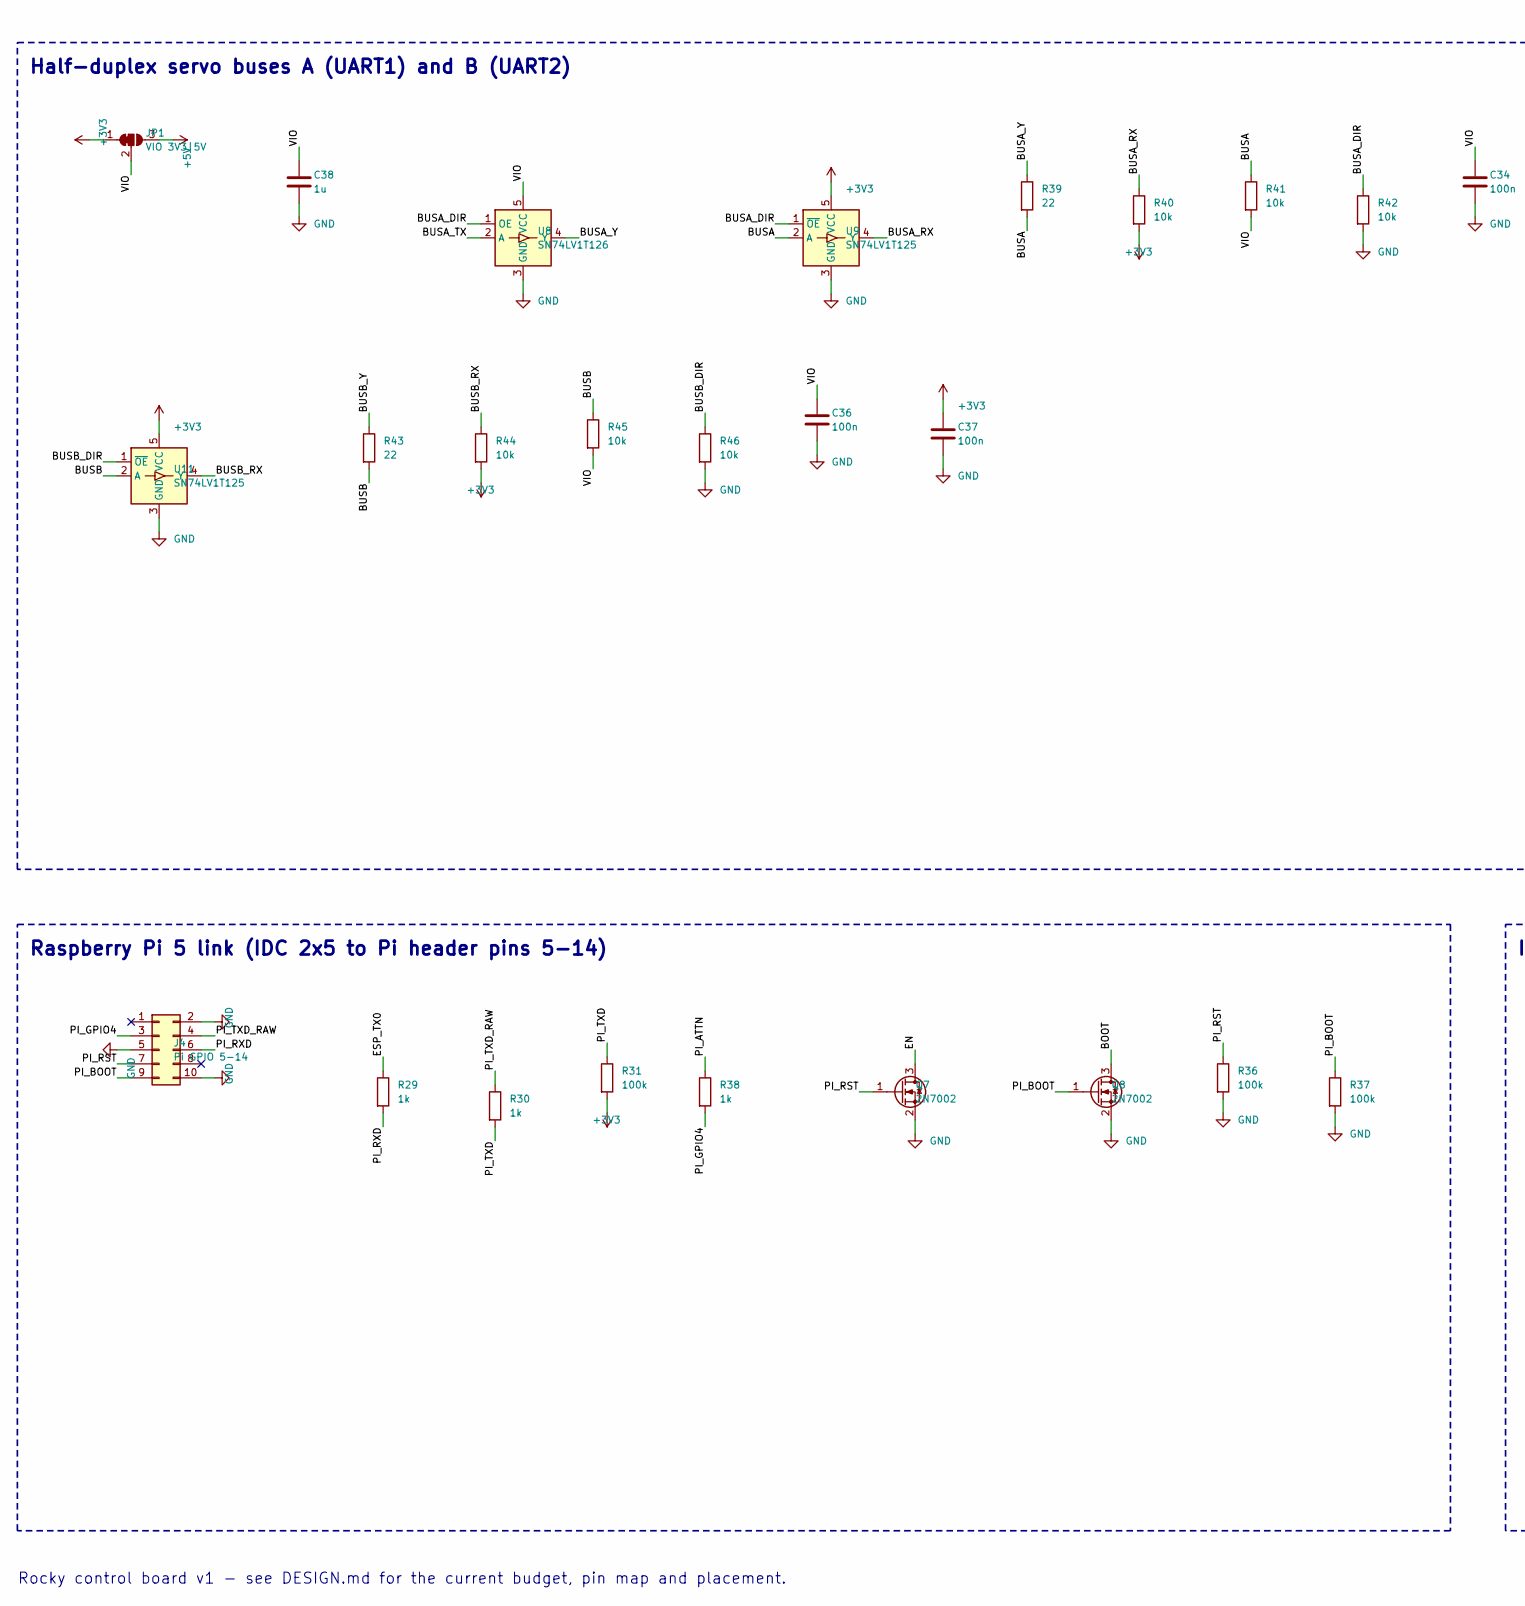
[picture p46: schematic rocky_ctrl.kicad_sch, Rocky pentapod control board, part in row 2, column 1]

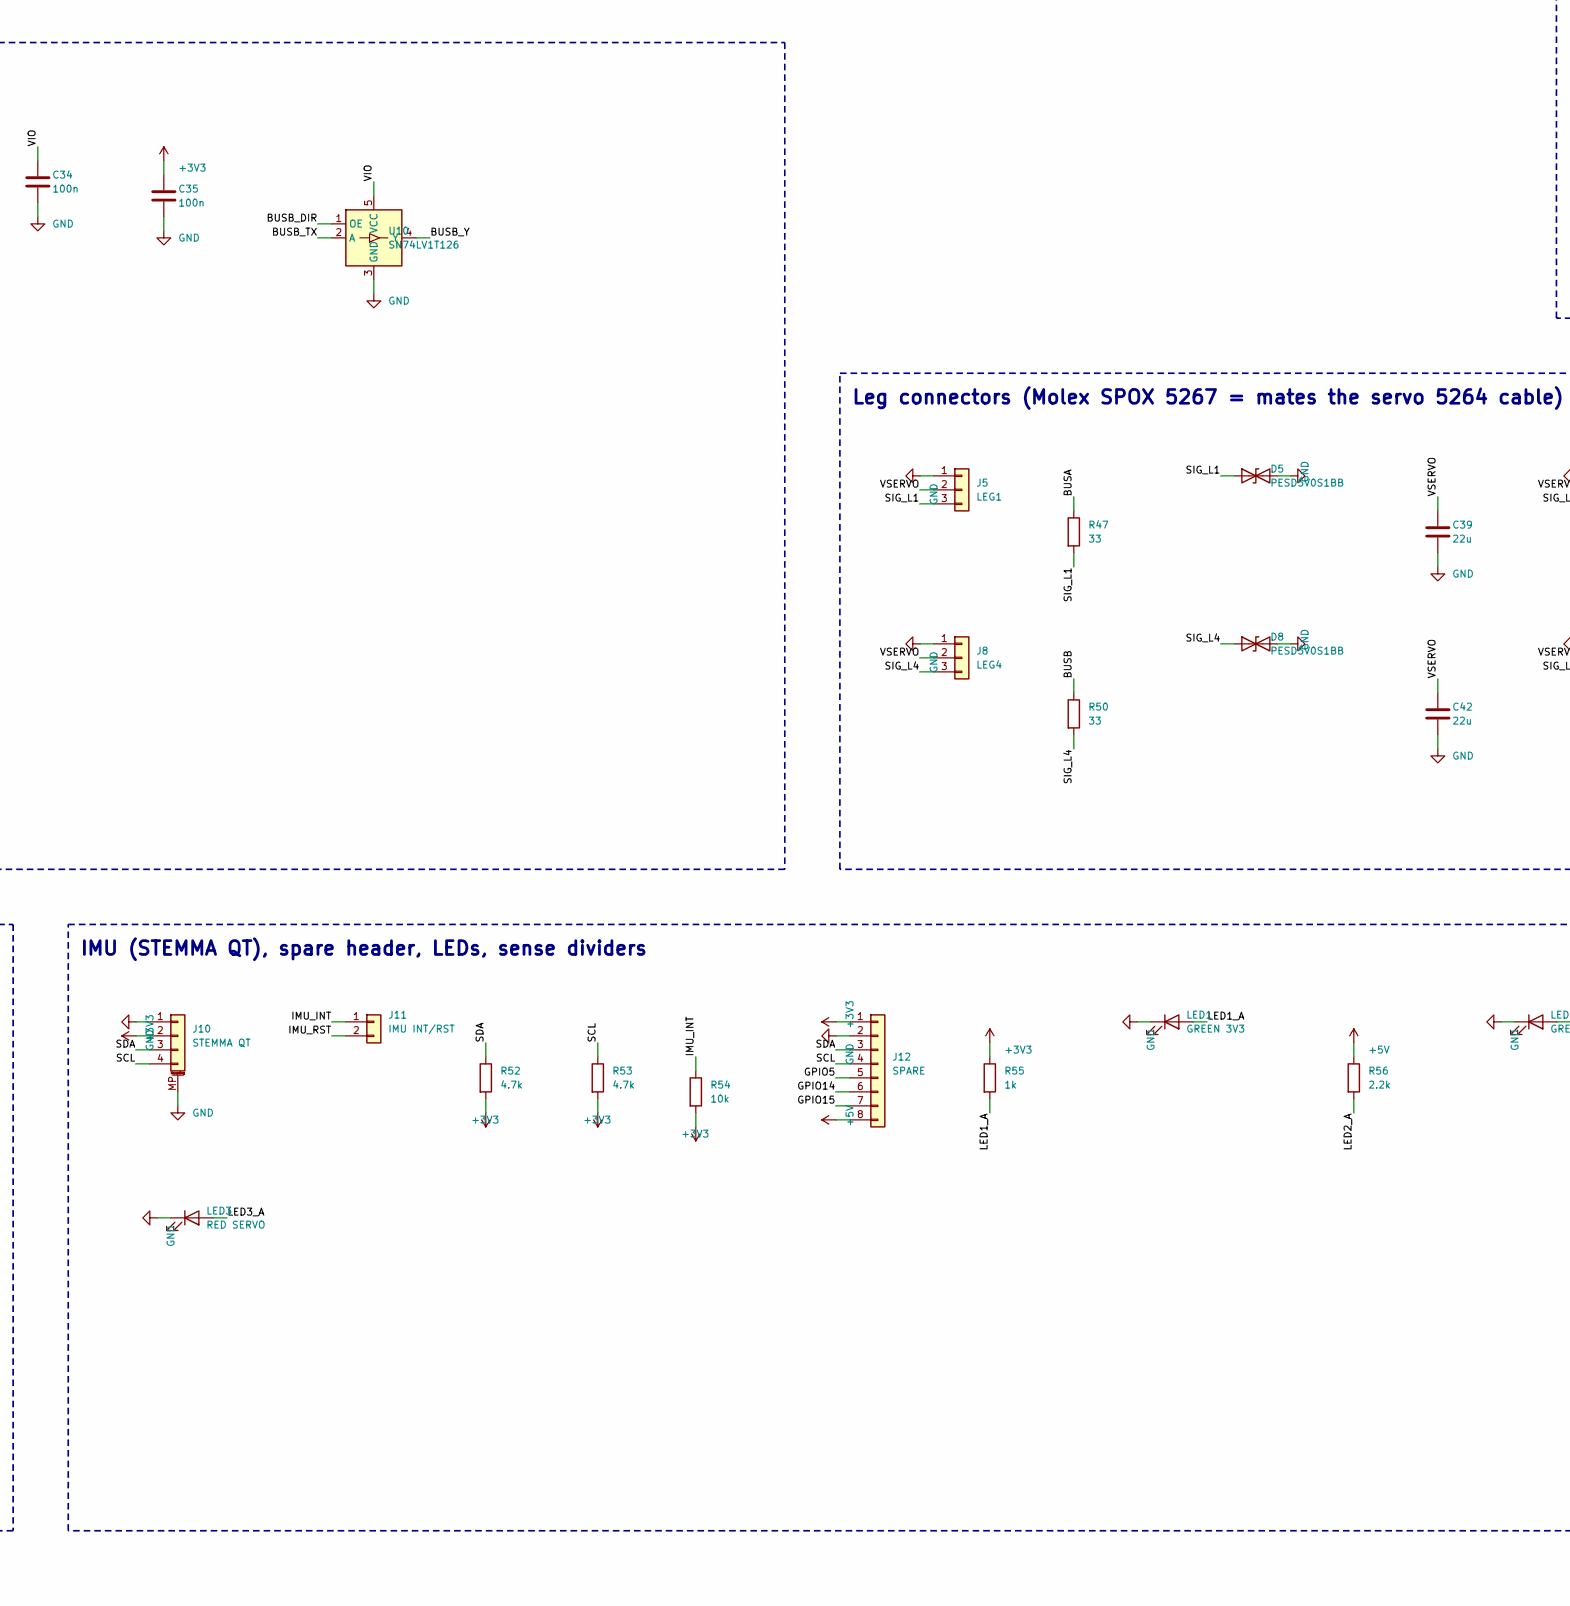
[picture p47: schematic rocky_ctrl.kicad_sch, Rocky pentapod control board, part in row 2, column 2]

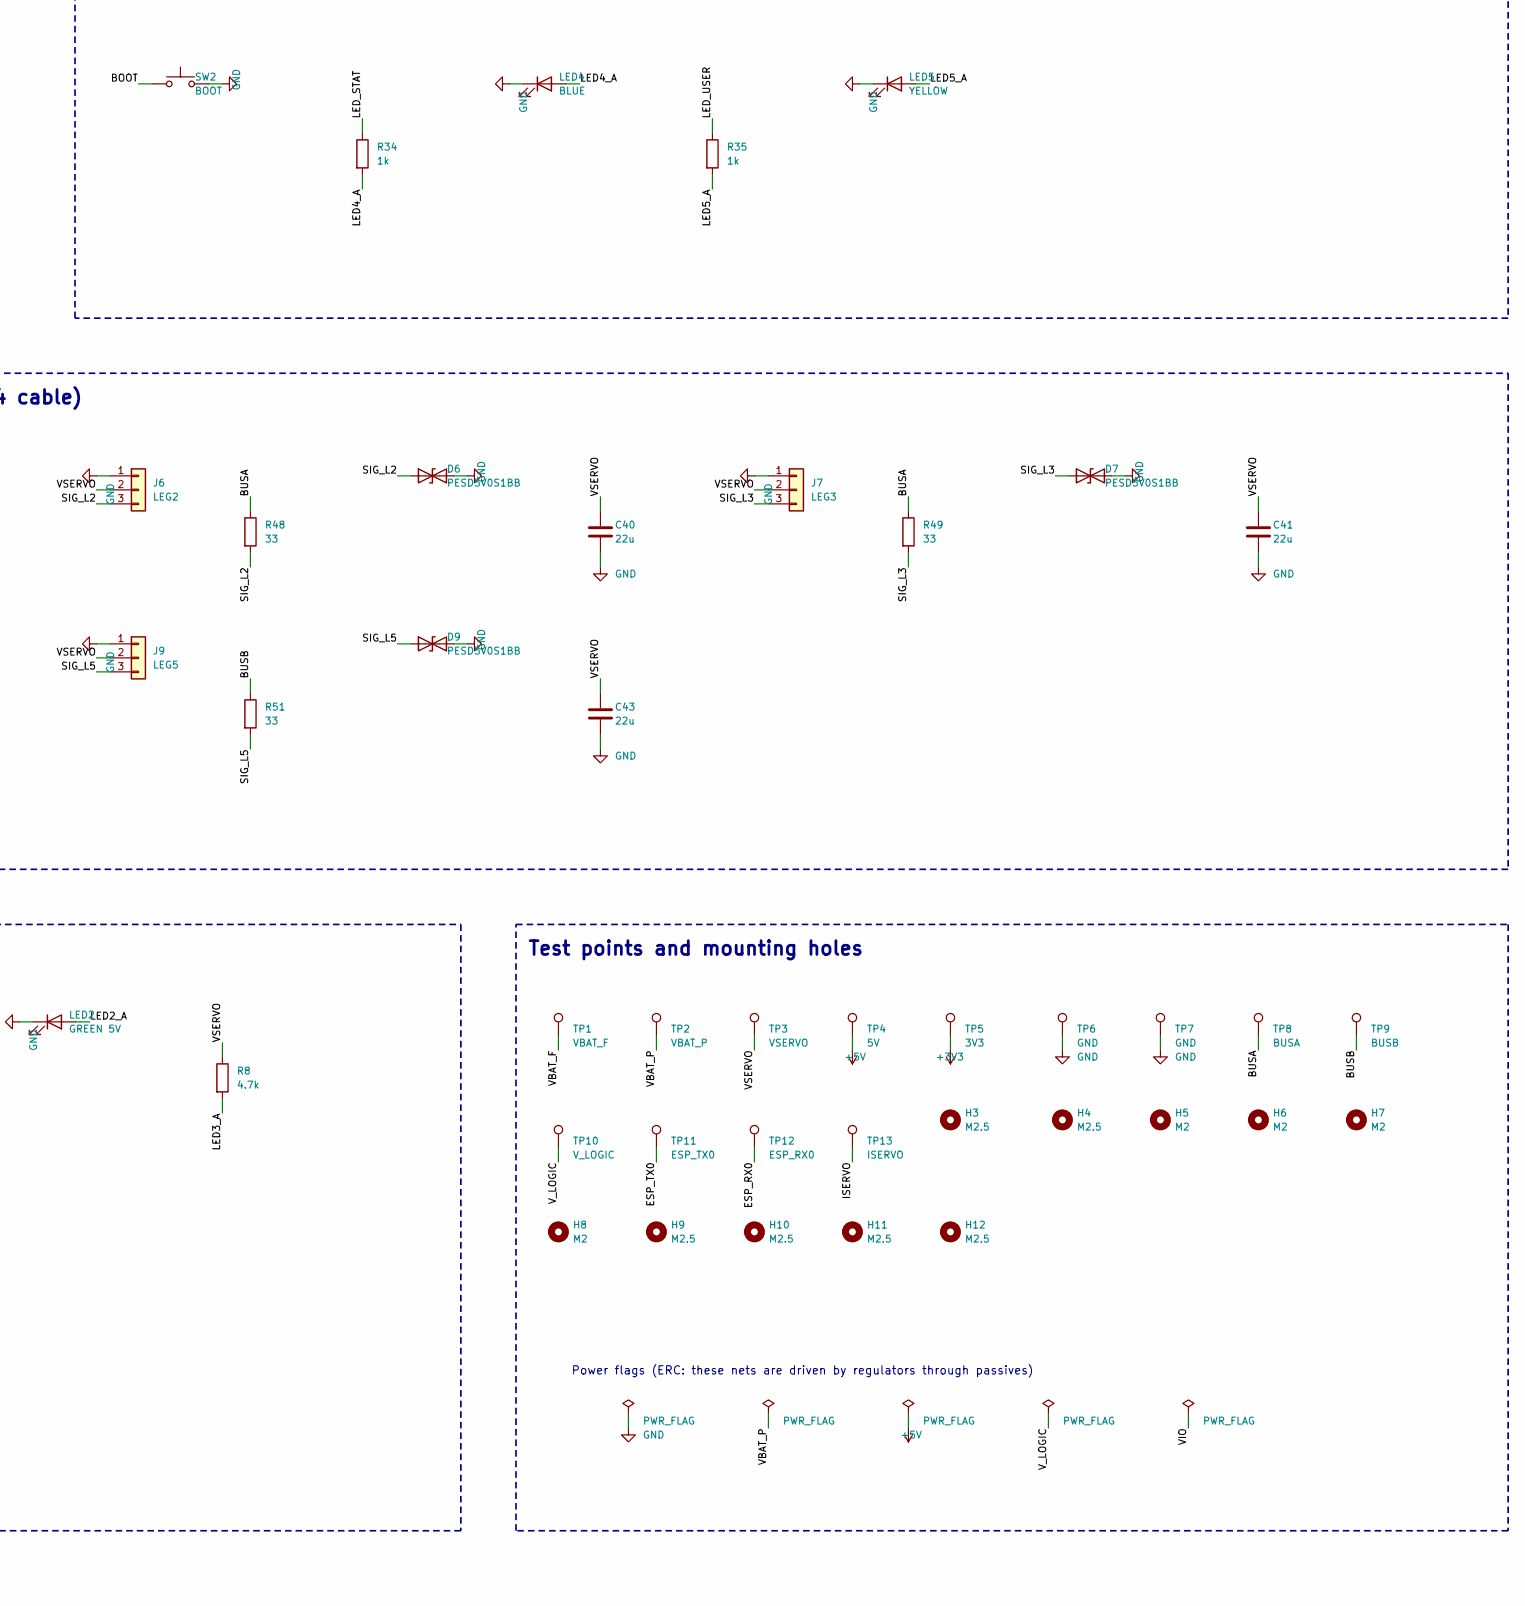
[picture p48: schematic rocky_ctrl.kicad_sch, Rocky pentapod control board, part in row 2, column 3]

Parts:
C1: 220u 35V; CP_Radial_D8.0mm_P3.50mm; MPN Panasonic EEU-FR1V221 (220 uF 35 V, 8x1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
C2, C8, C11, C12, C23: 10u 50V; C_1206_3216Metric; MPN GRM31CR61H106KA12 (10 uF 50 V X5R 1206)
C3: 220n 50V; C_0805_2012Metric; MPN 220 nF 50 V X7R 0805 (Miller soft-start)
C4: 10n; C_0603_1608Metric; MPN 10n; LCSC C57112
C5, C9, C10, C13, C14, C22, C24, C25, C28, C29, C32, C34, C35, C36, C37: 100n; C_0603_1608Metric; MPN 100n; LCSC C14663
C6, C7: 1000u 35V; CP_Radial_D12.5mm_P5.00mm; MPN Panasonic EEU-FR1V102 (1000 uF 35 V, 12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
C15: 3.9n; C_0603_1608Metric; MPN 3.9n
C16: 39p; C_0603_1608Metric; MPN 39p
C17, C18, C19, C20, C26, C27, C31: 22u; C_0805_2012Metric; MPN 22 uF 25 V X5R 0805; LCSC C45783
C30, C38: 1u; C_0603_1608Metric; MPN 1u; LCSC C15849
C39, C40, C41, C42, C43: 22u; C_1206_3216Metric; MPN 22 uF 25 V X5R 1206
D1: SMBJ15A; D_SMB; MPN SMBJ15A (15 V stand-off unidirectional 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
D2: B540C; D_SMC; MPN B540C-13-F (40 V 5 A Schottky, SMC)
D3, D4: SS34; D_SMA; MPN SS34; LCSC C8678
D5, D6, D7, D8, D9: PESD5V0S1BB; D_SOD-323; MPN PESD5V0S1BB (bidirectional ESD, SOD-323)
DZ1, DZ2: BZT52C10; D_SOD-123; MPN BZT52C10 (10 V Vgs clamp)
F1: 20A ATM; Fuseholder_Blade_Mini_Keystone_3568; MPN Keystone 3568 + 20 A mini blade fuse
H3, H4, H9, H10, H11, H12: M2.5; MountingHole_2.7mm_M2.5; MPN M2.5 mounting hole
H5, H6, H7, H8: M2; MountingHole_2.2mm_M2; MPN M2 mounting hole
J1: XT60PW-M; AMASS_XT60PW-M_1x02_P7.20mm_Horizontal; MPN AMASS XT60PW-M
J2: Pi 5V; JST_VH_B3P-VH-B_1x03_P3.96mm_Vertical; MPN JST B3P-VH-B (to USB-C pigtail into the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
J3: USB-C; USB_C_Receptacle_HRO_TYPE-C-31-M-12; MPN HRO TYPE-C-31-M-12; LCSC C165948
J4: Pi GPIO 5-14; IDC-Header_2x05_P2.54mm_Vertical; MPN 2x5 2.54 mm box header (ribbon to Pi pi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
J5: LEG1; Molex_SPOX_5267-03A_1x03_P2.50mm_Vertical; MPN Molex 5267-03A (or 2.50 mm "5264" 3P ve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
J6: LEG2; Molex_SPOX_5267-03A_1x03_P2.50mm_Vertical; MPN Molex 5267-03A (or 2.50 mm "5264" 3P ve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
J7: LEG3; Molex_SPOX_5267-03A_1x03_P2.50mm_Vertical; MPN Molex 5267-03A (or 2.50 mm "5264" 3P ve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
J8: LEG4; Molex_SPOX_5267-03A_1x03_P2.50mm_Vertical; MPN Molex 5267-03A (or 2.50 mm "5264" 3P ve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
J9: LEG5; Molex_SPOX_5267-03A_1x03_P2.50mm_Vertical; MPN Molex 5267-03A (or 2.50 mm "5264" 3P ve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
J10: STEMMA QT; JST_SH_SM04B-SRSS-TB_1x04-1MP_P1.00mm_Horizontal; MPN JST SM04B-SRSS-TB (STEMMA QT to Adafrui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; LCSC C160390
J11: IMU INT/RST; PinHeader_1x02_P2.54mm_Vertical; MPN 1x2 2.54 mm header
J12: SPARE; PinHeader_1x08_P2.54mm_Vertical; MPN 1x8 2.54 mm header
JP1: VIO 3V3|5V; SolderJumper-3_P1.3mm_Bridged12_RoundedPad1.0x1.5mm; MPN solder jumper (default 3.3 V bus)
L1: 4.7u; L_Bourns_SRP1245A; MPN Bourns SRP1245A-4R7M (4.7 uH, Isat 21 A)
L2: 4.7u; L_Bourns_SRN6045TA; MPN Bourns SRN6045TA-4R7M (4.7 uH 3.4 A)
LED1: GREEN 3V3; LED_0603_1608Metric; MPN GREEN 3V3; LCSC C72043
LED2: GREEN 5V; LED_0603_1608Metric; MPN GREEN 5V; LCSC C72043
LED3: RED SERVO; LED_0603_1608Metric; MPN RED SERVO; LCSC C2286
LED4: BLUE; LED_0603_1608Metric; MPN BLUE; LCSC C72041
LED5: YELLOW; LED_0603_1608Metric; MPN YELLOW; LCSC C72038
Q1, Q2: BSC030P03NS3; TDSON-8-1; MPN Infineon BSC030P03NS3G (-30 V, 3.0 mOhm)
Q3, Q5, Q6: MMBT3904; SOT-23; MPN MMBT3904; LCSC C20526
Q4, Q7, Q8: 2N7002; SOT-23; MPN 2N7002; LCSC C8545
R1, R4, R18, R20, R22, R25, R26, R27, R32, R33, R40, R41, R42, R44, R45, R46, R54: 10k; R_0603_1608Metric; MPN 10k 1% 0603; LCSC C25804
R2, R5, R9, R11, R13, R15, R31, R36, R37: 100k; R_0603_1608Metric; MPN 100k 1% 0603; LCSC C25803
R3: 33k; R_0603_1608Metric; MPN 33k 1% 0603; LCSC C4216
R6: 1m; R_Shunt_Vishay_WSK2512_6332Metric_T1.19mm; MPN Vishay WSK25121L000FEA (1 mOhm 1 % 2512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
R7, R29, R30, R34, R35, R38, R55: 1k; R_0603_1608Metric; MPN 1k 1% 0603; LCSC C21190
R8, R52, R53: 4.7k; R_0603_1608Metric; MPN 4.7k 1% 0603; LCSC C23162
R10, R12, R21, R28: 22k; R_0603_1608Metric; MPN 22k 1% 0603; LCSC C31850
R14: 18k; R_0603_1608Metric; MPN 18k 1% 0603
R16: 191k; R_0603_1608Metric; MPN 191k 1% 0603
R17: 53.6k; R_0603_1608Metric; MPN 53.6k 1% 0603
R19: 16k; R_0603_1608Metric; MPN 16k 1% 0603
R23, R24: 5.1k; R_0603_1608Metric; MPN 5.1k 1% 0603; LCSC C23186
R39, R43: 22; R_0603_1608Metric; MPN 22 1% 0603; LCSC C23345
R47, R48, R49, R50, R51: 33; R_0603_1608Metric; MPN 33 1% 0603; LCSC C23140
R56: 2.2k; R_0603_1608Metric; MPN 2.2k 1% 0603; LCSC C4190
SW1: EN; SW_Push_1P1T_XKB_TS-1187A; MPN XKB TS-1187A-B-A-B; LCSC C318884
SW2: BOOT; SW_Push_1P1T_XKB_TS-1187A; MPN XKB TS-1187A-B-A-B; LCSC C318884
TP1: VBAT_F; TestPoint_Pad_D1.5mm; MPN test pad 1.5 mm
TP2: VBAT_P; TestPoint_Pad_D1.5mm; MPN test pad 1.5 mm
TP3: VSERVO; TestPoint_Pad_D1.5mm; MPN test pad 1.5 mm
TP4: 5V; TestPoint_Pad_D1.5mm; MPN test pad 1.5 mm
TP5: 3V3; TestPoint_Pad_D1.5mm; MPN test pad 1.5 mm
TP6, TP7: GND; TestPoint_Pad_D1.5mm; MPN test pad 1.5 mm
TP8: BUSA; TestPoint_Pad_D1.5mm; MPN test pad 1.5 mm
TP9: BUSB; TestPoint_Pad_D1.5mm; MPN test pad 1.5 mm
TP10: V_LOGIC; TestPoint_Pad_D1.5mm; MPN test pad 1.5 mm
TP11: ESP_TX0; TestPoint_Pad_D1.5mm; MPN test pad 1.5 mm
TP12: ESP_RX0; TestPoint_Pad_D1.5mm; MPN test pad 1.5 mm
TP13: ISERVO; TestPoint_Pad_D1.5mm; MPN test pad 1.5 mm
U1: INA180A3; SOT-23-5; MPN INA180A3IDBVR (100 V/V)
U2: TPS54560B; Texas_R-PDSO-G8_EP2.95x4.9mm_Mask2.4x3.1mm_ThermalVias; MPN TPS54560BDDAR
U3: AP63203WU; TSOT-23-6; MPN AP63203WU-7
U4: USBLC6-2SC6; SOT-23-6; MPN USBLC6-2SC6; LCSC C7519
U5: CH340C; SOIC-16_3.9x9.9mm_P1.27mm; MPN CH340C; LCSC C84681
U6: 74LVC1G3157; SOT-363_SC-70-6; MPN SN74LVC1G3157DCKR (S=L: B1=Pi, S=H: B2=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
U7: ESP32-WROOM-32E-N8; ESP32-WROOM-32E; MPN ESP32-WROOM-32E-N8 (8 MB); LCSC C701342
U8, U10: SN74LV1T126; SOT-23-5; MPN SN74LV1T126DBVR (TX driver, OE high)
U9, U11: SN74LV1T125; SOT-23-5; MPN SN74LV1T125DBVR (RX buffer, OE low)

Connections:
+3V3: C5.1, C26.1, C27.1, C28.1, C29.1, C31.1, C32.1, C35.1, C37.1, J10.2, J12.1, JP1.1 (A), L2.2, R31.2, R32.1, R33.1, R40.2, R44.2, R52.2, R53.2, R54.2, R55.1, TP5.1, U1.5 (V+), U3.1 (FB), U5.4 (V3), U5.16 (VCC), U6.5 (VCC), U7.2 (VDD), U9.5 (VCC), U11.5 (VCC)
+5V: C17.1, C18.1, C19.1, C20.1, J2.1, J12.8, JP1.3 (B), L1.2, R17.1, R20.1, R21.1, R56.1, TP4.1
/B3_BST: C25.1, U3.6 (BST)
/B3_SW: C25.2, L2.1, U3.5 (SW)
/B5_BOOT: C14.1, U2.1 (BOOT)
/B5_COMP: C16.1, R19.1, U2.6 (COMP)
/B5_CZ: C15.1, R19.2
/B5_FB: R17.2, R18.1, U2.5 (FB)
/B5_RT: R16.1, U2.4 (RT/CLK)
/B5_SW: C14.2, D2.1 (K), L1.1, U2.8 (SW)
/BOOT: Q6.3 (C), Q8.3 (D), R33.2, SW2.1, U7.25 (IO0)
/BUSA: R39.2, R41.1, R47.1, R48.1, R49.1, TP8.1, U9.2 (A)
/BUSA_DIR: R42.1, U7.26 (IO4), U8.1 (OE), U9.1 (~OE)
/BUSA_RX: R40.1, U7.27 (IO16), U9.4 (Y)
/BUSA_TX: U7.28 (IO17), U8.2 (A)
/BUSA_Y: R39.1, U8.4 (Y)
/BUSB: R43.2, R45.1, R50.1, R51.1, TP9.1, U11.2 (A)
/BUSB_DIR: R46.1, U7.12 (IO27), U10.1 (OE), U11.1 (~OE)
/BUSB_RX: R44.1, U7.11 (IO26), U11.4 (Y)
/BUSB_TX: U7.10 (IO25), U10.2 (A)
/BUSB_Y: R43.1, U10.4 (Y)
/CH_TXD: U5.2 (TXD), U6.1
/DTR: Q6.2 (E), R25.1, U5.13 (~DTR)
/EN: C30.1, Q5.3 (C), Q7.3 (D), R32.2, SW1.1, U7.3 (EN)
/ESP_RX0: TP12.1, U6.4, U7.34 (RXD0/IO3)
/ESP_TX0: R29.1, TP11.1, U5.3 (RXD), U7.35 (TXD0/IO1)
/GPIO5: J12.5, U7.29 (IO5)
/GPIO14: J12.6, U7.13 (IO14)
/GPIO15: J12.7, U7.23 (IO15)
/IMU_INT: J11.1, R54.1, U7.31 (IO19)
/IMU_RST: J11.2, U7.30 (IO18)
/ISERVO: C4.1, R7.2, TP13.1, U7.7 (IO35)
/ISH_N: R6.3, U1.4 (-)
/ISH_P: R6.2, U1.3 (+)
/ISNS_RAW: R7.1, U1.1
/LED1_A: LED1.2 (A), R55.2
/LED2_A: LED2.2 (A), R56.2
/LED3_A: LED3.2 (A), R8.2
/LED4_A: LED4.2 (A), R34.2
/LED5_A: LED5.2 (A), R35.2
/LED_STAT: R34.1, U7.24 (IO2)
/LED_USER: R35.1, U7.16 (IO13)
/PI_ATTN: R38.1, U7.8 (IO32)
/PI_BOOT: J4.9, Q8.1 (G), R37.1
/PI_CC: J2.3, R20.2
/PI_EN: Q4.3 (D), R13.2, R14.1, U2.3 (EN)
/PI_GPIO4: J4.3, R38.2
/PI_PWR_OFF: Q4.1 (G), R15.1, U7.9 (IO33)
/PI_RST: J4.7, Q7.1 (G), R36.1
/PI_RXD: J4.6, R29.2
/PI_TXD: R30.2, R31.1, U6.3
/PI_TXD_RAW: J4.4, R30.1
/Q1_G: DZ1.2 (A), Q1.4 (G), R1.1
/Q2_G: C3.1, DZ2.2 (A), Q2.4 (G), R2.2, R3.1
/Q3_B: Q3.1 (B), R4.2, R5.1
/Q3_C: Q3.3 (C), R3.2
/Q5_B: Q5.1 (B), R25.2
/Q6_B: Q6.1 (B), R26.2
/RTS: Q5.2 (E), R26.1, U5.14 (~RTS)
/SCL: J10.4, J12.4, R53.1, U7.36 (IO22)
/SDA: J10.3, J12.3, R52.1, U7.33 (IO21)
/SERVO_EN: R4.1, U7.37 (IO23)
/SIG_L1: D5.1 (A1), J5.3, R47.2
/SIG_L2: D6.1 (A1), J6.3, R48.2
/SIG_L3: D7.1 (A1), J7.3, R49.2
/SIG_L4: D8.1 (A1), J8.3, R50.2
/SIG_L5: D9.1 (A1), J9.3, R51.2
/USB_CC1: J3.A5 (CC1), R23.1
/USB_CC2: J3.B5 (CC2), R24.1
/USB_DN: J3.A7 (D-), J3.B7 (D-), U4.3 (I/O2), U4.4 (I/O2), U5.6 (UD-)
/USB_DP: J3.A6 (D+), J3.B6 (D+), U4.1 (I/O1), U4.6 (I/O1), U5.5 (UD+)
/USB_PRES: R27.2, R28.1, U6.6
/USB_VBUS: D4.2 (A), J3.A4 (VBUS), J3.A9 (VBUS), J3.B4 (VBUS), J3.B9 (VBUS), R27.1, U4.5 (VBUS)
/V5_SENSE: C22.1, R21.2, R22.1, U7.4 (SENSOR_VP)
/VBAT_F: D1.1 (K), F1.2, Q1.5 (D), TP1.1
/VBAT_IN: F1.1, J1.2
/VBAT_P: C1.1, C2.1, C11.1, C12.1, C13.1, D3.2 (A), DZ1.1 (K), DZ2.1 (K), Q1.1 (S), Q1.2 (S), Q1.3 (S), Q2.1 (S), Q2.2 (S), Q2.3 (S), R2.1, R11.1, R13.1, TP2.1, U2.2 (VIN)
/VBAT_SENSE: C10.1, R11.2, R12.1, U7.6 (IO34)
/VIO: C34.1, C36.1, C38.1, JP1.2 (C), R41.2, R45.2, U8.5 (VCC), U10.5 (VCC)
/VSERVO: C6.1, C7.1, C8.1, C39.1, C40.1, C41.1, C42.1, C43.1, J5.2, J6.2, J7.2, J8.2, J9.2, R6.4, R8.1, R9.1, TP3.1
/VSERVO_SW: C3.2, Q2.5 (D), R6.1
/VSRV_SENSE: C9.1, R9.2, R10.1, U7.5 (SENSOR_VN)
/V_LOGIC: C23.1, C24.1, D3.1 (K), D4.1 (K), TP10.1, U3.2 (EN), U3.3 (IN)
GND: C1.2, C2.2, C4.2, C5.2, C6.2, C7.2, C8.2, C9.2, C10.2, C11.2, C12.2, C13.2, C15.2, C16.2, C17.2, C18.2, C19.2, C20.2, C22.2, C23.2, C24.2, C26.2, C27.2, C28.2, C29.2, C30.2, C31.2, C32.2, C34.2, C35.2, C36.2, C37.2, C38.2, C39.2, C40.2, C41.2, C42.2, C43.2, D1.2 (A), D2.2 (A), D5.2 (A2), D6.2 (A2), D7.2 (A2), D8.2 (A2), D9.2 (A2), J1.1, J2.2, J3.A1 (GND), J3.A12 (GND), J3.B1 (GND), J3.B12 (GND), J3.S1 (SHIELD), J4.2, J4.5, J4.10, J5.1, J6.1, J7.1, J8.1, J9.1, J10.1, J10.MP (MountPin), J12.2, LED1.1 (K), LED2.1 (K), LED3.1 (K), LED4.1 (K), LED5.1 (K), Q3.2 (E), Q4.2 (S), Q7.2 (S), Q8.2 (S), R1.2, R5.2, R10.2, R12.2, R14.2, R15.2, R16.2, R18.2, R22.2, R23.2, R24.2, R28.2, R36.2, R37.2, R42.2, R46.2, SW1.2, SW2.2, TP6.1, TP7.1, U1.2 (GND), U2.7 (GND), U2.9 (GND), U3.4 (GND), U4.2 (GND), U5.1 (GND), U5.15 (R232), U6.2 (GND), U7.1 (GND), U7.15 (GND), U7.38 (GND), U7.39 (GND), U8.3 (GND), U9.3 (GND), U10.3 (GND), U11.3 (GND)

Notes on the sheet:
Battery input: XT60, 20 A fuse, TVS, reverse-polarity P-FET
Servo rail: ESP32-switched P-FET (soft start), current shunt, bulk
5 V / 5 A buck for the Raspberry Pi 5 (TPS54560B)
3.3 V logic buck (diode-OR battery / USB)
USB-C, CH340C, auto-reset, UART0 source mux (USB wins)
ESP32-WROOM-32E
Half-duplex servo buses A (UART1) and B (UART2)
Leg connectors (Molex SPOX 5267 = mates the servo 5264 cable)
Raspberry Pi 5 link (IDC 2x5 to Pi header pins 5-14)
IMU (STEMMA QT), spare header, LEDs, sense dividers
Test points and mounting holes
Power flags (ERC: these nets are driven by regulators through passives)
Rocky control board v1 - see DESIGN.md for the current budget, pin map and placement.

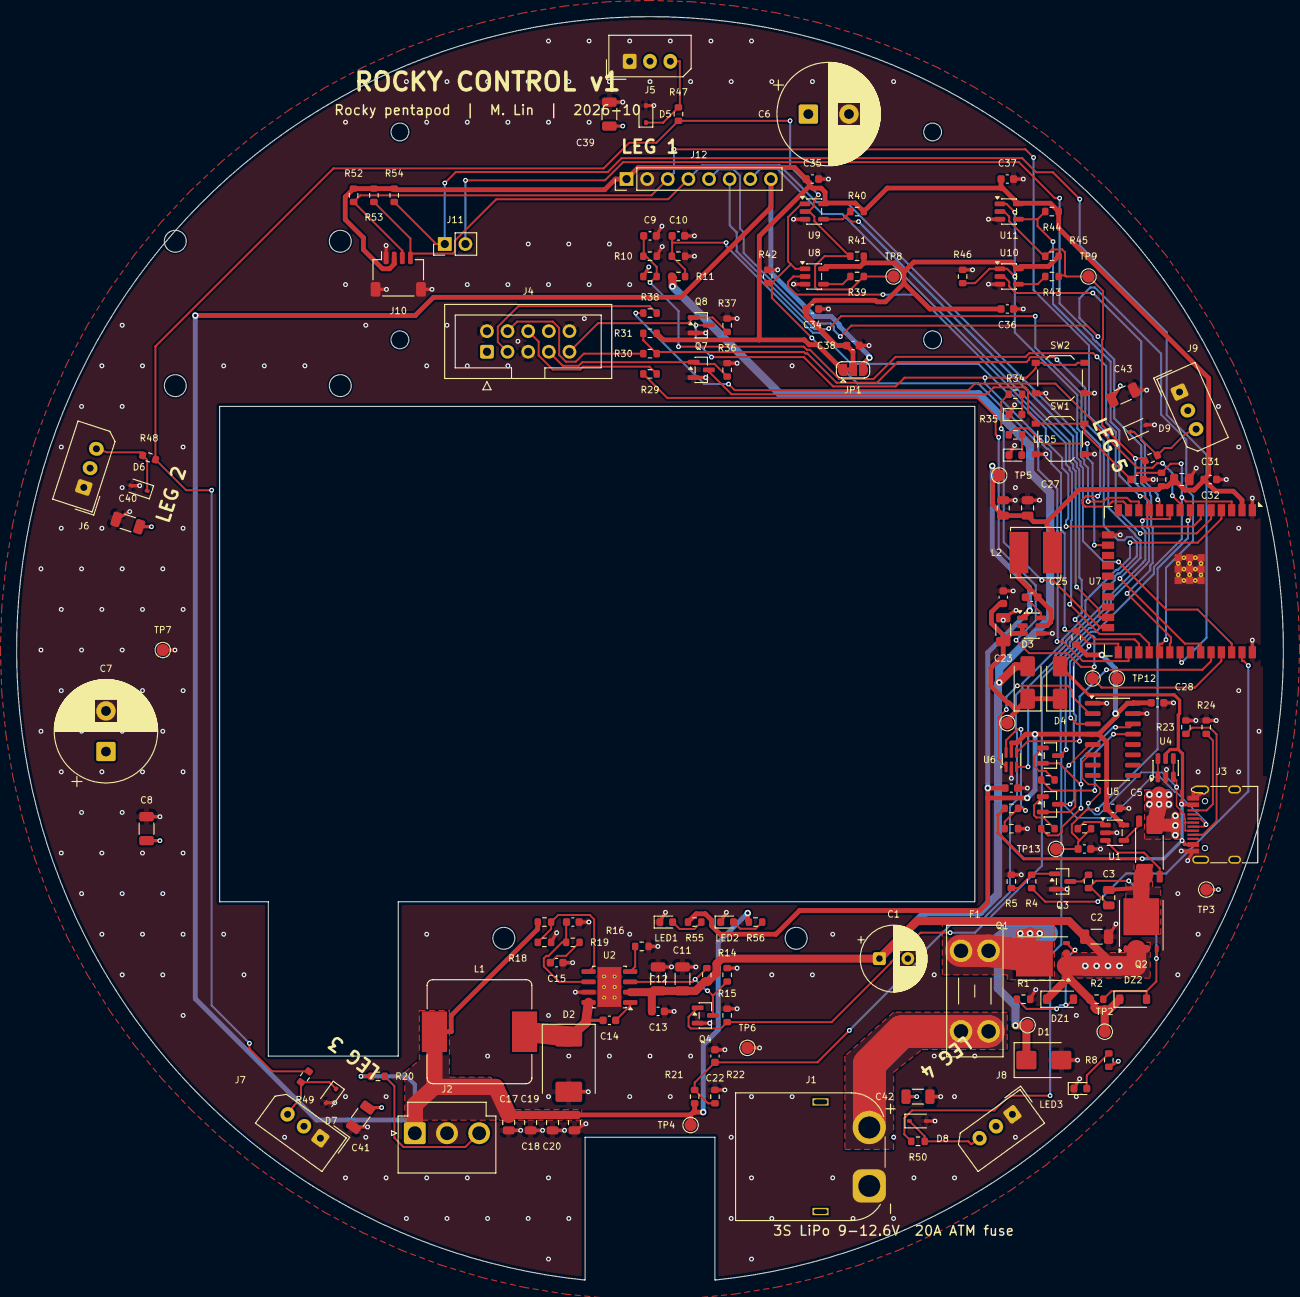
[picture p49: board rocky_ctrl.kicad_pcb from above]

Board: 4 copper layers, 156.0 x 155.6 mm, 173 parts (0 on the bottom side), 84 nets.
