PotatoPeaSea/Rocky/sim/rocky_mujoco/train_mjx.py

"""GPU-parallel PPO for Rocky with MJX + Brax (MuJoCo Playground style). Linux / WSL2 + NVIDIA GPU.

    # in WSL2 (Ubuntu) with an NVIDIA driver installed on Windows:
    pip install "jax[cuda12]==0.9.2" mujoco mujoco-mjx playground brax mediapy
    (tested with jax 0.9.2 / brax 0.14.2 / playground 0.2.0 / mujoco 3.16: jax 0.12 breaks brax 0.14.2)
    python train_mjx.py --num-timesteps 100000000 --num-envs 4096
    python train_mjx.py --impl warp ...                # MuJoCo Warp backend (newer GPUs, faster)
    python train_mjx.py --smoke                        # tiny CPU run to check everything compiles

Writes runs/<name>/params.pkl, params_latest.pkl (last finite checkpoint), checkpoints/params_step_*.pkl
(every eval), progress.csv (every eval), config.json,
and runs/<name>/videos/step_XXXXXXXk.mp4: a 9 s clip (forward, sideways, turn) of the policy at step 0,
at every eval and at the end, so you can watch it improve (--num-evals sets how many).
"""
import os
import sys

if sys.platform.startswith("linux") and not os.environ.get("DISPLAY"):
    os.environ.setdefault("MUJOCO_GL", "egl")      # headless rendering of the rollout video

import argparse
import csv
import functools
import json
import pickle
import time

import jax
import jax.numpy as jp
import numpy as np
from brax.training.agents.ppo import networks as ppo_networks
from brax.training.agents.ppo import train as ppo
from mujoco_playground._src import wrapper

import rocky_mjx_env as R

HERE = os.path.dirname(os.path.abspath(__file__))

# Every progress video runs the same command script, so clips from different checkpoints compare directly.
# (seconds, command (vx, vy, wz), caption, tile (terrain type, level) or None = keep going where it is)
VIDEO_CMDS = [(3.0, (0.0, 0.08, 0.0), "forward 8 cm/s (toward leg 1)", None),
              (3.0, (0.08, 0.0, 0.0), "sideways 8 cm/s", None),
              (3.0, (0.0, 0.0, 0.4), "turn 0.4 rad/s", None)]
# runs with the gait clock: a slow and a fast walk, so the step pattern and speed range both show
GAIT_VIDEO_CMDS = [(3.0, (0.0, 0.10, 0.0), "forward 10 cm/s (toward leg 1)", None),
                   (3.0, (0.0, 0.20, 0.0), "forward 20 cm/s", None),
                   (3.0, (0.15, 0.0, 0.0), "sideways 15 cm/s", None),
                   (3.0, (0.0, 0.0, 0.6), "turn 0.6 rad/s", None)]
# terrain runs: the same three showcase tiles in every clip, walking off the spawn pad at 10 cm/s
TERRAIN_VIDEO_CMDS = [(5.0, (0.0, 0.10, 0.0), "rocks up to 5 cm (level 9)", ("rough", 9)),
                      (6.0, (0.0, 0.10, 0.0), "climbing 4.3 cm stairs (level 6)", ("stairs_dn", 6)),
                      (5.0, (0.0, 0.10, 0.0), "blocks up to 3.3 cm (level 5)", ("blocks", 5))]
# perceptive runs walk camera-first (body -y)
TERRAIN_VIDEO_CMDS_CAM = [(d, (c[0], -c[1], c[2]), lab + ", camera-first", t) for d, c, lab, t in TERRAIN_VIDEO_CMDS]


class VideoRecorder:
    """Rolls out the current deterministic policy on the eval env and writes an MP4 with a caption.
    reset / step / policy are jitted once; params are an argument, so later checkpoints don't recompile."""

    def __init__(self, env, make_policy_fn_holder, folder, segments=VIDEO_CMDS):
        self.env, self.folder, self.segments = env, folder, segments
        self.render_model = None
        tiles = [seg[3] for seg in segments if seg[3] is not None]
        if tiles:                                   # draw only the showcase tiles (see build_render_model)
            import rocky_terrain
            self.render_model = rocky_terrain.build_render_model(env._terrain, tiles)
        self.reset, self.step = jax.jit(env.reset), jax.jit(env.step)
        self.holder = make_policy_fn_holder
        self.policy = jax.jit(lambda p, obs, k: self.holder["make_policy"](p, deterministic=True)(obs, k)[0])
        os.makedirs(folder, exist_ok=True)

    def __call__(self, params, step, total):
        import mediapy
        from PIL import Image, ImageDraw
        t0 = time.time()
        state = self.reset(jax.random.PRNGKey(1))
        traj, labels, rng = [], [], jax.random.PRNGKey(2)
        for dur, cmd, label, tile in self.segments:
            if tile is not None:                    # put the robot on the showcase tile, fixed heading
                lv, tt = jp.int32(tile[1]), jp.int32(self.env._terrain.types.index(tile[0]))
                data, spawn = self.env._spawn(state.data, lv, tt, jax.random.PRNGKey(7))
                state.info.update(level=lv, ttype=tt, spawn=spawn, ep_step=jp.int32(0), respawn=jp.array(False))
                if "cam_p" in state.info:           # camera map starts empty on the new tile
                    state.info.update(self.env._fresh_map(data, jax.random.PRNGKey(8)))
                state = state.replace(data=data)
            for _ in range(int(dur / self.env.dt)):
                state.info["command"] = jp.array(cmd)
                rng, k = jax.random.split(rng)
                state = self.step(state, self.policy(params, state.obs, k))
                traj.append(state)
                labels.append(label)
        if self.render_model is not None:
            from mujoco_playground._src import mjx_env as _mjx_env
            frames = _mjx_env.render_array(self.render_model, traj[::2], height=360, width=640, camera="track")
        else:
            frames = self.env.render(traj[::2], height=360, width=640, camera="track")
        out = []
        for img, label in zip(frames, labels[::2]):
            im = Image.fromarray(np.asarray(img))
            d = ImageDraw.Draw(im)
            d.rectangle([0, 0, 640, 26], fill=(0, 0, 0))
            d.text((8, 7), f"step {step / 1e6:6.1f} M / {total / 1e6:.0f} M   command: {label}", fill=(255, 255, 255))
            out.append(np.asarray(im))
        path = os.path.join(self.folder, f"step_{step // 1000:07d}k.mp4")
        mediapy.write_video(path, out, fps=25)
        print(f"video {path} ({time.time() - t0:.0f} s)", flush=True)
        return path


def main():
    ap = argparse.ArgumentParser()
    ap.add_argument("--num-timesteps", type=int, default=100_000_000)
    ap.add_argument("--num-envs", type=int, default=4096)
    ap.add_argument("--impl", default="jax", choices=["jax", "warp"])
    ap.add_argument("--terrain", default="flat", choices=["flat", "rough", "curriculum"],
                    help="curriculum = rocky_terrain.py rocks / slopes / stairs / blocks with levels (needs --impl warp)")
    ap.add_argument("--name", default="mjx_rocky")
    ap.add_argument("--no-dr", action="store_true")
    ap.add_argument("--scan", default="none", choices=["none", "true", "camera"],
                    help="terrain heights in the policy input: none (blind), true (teacher), camera (simulated OAK-D map)")
    ap.add_argument("--est-obs", action="store_true",
                    help="policy also sees the (noisy) Kalman-filter body velocity + height, like rocky_env estimator=ekf")
    ap.add_argument("--smoke", action="store_true", help="tiny run (CPU ok) to test the pipeline")
    ap.add_argument("--num-evals", type=int, default=10, help="evals = checkpoints = progress videos (plus step 0)")
    ap.add_argument("--no-video", action="store_true", help="skip the progress videos")
    ap.add_argument("--no-gait", action="store_true", help="no gait clock / gait-shaping rewards (runs before 2026-10-21)")
    ap.add_argument("--set", nargs="*", default=[], metavar="KEY=VALUE",
                    help="env config overrides, e.g. reward.scales.feet_clearance=-300 gait.freq=2.0")
    a = ap.parse_args()
    if a.smoke:
        a.num_timesteps, a.num_envs = 20_000, 32

    out = os.path.join(HERE, "runs", a.name)
    os.makedirs(os.path.join(out, "checkpoints"), exist_ok=True)
    cfg = R.default_config()
    cfg.impl = a.impl
    cfg.est_obs = a.est_obs
    cfg.scan = a.scan
    cfg.gait.enabled = not a.no_gait
    for kv in a.set:
        k, v = kv.split("=", 1)
        node = cfg
        for part in k.split(".")[:-1]:
            node = node[part]
        node[k.split(".")[-1]] = type(node[k.split(".")[-1]])(json.loads(v))
    # Warp allocates contacts in ONE pool for all envs of a batch; when it runs out, the envs that come last
    # silently lose contacts and fall through the ground (seen on the terrain with 24 / env, so 64 / env:
    # contacts are cheap). njmax (constraint rows per env) is what costs memory: the solver keeps
    # njmax^2 floats per env, and 208 rows x 4096 envs (+ an eval env sized like the training batch)
    # overflowed the 12 GB GPU, after which WSL pages GPU memory to RAM and training stalls.
    per_env = 64 if a.terrain == "curriculum" else 10
    num_eval_envs = 8 if a.smoke else 128
    cfg.naconmax = per_env * a.num_envs
    cfg.njmax = 160 if a.terrain == "curriculum" else 56
    env = R.RockyJoystick(terrain=a.terrain, config=cfg)
    ecfg = R.default_config()
    ecfg.update(cfg.to_dict())
    ecfg.naconmax = per_env * num_eval_envs
    eval_env = R.RockyJoystick(terrain=a.terrain, config=ecfg)

    net = functools.partial(ppo_networks.make_ppo_networks,
                            policy_hidden_layer_sizes=(256, 128, 128), value_hidden_layer_sizes=(256, 256, 128),
                            policy_obs_key="state", value_obs_key="privileged_state")
    rows, t0 = [], time.time()

    def progress(step, metrics):
        r = {"step": step, "time_s": round(time.time() - t0, 1),
             "eval_reward": float(metrics.get("eval/episode_reward", np.nan)),
             "eval_len": float(metrics.get("eval/avg_episode_length", np.nan))}
        # what each reward term contributed to the eval episode (term sum x scale x dt)
        scales = env._scales()
        for k, v in sorted(metrics.items()):
            if k.startswith("eval/episode_reward/") and k.split("/")[-1] in scales:
                r["r_" + k.split("/")[-1]] = round(float(v) * scales[k.split("/")[-1]] * env.dt, 3)
        rows.append(r)
        print(r, flush=True)
        with open(os.path.join(out, "progress.csv"), "w", newline="") as f:
            w = csv.DictWriter(f, fieldnames=list(rows[0]))
            w.writeheader()
            w.writerows(rows)

    holder = {}
    recorder = None if a.no_video else VideoRecorder(
        eval_env, holder, os.path.join(out, "videos"),
        (TERRAIN_VIDEO_CMDS_CAM if a.scan != "none" else TERRAIN_VIDEO_CMDS) if a.terrain == "curriculum" else (VIDEO_CMDS if a.no_gait else GAIT_VIDEO_CMDS))

    def checkpoint(step, make_policy, params):        # brax: once before training (step 0) and after every eval
        finite = all(bool(np.all(np.isfinite(np.asarray(x)))) for x in jax.tree_util.tree_leaves(params)
                     if np.asarray(x).dtype.kind == "f")
        name = f"params_step_{step // 1000:07d}k.pkl"     # keep every checkpoint, not just the latest
        with open(os.path.join(out, "checkpoints", name), "wb") as f:
            pickle.dump(params, f)
        if not finite:          # never let a diverged checkpoint replace the last good one
            print(f"WARNING: non-finite parameters at step {step}; params_latest.pkl keeps the last good one",
                  flush=True)
            return
        with open(os.path.join(out, "params_latest.pkl"), "wb") as f:
            pickle.dump(params, f)
        if recorder is not None:
            holder["make_policy"] = make_policy
            try:
                recorder(params, step, a.num_timesteps)
            except Exception as e:      # rendering needs EGL/OSMesa; never kill a long run over a video
                print("video skipped:", e, flush=True)

    with open(os.path.join(out, "config.json"), "w") as f:
        json.dump({"args": vars(a), "env_config": cfg.to_dict()}, f, indent=1)

    small = a.smoke
    make_policy, params, _ = ppo.train(
        environment=env, eval_env=eval_env, wrap_env_fn=wrapper.wrap_for_brax_training,
        randomization_fn=None if a.no_dr else R.domain_randomize,
        num_timesteps=a.num_timesteps, num_envs=a.num_envs, episode_length=cfg.episode_length,
        num_evals=2 if small else a.num_evals, num_eval_envs=num_eval_envs,
        unroll_length=20, batch_size=16 if small else 256, num_minibatches=2 if small else 32,
        num_updates_per_batch=4, discounting=0.97, learning_rate=3e-4, entropy_cost=1e-2,
        normalize_observations=True, reward_scaling=1.0, max_grad_norm=1.0, clipping_epsilon=0.2,
        network_factory=net, progress_fn=progress, policy_params_fn=checkpoint, seed=0,
    )
    with open(os.path.join(out, "params.pkl"), "wb") as f:
        pickle.dump(params, f)
    print("saved", out)

    if recorder is not None:
        holder["make_policy"] = make_policy
        recorder(params, a.num_timesteps, a.num_timesteps)


if __name__ == "__main__":
    main()
