PotatoPeaSea/Rocky/pcb/rocky_ctrl/tools/placement.py

"""Footprint placement in the ROBOT frame (mm, +x east, +y = leg 1 direction, CCW degrees).

The board centre is the robot body axis. gen_pcb.py converts to KiCad coordinates (y flipped).
Each entry places the centroid of the footprint's numbered pads at (x, y).
"""
import math


def pol(r, deg):
    a = math.radians(deg)
    return (round(r * math.cos(a), 2), round(r * math.sin(a), 2))


LEG_ANG = {1: 90, 2: 162, 3: 234, 4: 306, 5: 18}
# connector angle on the board edge (leg 3 nudged 6 deg to clear the Pi power connector J2)
LEG_CONN_ANG = {1: 90, 2: 162, 3: 234, 4: 306, 5: 24}
LEG_CONN_R = 72.5
LEG_PART_DR = {3: -5.0, 4: -5.0}

PLACE = {
    # ---------------- battery input / protection (south-east)
    'J1': (27.0, -62.4, 90),
    'F1': (40.0, -42.0, 90),
    'D1': (48.5, -50.5, 0),
    'Q1': (50.5, -38.0, 180),
    'R1': (46.0, -43.0, 0), 'DZ1': (50.5, -43.0, 0),
    'C2': (55.0, -35.3, 0),
    'C1': (30.0, -38.0, 0),
    'R11': (3.5, 46.0, 0), 'R12': (3.5, 48.5, 0), 'C10': (3.5, 51.0, 0),
    # ---------------- servo switch, shunt
    'Q2': (60.5, -36.0, 90),
    'R2': (55.0, -43.0, 0), 'DZ2': (59.5, -43.0, 0),
    'C3': (56.5, -30.5, 90),
    'R3': (54.0, -28.5, 90), 'Q3': (50.5, -28.5, 0), 'R4': (47.0, -28.5, 90), 'R5': (44.5, -28.5, 90),
    'R6': (61.5, -24.5, 90),
    'U1': (57.0, -22.5, 0), 'R7': (53.5, -22.0, 0), 'C4': (53.5, -24.5, 0), 'C5': (57.0, -19.5, 0),
    'C8': (-62.0, -22.0, 90),
    'C6': (22.0, 66.0, 0),
    'C7': (-67.0, -10.0, 90),
    'R9': (0.0, 46.0, 0), 'R10': (0.0, 48.5, 0), 'C9': (0.0, 51.0, 0),
    # ---------------- 5 V buck (south-west)
    'U2': (-5.0, -41.5, 180),
    'C11': (1.0, -40.5, 90), 'C12': (4.0, -40.5, 90), 'C13': (1.0, -44.5, 0),
    'R13': (7.0, -40.0, 90), 'R14': (9.5, -40.0, 90), 'Q4': (6.5, -45.0, 0), 'R15': (9.5, -45.0, 90),
    'R16': (-1.0, -36.5, 0),
    'C14': (-5.0, -45.6, 180),
    'D2': (-10.0, -51.0, -90),
    'L1': (-21.0, -47.0, 180),
    'R17': (-13.0, -33.5, 0), 'R18': (-13.0, -36.0, 0),
    'R19': (-9.5, -36.0, 0), 'C15': (-11.5, -38.5, 0), 'C16': (-9.5, -33.5, 0),
    'C17': (-17.4, -58.2, -90), 'C18': (-14.7, -58.2, -90), 'C19': (-12.0, -58.2, -90), 'C20': (-9.3, -58.2, -90),
    'J2': (-25.0, -59.5, 0),
    'R20': (-33.5, -52.5, 0),
    'R21': (5.5, -55.0, 90), 'R22': (8.0, -55.0, 90), 'C22': (8.0, -50.0, 90),
    # ---------------- 3V3 buck (east strip, west of the ESP32)
    'D3': (46.5, -4.0, 90), 'D4': (50.5, -4.0, 90),
    'U3': (47.0, 3.0, 0), 'C23': (43.5, 2.5, 90), 'C24': (43.5, 6.5, 90), 'C25': (47.0, 6.5, 0),
    'L2': (47.5, 12.0, 0),
    'C26': (43.5, 17.5, 90), 'C27': (46.5, 17.5, 90),
    # ---------------- USB / UART0 (south of the ESP32)
    'J3': (67.5, -21.5, 90),
    'R23': (66.0, -9.5, 90), 'R24': (68.5, -9.5, 90),
    'U4': (63.5, -14.5, 90),
    'U5': (57.0, -11.0, 0),
    'C28': (62.5, -6.5, 0),
    'Q5': (49.0, -13.0, 0), 'R25': (49.0, -16.0, 0), 'Q6': (49.0, -19.0, 0), 'R26': (49.0, -22.0, 0),
    'U6': (44.5, -13.5, 90), 'C29': (44.5, -17.0, 0), 'R27': (44.5, -19.5, 0), 'R28': (44.5, -22.0, 0),
    # ---------------- ESP32 (east, antenna to the board edge)
    'U7': (64.5, 9.0, -90),
    'C30': (60.0, 21.0, 0), 'R32': (63.0, 21.0, 90), 'R33': (52.5, 1.5, 90),
    'C31': (65.5, 21.0, 0), 'C32': (69.0, 21.0, 0),
    'SW1': (50.5, 26.0, 0), 'SW2': (50.5, 33.5, 0),
    'R34': (45.0, 31.5, 0), 'LED4': (45.0, 29.0, 0),
    'R35': (45.0, 26.5, 0), 'LED5': (45.0, 24.0, 0),
    # ---------------- servo bus drivers (north-east)
    'JP1': (25.0, 34.5, 0), 'C38': (25.0, 37.5, 0),
    'U8': (20.0, 46.0, 0), 'U9': (20.0, 54.0, 0), 'R39': (25.5, 46.0, 0), 'R40': (25.5, 54.0, 0),
    'R41': (25.5, 48.5, 0), 'R42': (14.5, 46.0, 90), 'C34': (20.0, 42.0, 0), 'C35': (20.0, 58.0, 0),
    'U10': (44.0, 46.0, 0), 'U11': (44.0, 54.0, 0), 'R43': (49.5, 46.0, 0), 'R44': (49.5, 54.0, 0),
    'R45': (49.5, 48.5, 0), 'R46': (38.5, 46.0, 90), 'C36': (44.0, 42.0, 0), 'C37': (44.0, 58.0, 0),
    # ---------------- Pi link (north band, beside the Pi GPIO header)
    'J4': (-15.0, 38.0, 90),
    'R29': (0.0, 34.0, 0), 'R30': (0.0, 36.5, 0), 'R31': (0.0, 39.0, 0), 'R38': (0.0, 41.5, 0),
    'Q7': (6.0, 34.5, 0), 'Q8': (6.0, 40.0, 0), 'R36': (9.5, 34.5, 90), 'R37': (9.5, 40.0, 90),
    # ---------------- IMU / spare IO / LEDs
    'J10': (-31.0, 47.0, 0), 'J11': (-24.0, 50.0, 90),
    'R52': (-36.5, 56.0, 90), 'R53': (-34.0, 56.0, 90), 'R54': (-31.5, 56.0, 90),
    'J12': (6.0, 58.0, 90),
    'LED1': (2.0, -33.5, 0), 'R55': (5.5, -33.5, 0),
    'LED2': (9.5, -33.5, 0), 'R56': (13.0, -33.5, 0),
    'R8': (56.5, -50.5, 90), 'LED3': (53.0, -54.0, 0),
}

# test points (robot frame)
TP_PLACE = {
    'TP1': (46.5, -46.2), 'TP2': (56.0, -47.0), 'TP3': (68.5, -29.5), 'TP4': (5.0, -58.5),
    'TP5': (43.0, 21.5), 'TP6': (12.0, -49.0), 'TP7': (-60.0, 0.0), 'TP8': (30.0, 46.0),
    'TP9': (54.0, 46.0), 'TP10': (44.0, -9.0), 'TP11': (54.5, -3.5), 'TP12': (57.5, -3.5),
    'TP13': (50.0, -24.5),
}


def leg_parts():
    """Leg connector + series R + ESD + 22u cap, laid out radially inward of each connector."""
    out = {}
    for leg in range(1, 6):
        a = LEG_CONN_ANG[leg]
        cx, cy = pol(LEG_CONN_R, a)
        rot = a - 90
        out['J%d' % (4 + leg)] = (cx, cy, rot)
        ur = (math.cos(math.radians(a)), math.sin(math.radians(a)))
        ut = (-ur[1], ur[0])

        def at(dr, dt):
            return (round(cx + ur[0] * dr + ut[0] * dt, 2), round(cy + ur[1] * dr + ut[1] * dt, 2))
        dr = LEG_PART_DR.get(leg, -6.5)
        out['R%d' % (46 + leg)] = at(dr, -3.5) + (rot + 90,)
        out['D%d' % (4 + leg)] = at(dr, 0.5) + (rot + 90,)
        out['C%d' % (38 + leg)] = at(dr, 5.0) + (rot + 90,)
    return out


PLACE.update(leg_parts())
# leg 4 support parts sit west of the connector (the TVS/Q1 area is inward of it)
PLACE.update({'C42': (33.0, -55.0, 0), 'D8': (33.0, -58.0, 0), 'R50': (33.0, -60.5, 0)})
