PotatoPeaSea/Rocky/(commit log)

2026-10-19 Import v5 Fusion build scripts, BOM and design notes
    [Pentapod_BOM_v5.xlsx]
2026-10-19 v6: remove modelled wiring and v5 module electronics; add PCB mounting envelope
2026-10-19 Add MuJoCo sim: MJCF model, servo actuator model, leg IK, wave/ripple gait, Gymnasium env, SB3 PPO and MJX/Brax training
    [base_chassis.stl, base_dome.stl, base_hip_servos.stl, battery.stl, leg_coxa.stl, leg_femur.stl, leg_foot.stl, leg_tibia.stl]
2026-10-19 WIP: control PCB schematic, placement and power routing (signal routing unfinished)
    [AMASS_XT60PW-M.step, CP_Radial_D12.5mm_H20.step, CP_Radial_D8.0mm_H11.5.step, JST_VH_B3P-VH-B.step, L_Bourns_SRP1245A.step, Molex_SPOX_5267-03A.step, SW_XKB_TS-1187A.step, USB_C_HRO_TYPE-C-31-M-12.step]
2026-10-20 Control PCB v1: routed 4-layer ring board, ERC/DRC clean, STEP and JLCPCB fab outputs
    [rocky_ctrl-B_Cu.gbl, rocky_ctrl-B_Mask.gbs, rocky_ctrl-B_Paste.gbp, rocky_ctrl-B_Silkscreen.gbo, rocky_ctrl-Edge_Cuts.gm1, rocky_ctrl-F_Cu.gtl, rocky_ctrl-F_Mask.gts, rocky_ctrl-F_Paste.gtp]
2026-10-20 v6: place control PCB on deck, restack BNO085 on spacers, drop unused v5 mounts
2026-10-20 Add independent PCB review (1 blocker: LCSC part assignment; 4 should-fix)
2026-10-20 v7 CAD: Luxonis OAK-D Lite depth camera on a camera-mount dome apex cap
    fusion/pentapod_camera_v7.py runs on the v6 design (reuses its helpers): places the vendor
    OAK-D Lite STEP facing -y (gap between legs 3 and 4), 15 deg nose-down, and replaces the
    apex cap with one printed part carrying a pedestal, a back plate on the camera's M4 VESA
    pair (75 mm) and a USB-C plug pass-through into the dome. Saved in Fusion as
    'Pentapod Walker v7'; v6 is unchanged.
    Verified in Fusion: BRep intersections of the cap, camera shells and a USB-C plug+cable
    envelope against every other body are all zero volume (an earlier camera position clipped
    Dome Sector 3 with the plug; moved 6 mm back).
    [pentapod_camera_v7.py]
2026-10-20 v7 CAD: create the camera occurrence at its pose before importing the STEP
    Setting occ.transform after importing the OAK-D Lite STEP left its nested sub-assemblies
    (front cover + lens glass, case screws) at different placements than the back cover.
    stage_camera now deletes any old camera occurrence, creates it at cam_M() and imports into
    it, as the v6 place_part does.
    Verified in Fusion: all 13 camera bodies share one rigid placement (bounding boxes match the
    intended pose); BRep intersection of every camera body and the USB-C plug envelope with the
    dome bodies (the only top-level occurrence near the camera) is zero. Saved 'Pentapod Walker v7'.
2026-10-20 Sim: OAK-D Lite depth camera + ESKF fusing IMU, servo encoders and camera
    - build_model.py --camera-export: v7 camera body (61 g + 14.4 g mount over the v6 cap,
    total 2.582 kg), its collision box, and a MuJoCo camera 'oakd' at the RGB/depth optical
    centre (73 x 58 deg). Floor is now a finite 20 x 20 m plane: MuJoCo draws a zero-size
    plane as a patch that follows the camera, which broke image motion.
    - rocky_sensors.py (sim only): rendered depth with OAK-D stereo noise (disparity noise,
    1/8 px sub-pixel, holes at edges and dropouts), and BNO085 noise + bias.
    - rocky_vision.py (robot side): RANSAC ground plane (tilt, height) and RGB-D visual
    odometry (KLT + inverse-depth lift + RANSA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
    [camera_mount_cap.stl, camera_oakd_lite.stl, rocky.xml, scene.xml]
2026-10-20 RL env: optional Kalman-filter observation (estimator=ekf|ekf_cam); README for camera + estimator
    RockyEnv(estimator=...) runs the IMU at 250 Hz inside the physics substeps, updates the ESKF
    from the servo encoders every control step and (ekf_cam) from the rendered OAK-D Lite at
    25 Hz with 40 ms latency, and appends estimated body velocity + height to the observation
    (54 -> 58). The camera collision box counts as a body hit. train_ppo.py / play_policy.py
    take --estimator. Estimator: 3-vector cross / cached Q (664 -> 778 env steps/s), and a
    leg-odometry gate that cannot lock out after pushes.
    Verified: gymnasium check_env passes for none / ekf / ekf_cam; standing under DR pushes the
    estimate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
    [play_policy.py, rocky_env.py, rocky_estimator.py, train_ppo.py]
2026-10-20 GPU training on WSL2 (RTX 3060): setup/run scripts, Warp backend, progress videos, est-obs
    - wsl_setup.sh: no-sudo setup inside WSL Ubuntu: uv Python 3.12 venv ~/rocky, pip install of
    JAX 0.9.2 CUDA 12, MuJoCo/MJX/Warp 3.16, Brax 0.14.2, Playground 0.2.0, ffmpeg link.
    (uv rejects some NVIDIA wheels; an interrupted install left a truncated libnccl.so.2
    that crashed JAX with SIGBUS.)
    - wsl_run.sh: no VRAM preallocation (Windows apps hold ~8 of 12 GB), filters XLA's WSL
    driver-version log noise, tees to runs/wsl_last.log. .gitattributes keeps *.sh LF.
    - train_mjx.py: params_latest.pkl + progress.csv at every eval, config.json, and a 9 s
    tracking-camera clip (forward / sideways / turn,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
    [scene.xml, scene_rough.xml]
2026-10-20 Live training window (watch_training.py) + automatic dashboard recordings
    watch_training.py polls a train_mjx.py run folder: newest progress clip looping, eval-reward
    curve, step / ETA; arrow keys browse older clips; --record saves one loop to MP4 (streamed,
    low RAM). wsl_watch.sh runs it inside WSL (WSLg window), because Windows RAM ran out during
    training (OpenBLAS / numpy allocations failed). wsl_record_dashboard.sh records it when a run
    passes given step thresholds and at the end.
    Verified: --record on runs/mjx_big (3 clips, 43M steps) wrote a 225-frame MP4 whose frame shows
    the clip, curve and ETA; the live window and the recorder are running on runs/mjx_300m.
    [watch_training.py]
2026-10-20 watch_training: keep retrying the newest clip until it loads
    The window only tried to load a clip when the file list changed and skipped clips under 3 s
    old (still being written), so a fresh clip was never shown (black panel). It now remembers
    the loaded (path, mtime) and retries the newest clip every poll.
    Verified: --record on runs/mjx_300m now shows the step-0 clip (it was black in the live window).
    [watch_training.py]
2026-10-21 Terrain curriculum for blind rough-terrain training; eval_mjx.py; training log with videos
    - rocky_terrain.py: 24 x 40 m heightfield of 4 m tiles, 6 types (rocks, slope up/down, stairs
    up/down 1-6 cm risers, blocks) x 10 levels, flat spawn pads, zero-height tile borders;
    MJX collision primitives (capsules / cylinders: Warp has no hfield-box/mesh contact) and
    contact sensors; render-only model with just the showcase tiles (video frames drew the whole
    1.5 M-cell heightfield, ~6 min per clip -> 61 s).
    - rocky_mjx_env.py terrain="curriculum": per-env level kept in info across auto-resets, up /
    down after each episode, respawn by teleport (qpos/qvel only: Warp contact buffers can't be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
    [eval_mjx.py, rocky_mjx_env.py, rocky_terrain.py, train_mjx.py]
2026-10-21 Blind terrain policy (mjx_terrain2): results vs flat baseline; NaN guards and kept checkpoints
    The first 200 M-step terrain run diverged at 202 M: one simulated robot blew up, its NaN
    observations reached the shared observation normaliser and the loss, every weight went NaN and
    Brax crashed; only the latest (already NaN) checkpoint was kept.
    - rocky_mjx_env.py: an env with non-finite state or |qvel| > 100 rad/s ends; observations and
    rewards are NaN/inf-scrubbed and clipped before they reach the normaliser / loss.
    - train_mjx.py: every checkpoint kept (checkpoints/params_step_*.pkl); a non-finite one is
    flagged and never replaces params_latest.pkl.
    - eval_mjx.py: 64 contacts per env in t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
    [rocky_mjx_env.py, train_mjx.py, watch_training.py]
2026-10-21 Robot-side elevation map from OAK-D depth + estimator pose
    rocky_vision.ElevationMap: 2 cm grid in the odometry frame (3 m, recentred as the robot moves),
    inverse-variance fusion of depth points with range-dependent stereo noise, per-cell restart on
    large innovations, self-mask of the robot's own legs. scan() returns the same 13x13 body-yaw
    height scan + known-mask as the policy's scan="camera" observation.
    Verified with elevation_demo.py (CPU, kinematic walk camera-first over stair pits L3/L6/L9,
    rocks L9, blocks L6, noisy depth, xy pose drift 5 mm/sqrt(s)): 94 % of the camera half of the
    grid known, mean error 1.6-4.2 mm, p95 3-24 mm (stair edges); with exact pose 0.4-2.4 mm.
    The training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
    [elevation_demo.py, rocky_vision.py]
2026-10-21 Stage 2: terrain-height scans for the policy, teacher training and DAgger student distillation
    rocky_mjx_env scan modes (curriculum terrain):
    - scan=true: policy also sees a 13x13 grid (6 cm spacing) of base height above the exact terrain.
    - scan=camera: the same grid as the OAK-D would map it - only cells inside the camera frustum of
    a recent pose history (every 5 steps, 40 poses), range-dependent noise, per-episode pose-drift
    bias, plus a known-mask; teacher_state carries the exact-scan observation for distillation.
    Commands are sampled camera-first (within 45 deg of body -y).
    train_mjx --scan true|camera; video recorder resets the camera map on each showcase tile.
    eval_mjx: --dir=+y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
    [distill_mjx.py, eval_mjx.py, rocky_mjx_env.py, train_mjx.py]
2026-10-21 Stage 2 results: teacher and camera-map student climb stairs the blind policy can't
    runs/mjx_student: distill_mjx.py from runs/mjx_teacher, 60 M steps in 70 min (1024 envs x 40
    steps; 2048 envs ran out of GPU memory with another process holding ~5.8 GB). Imitation MSE
    0.12 -> 0.0015-0.003.
    Verified with eval_mjx.py --terrain --dir=-y (128 rollouts per cell, all camera-first), success
    blind / teacher / student: stairs climbing L3 2 / 43 / 33 %, slope pit L9 12 / 99 / 91 %, stairs
    down L9 17 / 29 / 55 %, blocks L9 46 / 74 / 73 %; climbing 4.3-6 cm risers still unsolved.
    compare_stairs.py: side-by-side video of several policies on the same stair pit from the same
    start, fixed side camera (rol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
    [compare_stairs.py, eval_mjx.py]
2026-10-21 Training log: correct the stair video claims and record the gait problem
    The side-by-side stair clip does not show convincing climbing: re-measured from its saved rollouts
    (media/training/compare_stairs_L3.npz) the robots rise 4 / 7 / 7 cm by scraping up 2.7 cm steps,
    and the re-run's counts are 0 / 5 / 5 of 8 headings (GPU runs are not bit-reproducible).
    Gait statistics from the same rollouts (foot clearance vs terrain, step counts, joint reversals):
    2.5 cm strides at 3-4 Hz, two legs barely stepping while one paddles at ~8 Hz, joints reversing
    ~24 times/s, median swing height 1.6 cm (below the riser). Cause: almost no gait-shaping reward.
2026-10-21 Gait clock and gait-shaping rewards: from skating to a five-leg wave gait on flat ground
    rocky_mjx_env (gait.enabled, default on; --no-gait / old configs keep the previous env):
    1.5 Hz phase in the observation, swing schedule 1,3,5,2,4 (two non-adjacent legs up, three down),
    rewards for following it (gait_contact), swing-foot height profile and stance feet on the ground
    (feet_clearance), penalties on planted-foot slip (feet planted this step and the last), action
    second difference and joint acceleration; coarse + fine velocity tracking; commands to 25 cm/s.
    train_mjx: per-term reward contributions in progress.csv, --set overrides, gait video script.
    eval_mjx / distill_mjx: take the gait sett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
    [distill_mjx.py, eval_mjx.py, gait_check.py, rocky_mjx_env.py, train_mjx.py]
2026-10-22 Height-scan teacher with the new gait climbs 4.3 cm stairs (84 %, was 9 %)
    runs/mjx_teacher2: --scan true terrain teacher retrained with the gait clock and gait-shaping
    rewards (swing target 5 cm on terrain), 120 M steps in 2 h.
    Verified with eval_mjx.py --terrain --dir=-y (128 rollouts per cell): stairs climbing L3/L6/L9
    100/84/10 % (old teacher 43/9/1), blocks L9 95 % (74), slope pit L9 98 %; walking down a 15 deg
    slope 82 % (99). compare_stairs.py: 8/8 and 7/8 headings out of the 2.7 and 4.3 cm pits (old
    teacher 3/8, 2/8). gait_check.py on the 4.3 cm pit: 13.6 of 15 cm/s, all legs stepping, swing
    feet 5.3 cm at the 90th percentile.
    gait_check.py runs height-scan policies on a flat terrai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
2026-10-22 Camera-map student of the new teacher: 80 % up 4.3 cm stairs from the simulated OAK-D map
    runs/mjx_student2: distill_mjx.py from runs/mjx_teacher2, 60 M steps in 75 min, imitation MSE
    0.068 -> 0.002.
    Verified with eval_mjx.py --terrain --dir=-y: stairs climbing L3/L6/L9 100/80/12 % (teacher
    100/84/10, old student 33/12/0), blocks L9 98 %, walking down 15 deg 94 % (teacher 82).
    compare_stairs.py on the 4.3 cm pit: blind 0/8, old student 1/8, new student 7/8 headings out.
    gait_check.py: 13.2 of 15 cm/s on the 4.3 cm pit with swing feet 5.5 cm at p90; 14.5 cm/s on flat.
    TRAINING_LOG.md step 7 with videos and the limits (camera-first only, marches when told to stand,
    6 cm risers 12 %, simulatio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
